myriadrf/LMS8001-Companion/docs/software/lms8suite.rst

LMS8 Suite
==========

LMS8 Suite is a cross-platform software tool for controlling the LMS8001 Companion board. It provides a graphical user interface (GUI) for configuring and managing the board's settings. The source code is provided and the GUI can be built under Windows and Linux. Additionally, a precompiled binary is available for Windows. 

* `LMS8 Suite GitHub repository`_
* `LMS8 Suite Windows download`_ 

.. note::
   Windows drivers and installation instructions are provided in the ``drivers\`` sub-directory.
