myriadrf/LMS8001-Companion/docs/reading/index.rst

Further Reading
===============

Please see also the following documentation:

* `LMS8001 Companion Board Quick Starter Manual`_
* `LMS8001 Companion Board Mixer Channel Programs Configuration`_
* `LMS8001 Companion Board Settling Times for Mixer Channel Programs Configuration`_
* `LMS8001 Documentation`_

.. _LMS8001 Companion Board Quick Starter Manual: https://downloads.myriadrf.org/project/lms8001-companion/LMS8001A_Companion_Quick_Starter_Manual_v2.pdf
.. _LMS8001 Companion Board Mixer Channel Programs Configuration: https://downloads.myriadrf.org/project/lms8001-companion/MixerChannelPrograms.pdf
.. _LMS8001 Companion Board Settling Times for Mixer Channel Programs Configuration: https://downloads.myriadrf.org/project/lms8001-companion/SettlingTimesForMixerChannelPrograms_v2.pdf
.. _LMS8001 Documentation: https://github.com/myriadrf/lms8001-docs
