myriadrf/LMS8001-Companion/hardware/3v1/KiCAD/12402143E512A_libs/12402143E512A.step

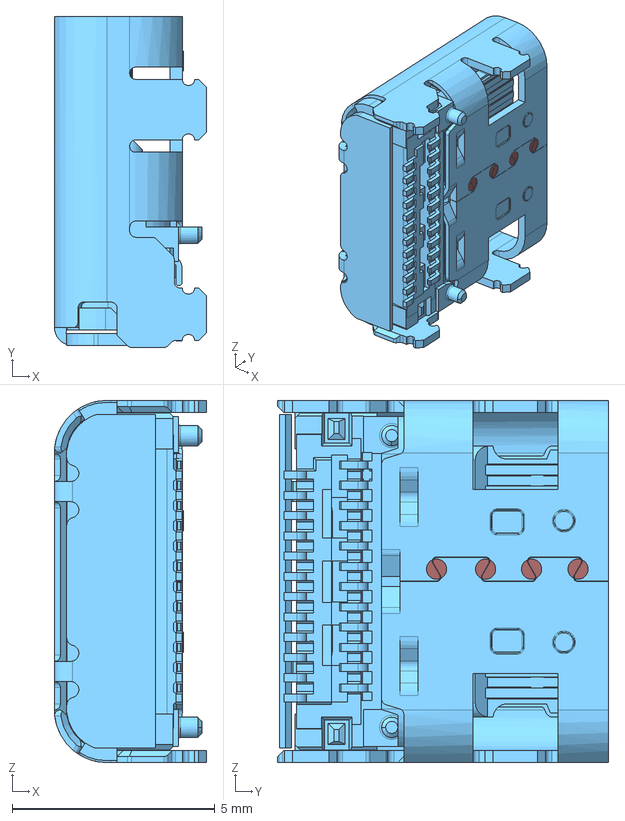
[picture p2: CAD file, 2025-08-01]
hardware/3v1/KiCAD/12402143E512A_libs/12402143E512A.step
3.76 x 8.17 x 8.94 mm
