myriadrf/LMS8001-Companion/drivers/Windows11_Driver_Installation.pdf

Windows 11 Driver Installation

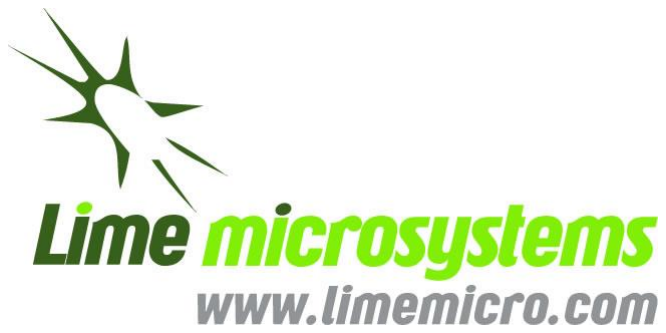
[picture p3: figure]

Lime Microsystems Limited

Surrey Technology Centre
Occam Road
The Surrey Research Park
Guildford, Surrey GU2 7YG
United Kingdom
Tel: | +44 (0) 1483 685 063
e-mail: | enquiries@limemicro.com

# LMS8001 Companion Board Windows 11 Driver Installation

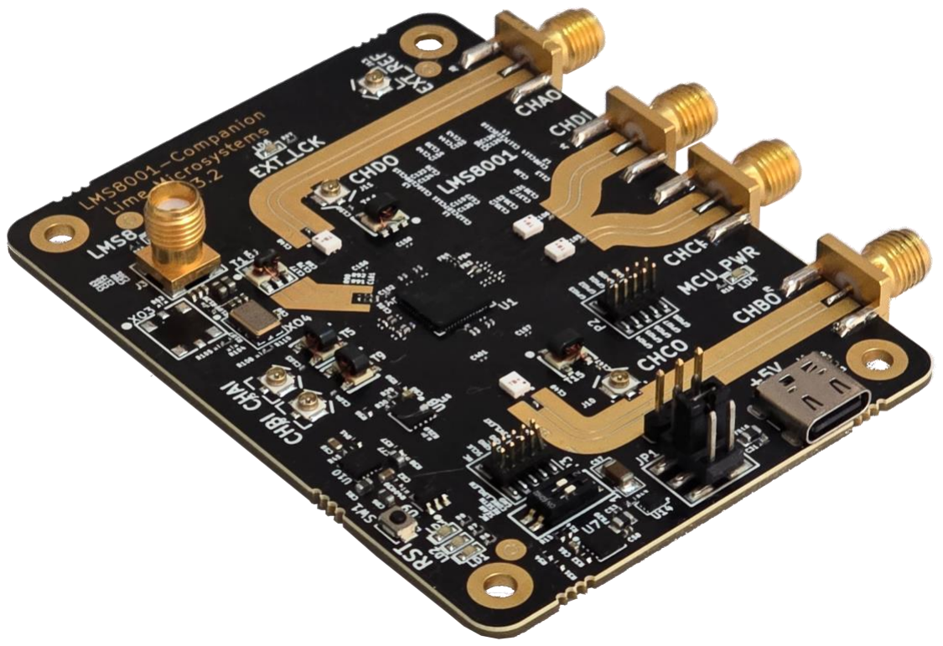
[picture p4: figure]

The information contained in this document is subject to change without prior notice. Lime Microsystems assumes no responsibility for its use, nor for infringement of patents or other rights of third parties. Lime Microsystems' standard terms and conditions apply at all times.

# DOCUMENT REVISION HISTORY

The following table shows the revision history of this document:

Date | Version | Description of Revisions
21/09/2026 | 1.0.0 | Initial version created.
05/10/2626 | 1.1.0 | Figures updated, text updated.

# Contents

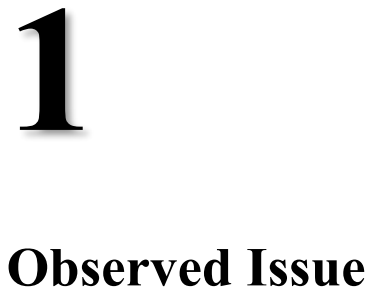
[picture p5: figure]
Observed Issue
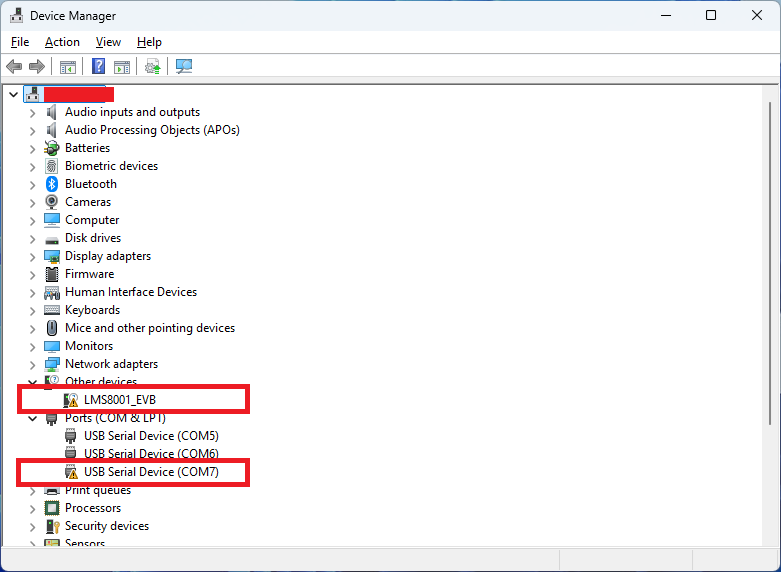
[picture p6: figure]

© Copyright Lime Microsystems

Version: 1.1.0 | Last modified: 05/10/2026 | 1

On Windows 11, when the evaluation board is connected to the computer, Device Manager shows the following:

Figure 1.1: Device Manager before driver installation

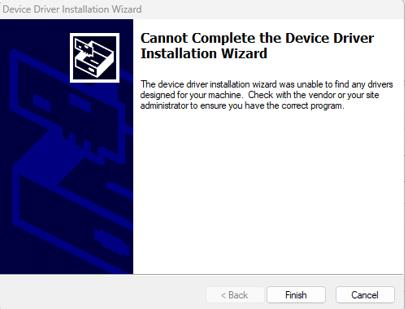
[picture p7: figure]

© Copyright Lime Microsystems Proprietary and Confidential

When the driver installation was tried using the dpinst_amd64.exe file, the installation failed.

Figure 1.2: Driver installation failed

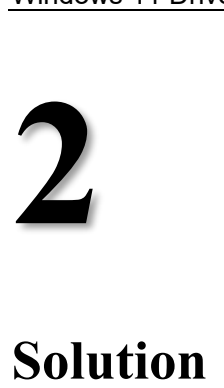
[picture p8: figure]
Solution
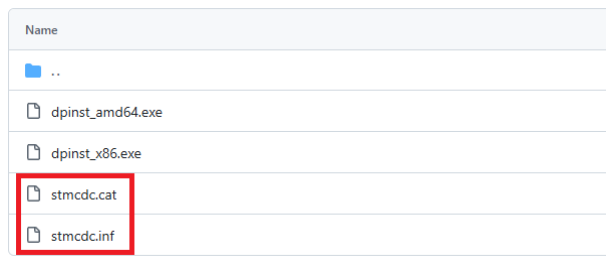
[picture p9: figure]

© Copyright Lime Microsystems

Install the driver manually. Download the .inf and .cat files from the link below: https://github.com/myriadrf/LMS8001-Companion/tree/master/drivers/STM32_VCP/Win8

Figure 2.1: Marked files for manual driver installation

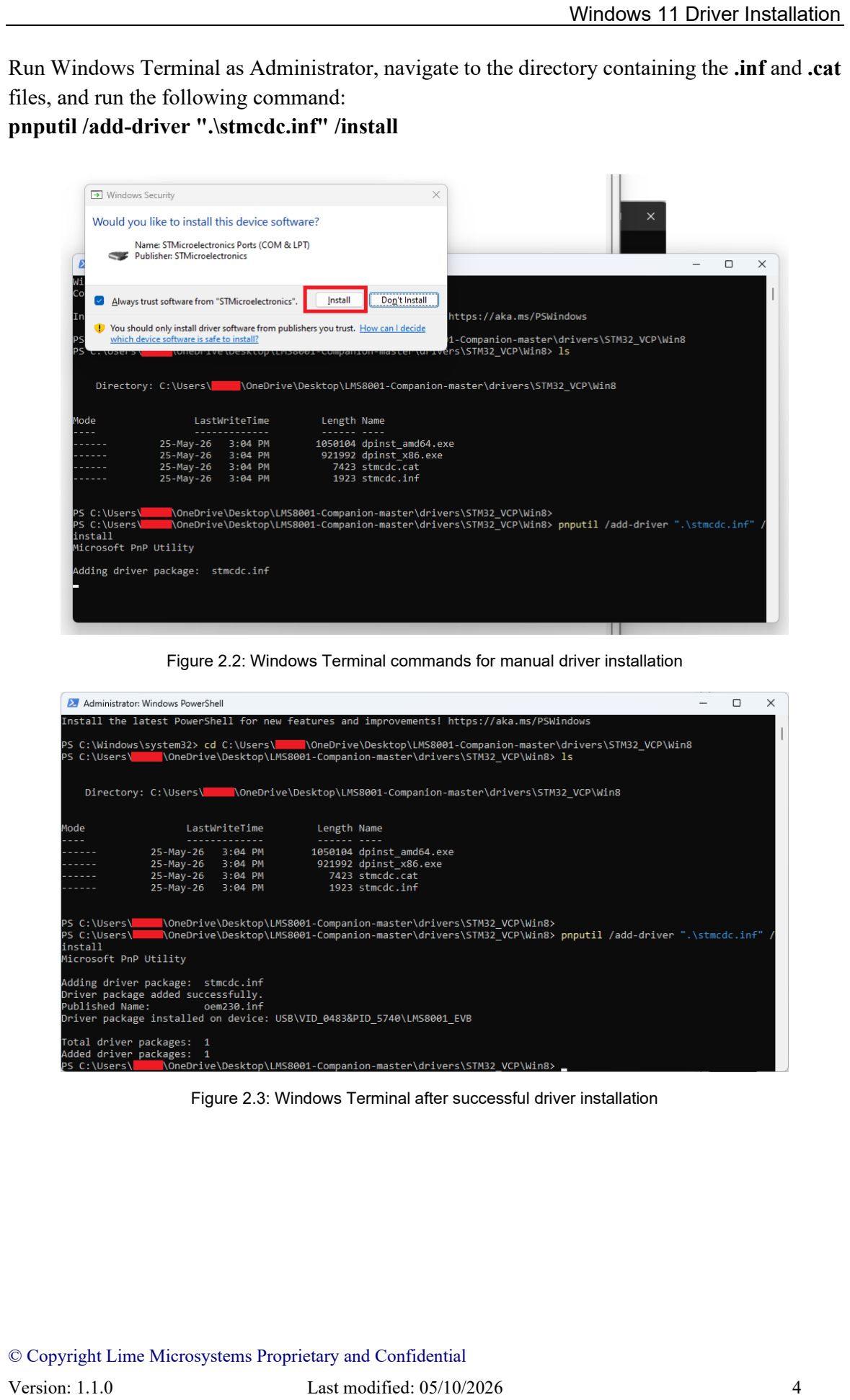
[picture p10: page 6]

© Copyright Lime Microsystems Proprietary and Confidential

Run Windows Terminal as Administrator, navigate to the directory containing the .inf and .cat files, and run the following command:
pnputil /add-driver ".\stmcdc.inf" /install

Figure 2.2: Windows Terminal commands for manual driver installation

Figure 2.3: Windows Terminal after successful driver installation

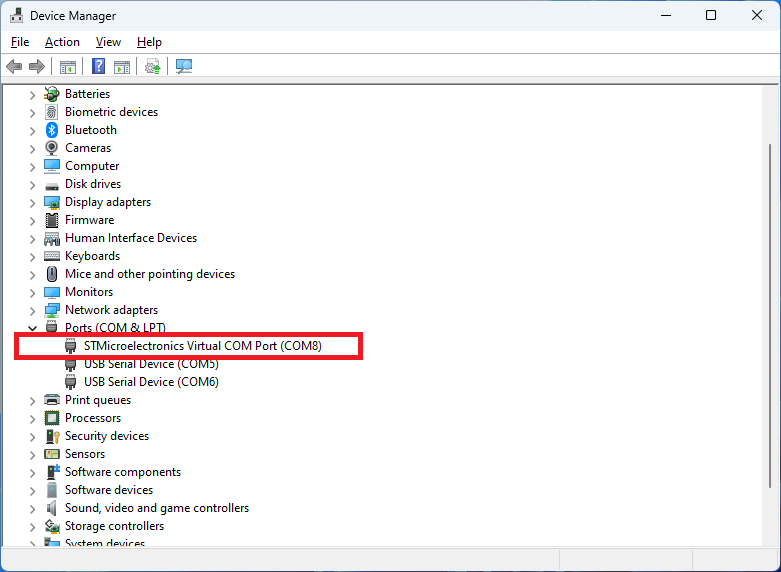
[picture p11: figure]

© Copyright Lime Microsystems

After this, Device Manager should show that the evaluation board is detected and that communication through the corresponding COM port has been established.

Figure 2.4: Device Manager after successful driver installation

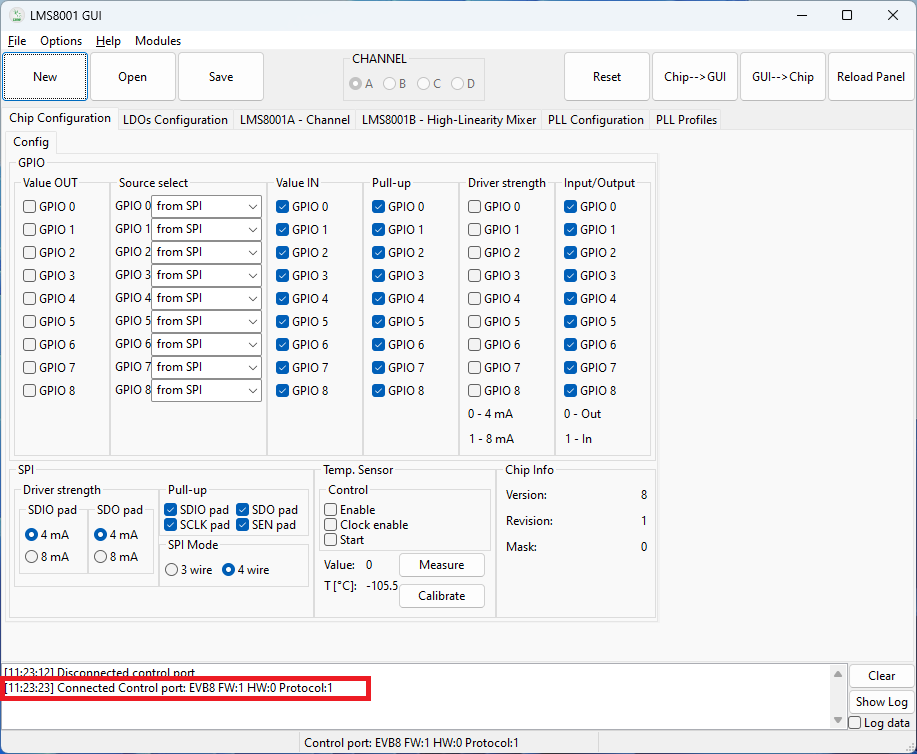
[picture p12: figure]

© Copyright Lime Microsystems Proprietary and Confidential

After successful driver installation, LimeSuite NG (or the lms8suite GUI) can be started, and the board can be connected to the GUI.

Figure 2.5: GUI after connecting to the board
