myriadrf/LMS8001-Companion/drivers/LMS8001-EVB_FW_Flashing_Driver_Installatin_v01r00.pdf

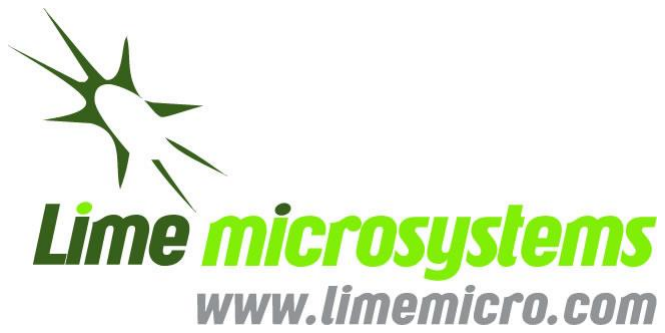
[picture p13: figure]

Lime Microsystems Limited

Surrey Tech Centre
Occam Road
The Surrey Research Park
Guildford GU2 7YG
Surrey
United Kingdom
Tel: | +44 (0) 1483 685 063
Fax: | +44 (0) 1428 656 662
e-mail: | enquiries@limemicro.com

## LMS8001-EVB Driver Installation and Firmware Flashing

## - Application Note -

Board version: | LMS8001-EVB
Board revision: | 01
Document version: | 01
Document revision: | 00
Last modified: | 11/02/16

# Contents

# Document Revision History

Version v01r0
Released: 11 Feb, 2016
Initial version.

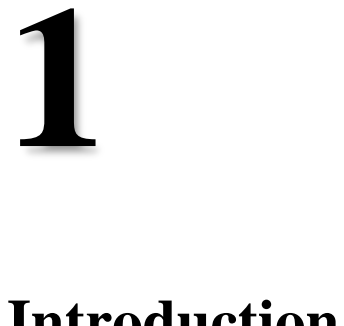
[picture p14: figure]

# Introduction

This document explains how to install drivers and perform device firmware update for LMS8001-EVB board.

## 1.1 General description

To communicate with LMS8001-EVB board, the specific Virtual COM port driver needs to be installed on the host PC.

LMS8001-EVB has a capability to perform a firmware update using USB connection. The firmware HEX file first needs to be converted to DFU (Device Firmware Update) format and then used to flash LMS8001-EVB using the tools provided. The tools required to perform LMS8001-EVB firmware update are located in /STM32_DFU/ directory of the LMS8001-EVB Tools package.

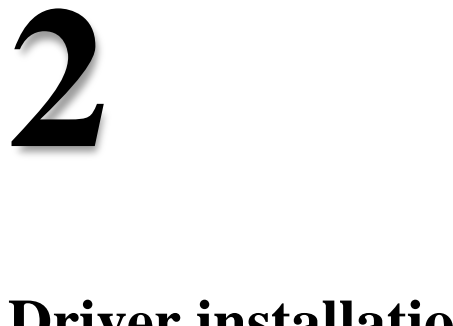
[picture p15: figure]

# Driver installation

## 2.1 Virtual COM port driver

LMS8001-EVB communicates with PC via USB Virtual COM port. To install the required virtual com port driver on your system the following steps need to be performed:
1. Go to /STM32_VCP/Driver/ directory of the LMS8001-EVB Tools package;
2. Depending on the version of windows that your system is running go to /Win7 or /Win8 directory;
3. If you are running 32-bit windows launch dpinst_x86.exe, or if you are running 64-bit windows launch dpinst_amd64.exe.
4. Click ‘Next’ when driver installation wizard appears (Figure 1) and wait.

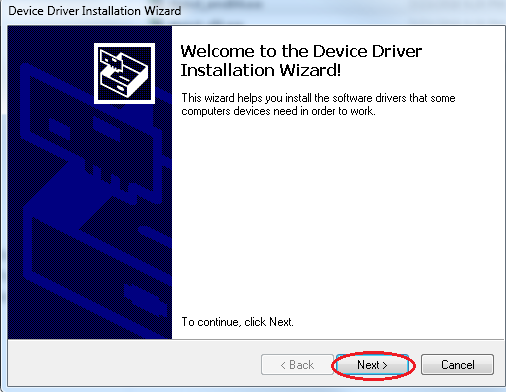
[picture p16: figure]

Figure 1 Driver installation
5. Click ‘Finish’ when the window shown in Figure 2 appears to complete installation.

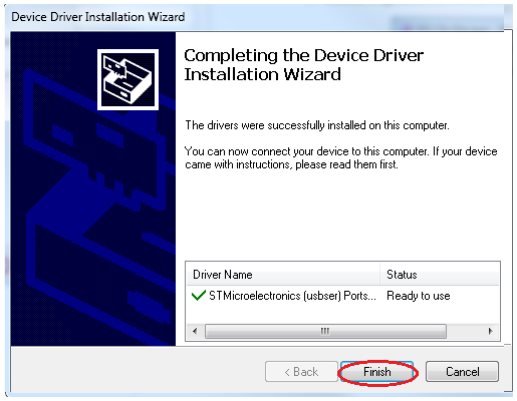
[picture p17: figure]

Figure 2 VCP Driver installation

## 2.2 DFU Driver

The DFU device driver is necessary to perform LMS8001-EVB firmware update. To install DFU device driver on your system the following steps need to be performed:
1. Go to /STM32_DFU/Driver/ directory of the LMS8001-EVB Tools package;
2. Depending on the version of windows that your system is running go to /Win7 or /Win8 directory;
3. If you are running 32-bit windows launch dpinst_x86.exe, or if you are running 64-bit windows launch dpinst_amd64.exe.
4. Click ‘Next’ when driver installation wizard appears (Figure 1) and wait.
5. Click ‘Finish’ when the window shown in Figure 3 appears to complete installation.

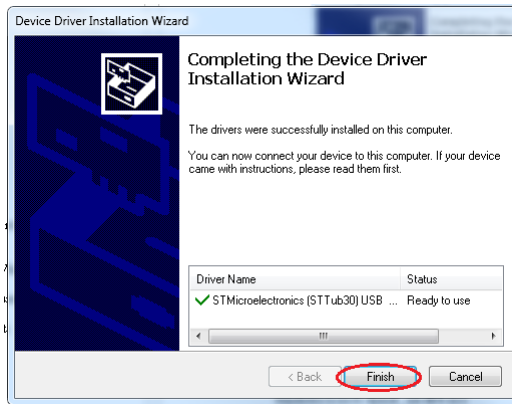
[picture p18: figure]

Figure 3 DFU Driver installation

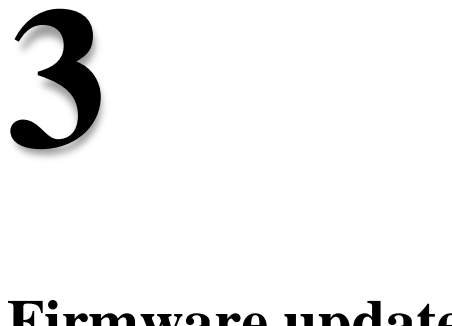
[picture p19: figure]

# Firmware update procedure

## 3.1 Creating DFU file from HEX

This procedure is only required if you need to use a firmware file that is in HEX format. If you have downloaded firmware that is already in DFU format skip this chapter.
A file in HEX format cannot be directly uploaded to LMS8001-EVB. It must be first converted to DFU file format using the following steps:
1. Start DFU File Manager application (DfuFileMgr.exe);
2. Choose to generate DFU from HEX (Figure 4);

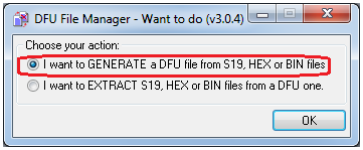
[picture p20: figure]

Figure 4 DFU File Manager start-up screen
3. In the main window of the DFU file manager click ‘S19 or Hex’ button (Figure 5). A file open dialog should appear. Use it to select the HEX file to convert to DFU format.

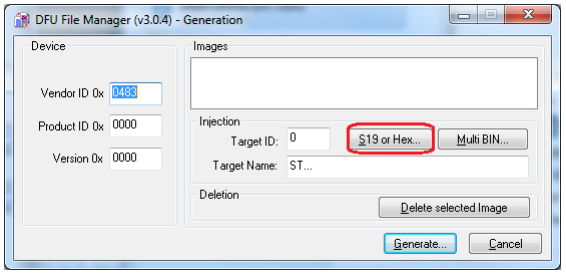
[picture p21: figure]

Figure 5 DFU File Manager main window
4. Click “Generate” button (Figure 6) and chose a filename for DFU file in the dialog that appears.

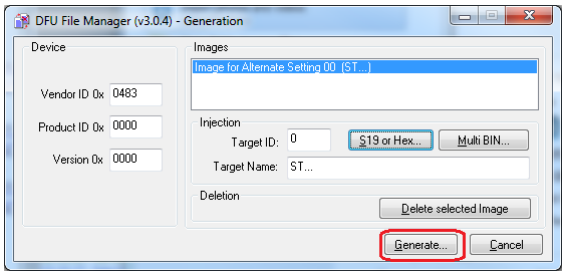
[picture p22: figure]

Figure 6 DFU File Manager main window
5. A message shown in Figure 7 should appear if DFU file has been generated successfully. Click OK and close DFU file manager.

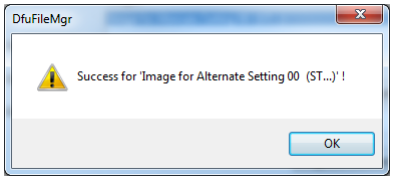
[picture p23: figure]

Figure 7 DFU File Manager message

## 3.2 Uploading firmware to LMS8001-EVB

To upload DFU firmware file to LMS8001-EVB the following steps need to be performed:

1. Set jumper PWR_IN to EXT and connect external 5V power supply (header J56).
2. Connect LMS8001-EVB to your PC via USB.
3. Set MCU BOOT switch on LMS8001-EVB board to the following positions:
- BOOT0 – High Level (MCU BOOT switch 1 – On)
- BOOT1 – Low Level (MCU BOOT switch 2 – Off)
4. Press Reset button on LMS8001-EVB board. The device should be detected by your PC. It should appear in the Windows Device Manager under the name of ‘STM Device in DFU Mode’ as shown in Figure 8.

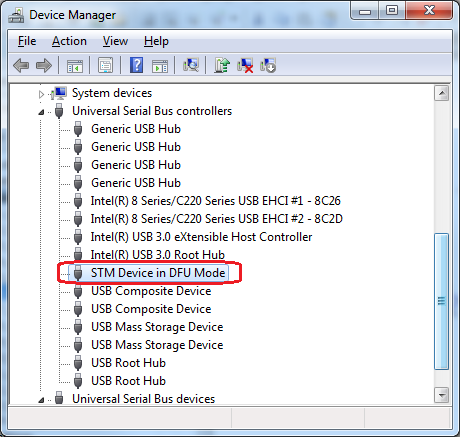
[picture p24: figure]

Figure 8 DFU Device in Windows Device Manager
5. Start ‘DfuSe Demo’ application (DfuSeDemo.exe).
6. Make sure that:
- The board is detected by application (Figure 9-A);
- The internal flash is selected for programming (Figure 9-B);
7. Click “Choose” to select the DFU file, which shall be used for firmware update (Figure 9-C). When the firmware file is successfully loaded the text “File correctly loaded.” is displayed at the bottom of the main application window.

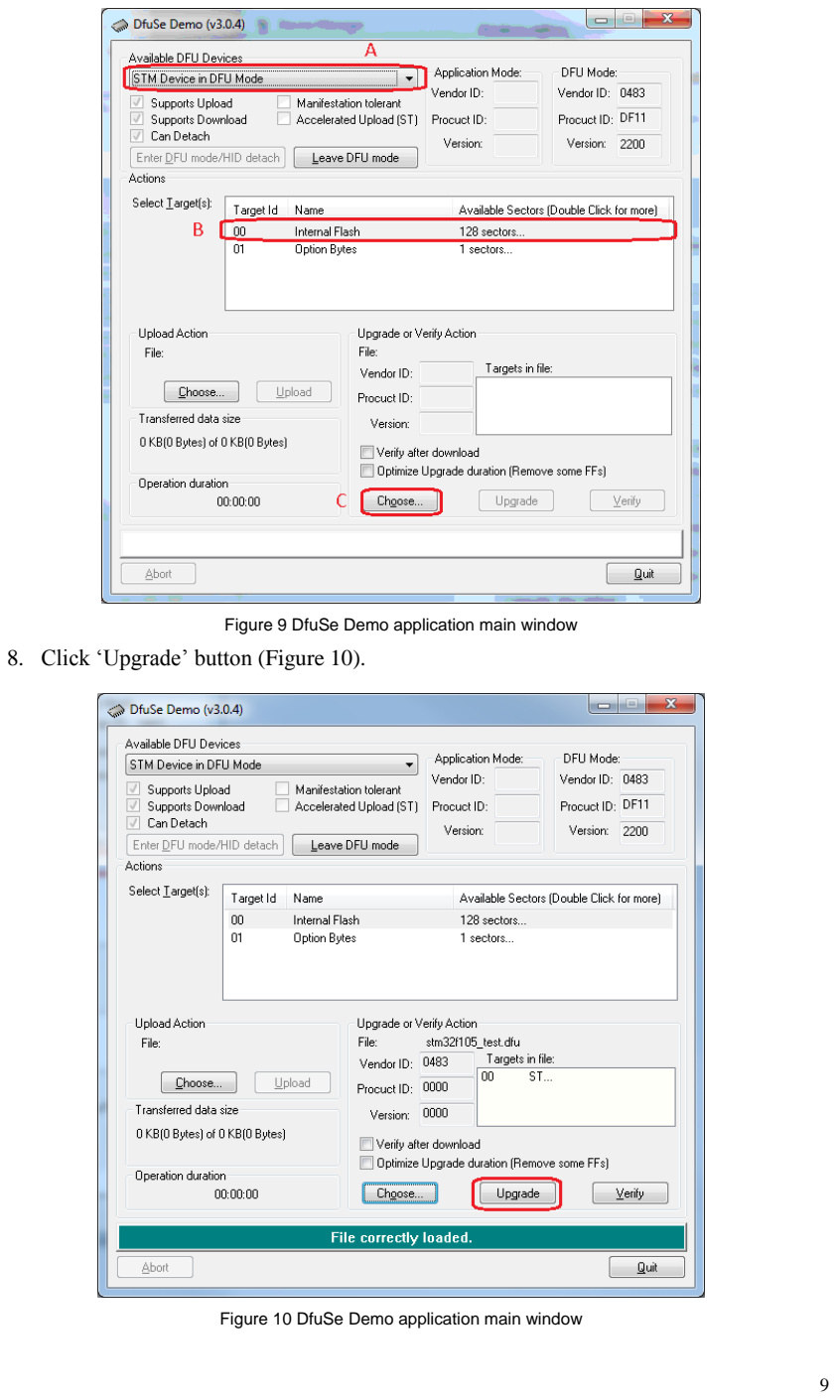
[picture p25: page 13]

Figure 9 DfuSe Demo application main window
8. Click ‘Upgrade’ button (Figure 10).

Figure 10 DfuSe Demo application main window

9. When the pop-up prompt (Figure 11) appears, click “Yes” to start flashing firmware.

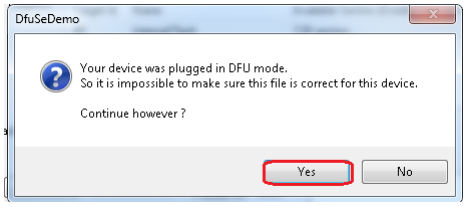
[picture p26: figure]

Figure 11 DfuSe Demo application pop-up prompt
10. The text “Target 00: Upgrade successful !” will be displayed at the bottom of the main application window when the firmware update completes successfully
11. Set MCU BOOT switch on LMS8001-EVB board to the following positions:
- BOOT0 – Low Level (MCU BOOT switch 1 – Off)
- BOOT0 – Low Level (MCU BOOT switch 2 – Off)
12. Press ‘Reset’ button on LMS8001-EVB board. The board should now start running with the updated firmware.
