myriadrf/LMS8001-Companion/hardware/3v2/Manufacturing/PCB_Stackup.pdf

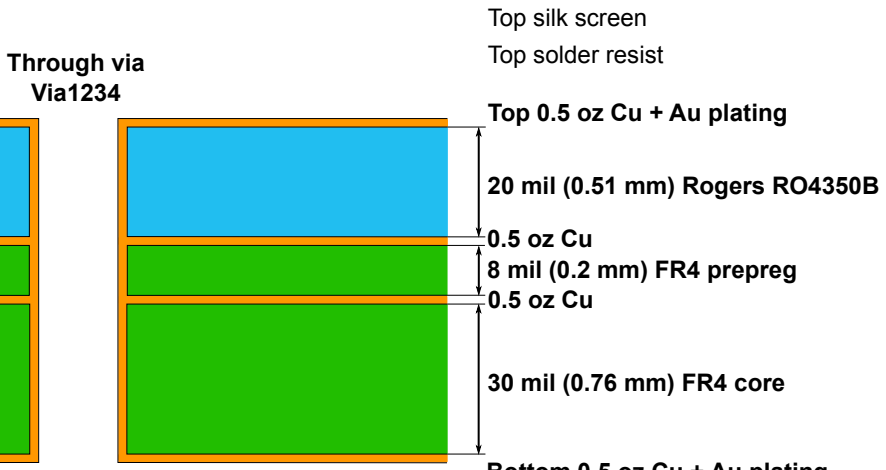
[picture p76: figure]
Through via Via1234; Top silk screen Top solder resist; Top 0.5 oz Cu + Au plating; 20 mil (0.51 mm) Rogers RO4350B; 8 mil (0.2 mm) FR4 prepreg; 30 mil (0.76 mm) FR4 core
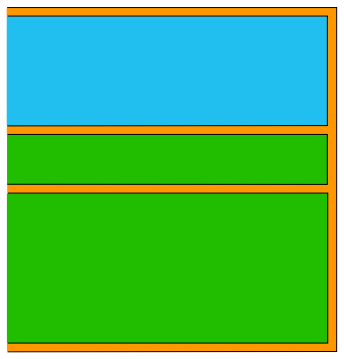
[picture p77: figure]

Bottom 0.5 oz Cu + Au plating

Bottom solder resist
Bottom slik screen

# PCB Layer Stack-up
