myriadrf/LMS8001-Companion/hardware/2v1/PDF/LMS8001_Companion_2v1_Drill.pdf

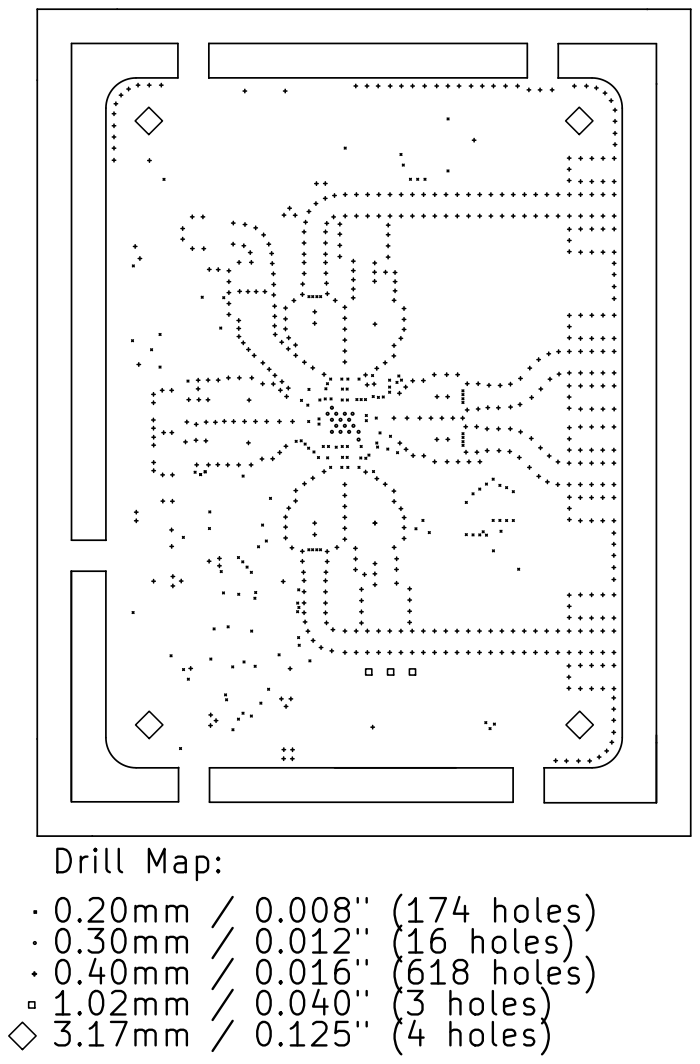
[picture p78: page 1]
Drill Map: 0.20mm / 0.008" (174 holes) 0.30mm / 0.012" (16 holes) 0.40mm / 0.016" (618 holes) 1.02mm / 0.040" (3 holes) 3.17mm / 0.125" (4 holes)

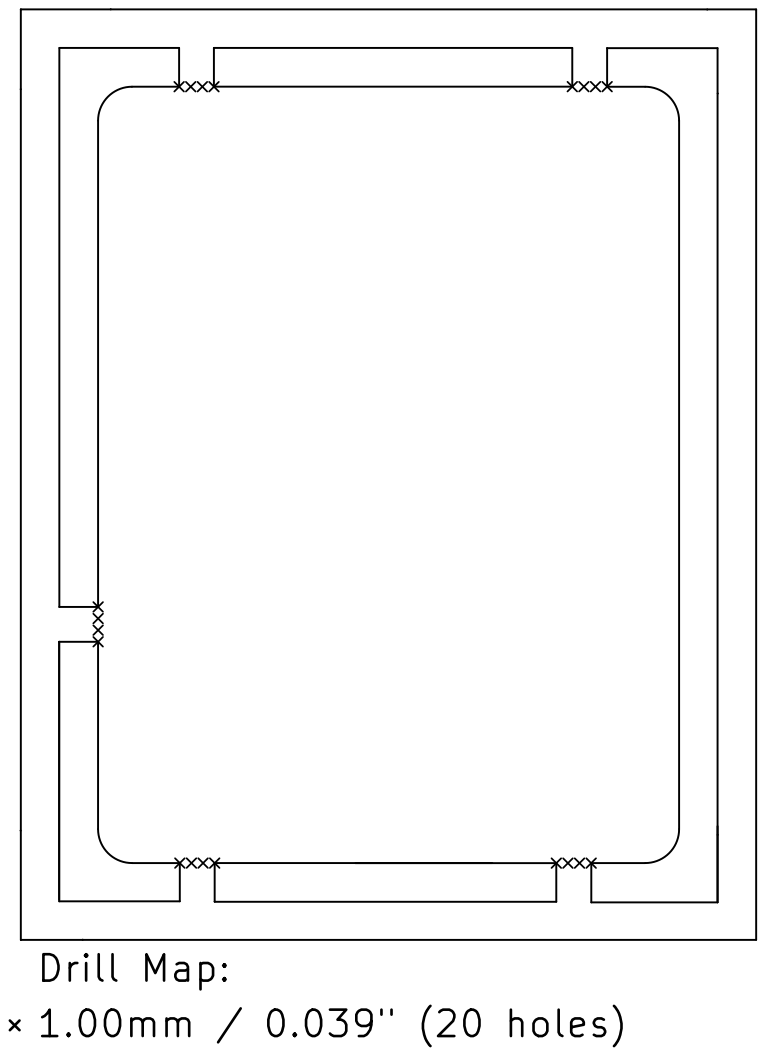
[picture p79: page 2]
Drill Map: 1.00mm / 0.039" (20 holes)
