myriadrf/LMS8001-Companion/hardware/3v2/PDF/LMS8001_Companion_Layout.pdf

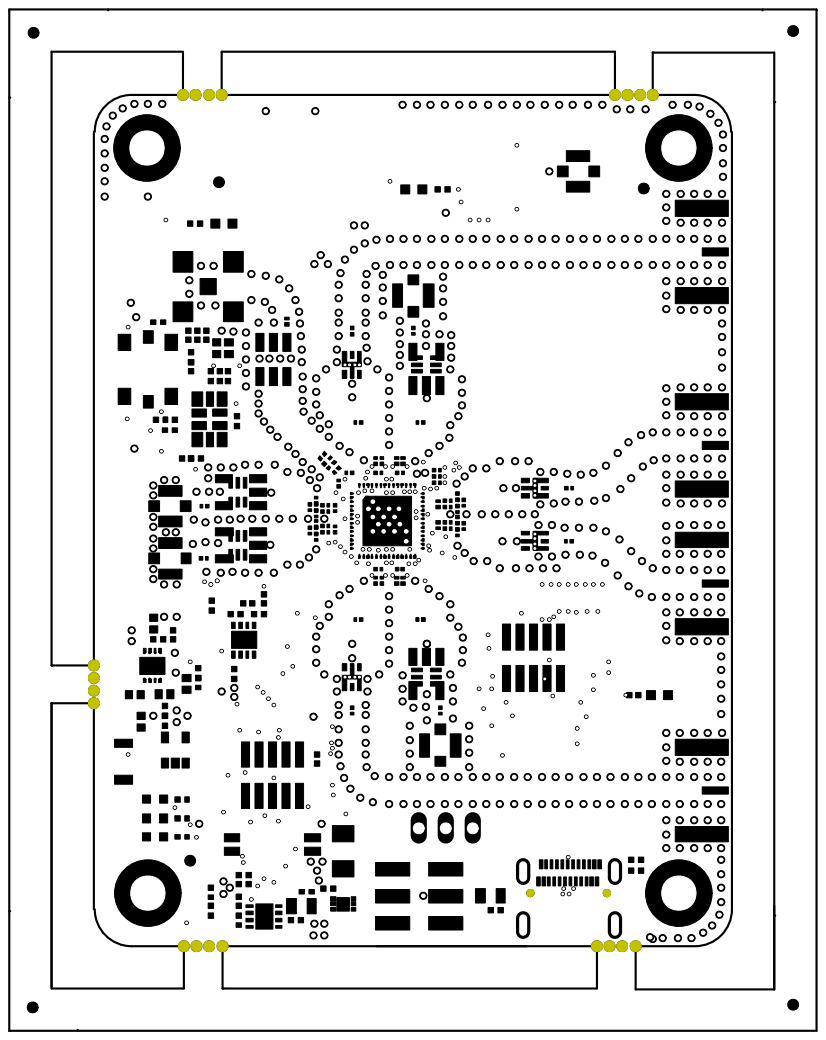
[picture p80: page 1]

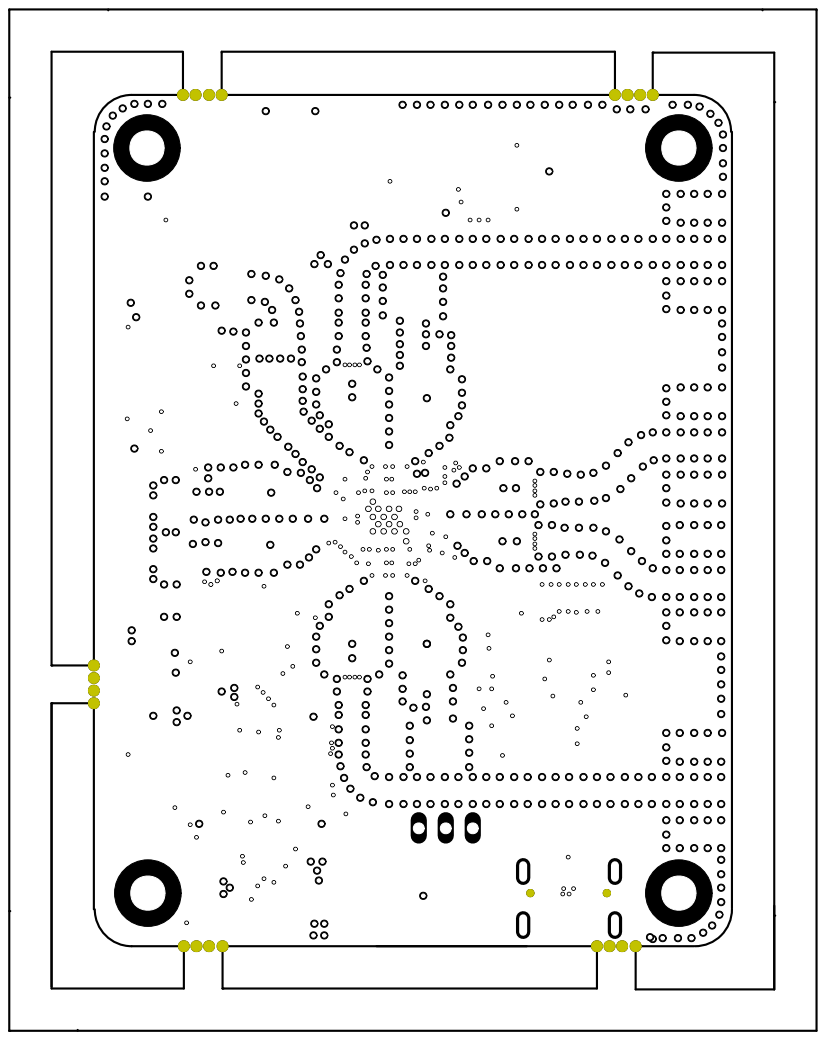
[picture p81: page 2]

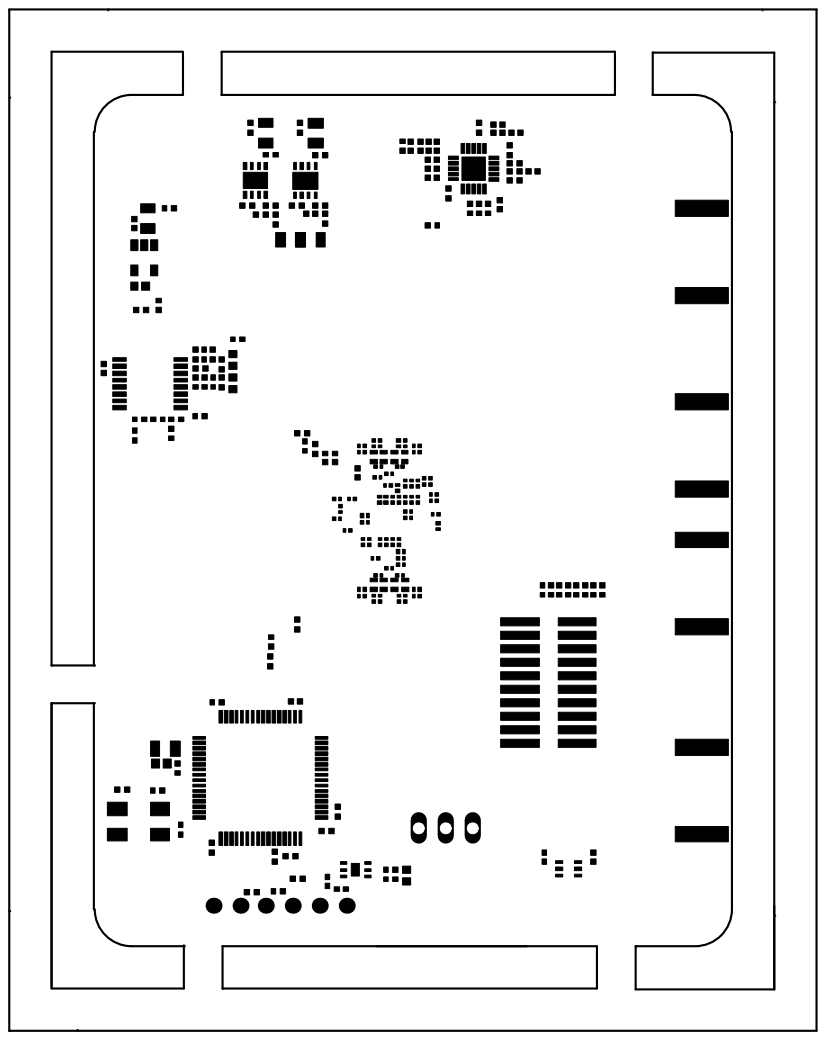
[picture p82: page 3]

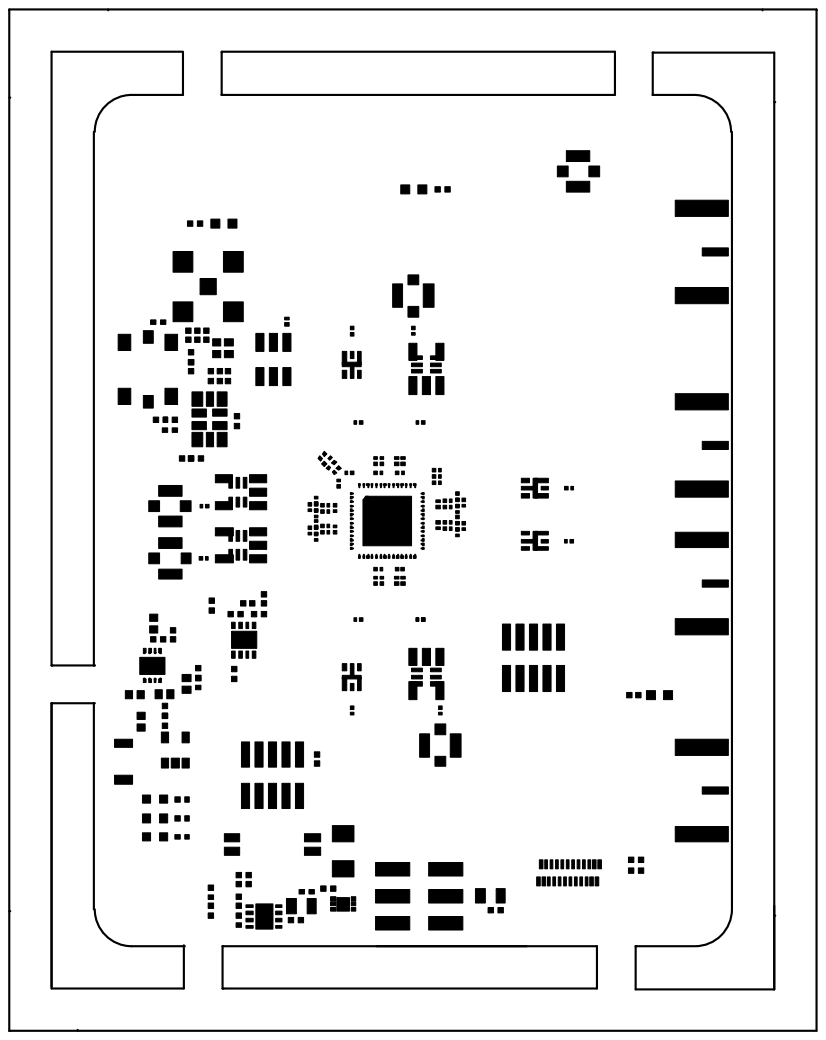
[picture p83: page 4]

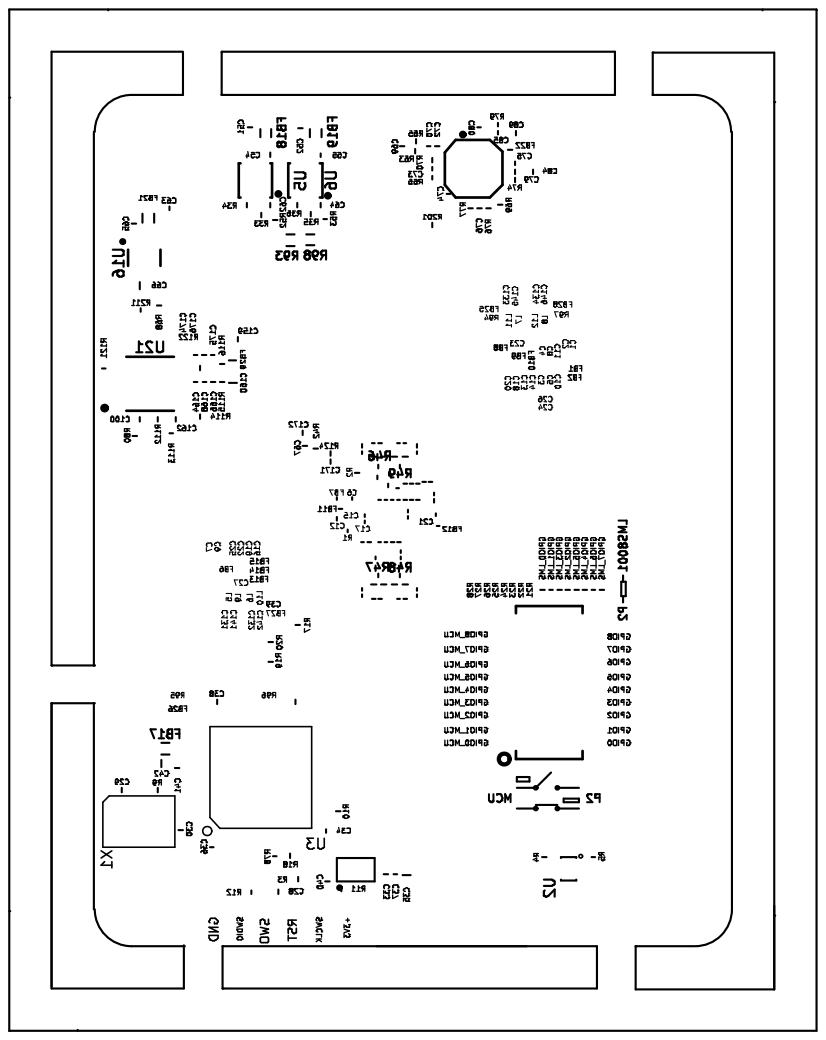
[picture p84: page 5]

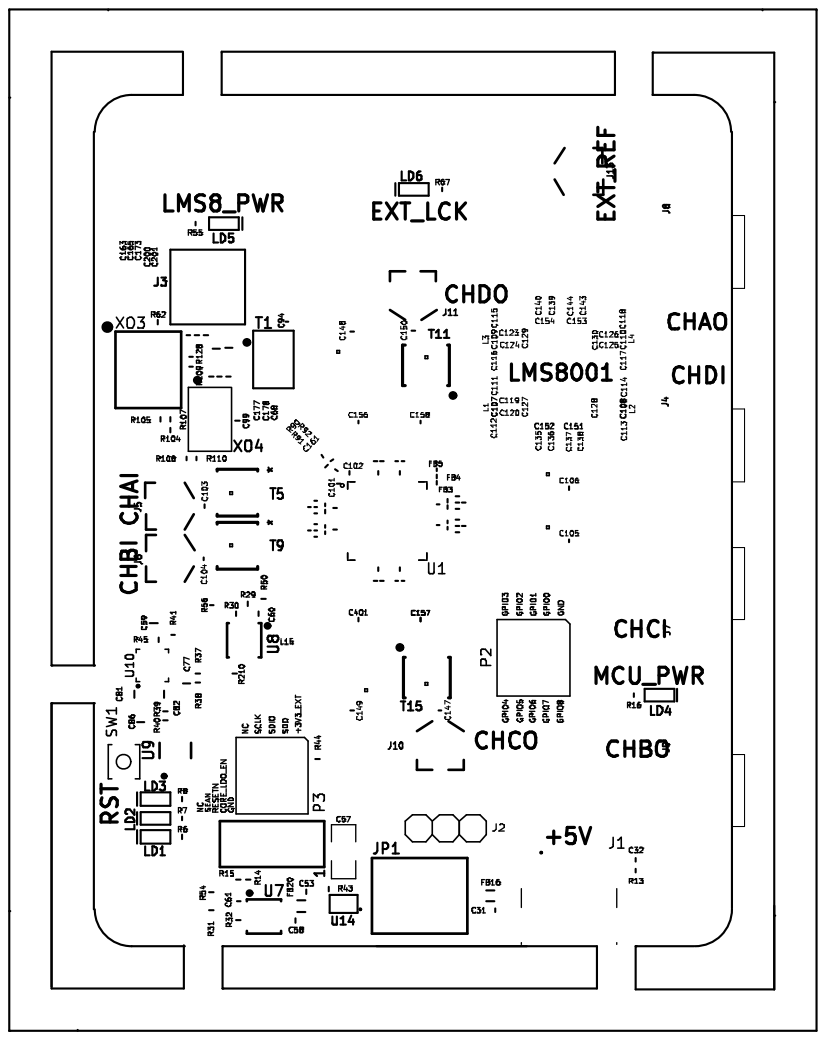
[picture p85: page 6]

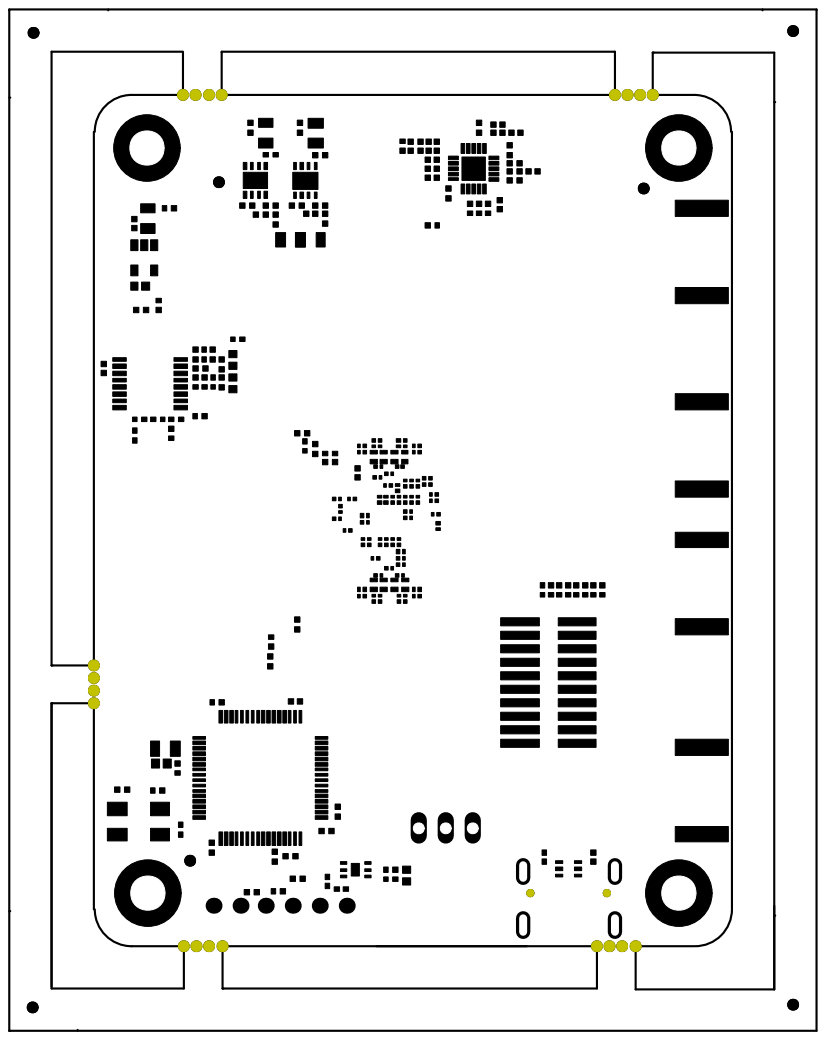
[picture p86: page 7]

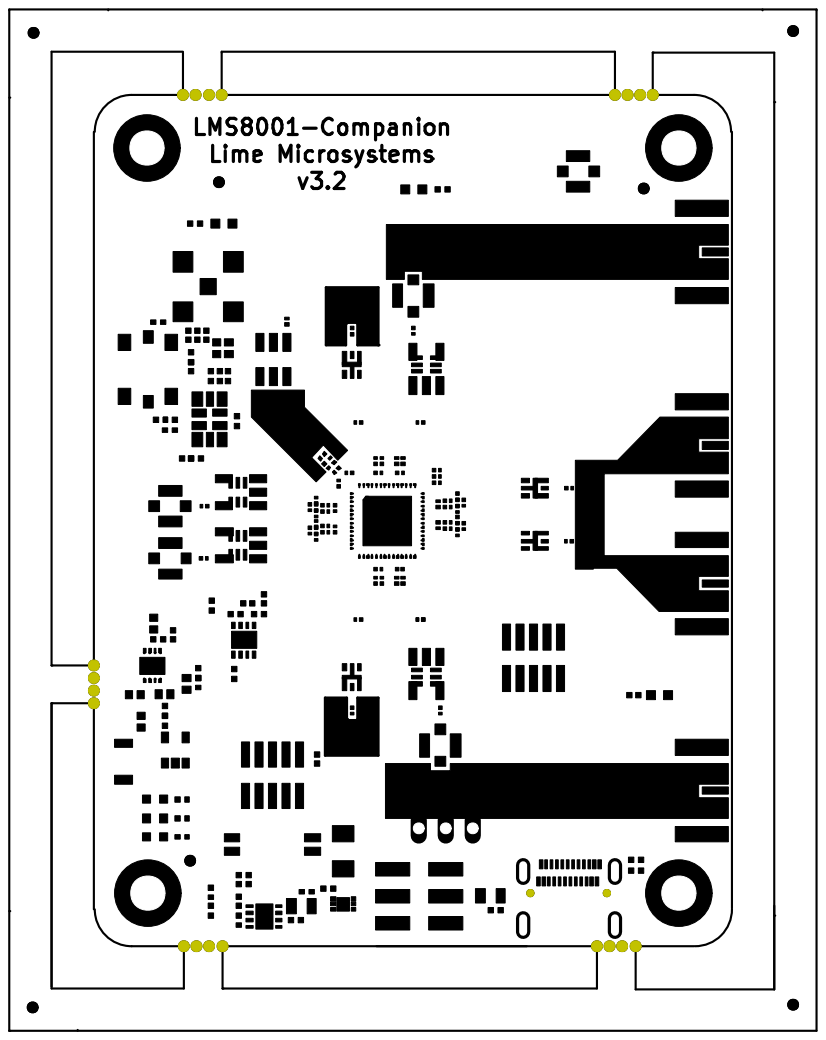
[picture p87: page 8]

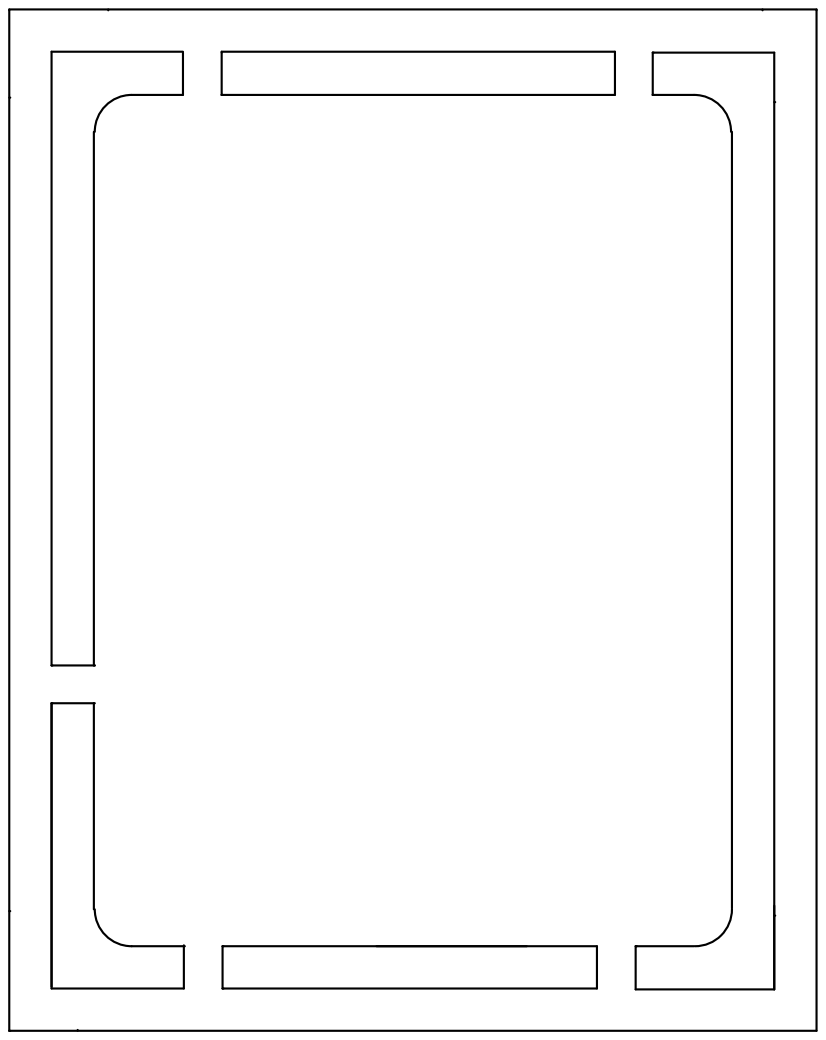
[picture p88: page 9]
