myriadrf/LMS8001-Companion/hardware/3v1/PDF/LMS8001_Companion_3v1_Layout.pdf

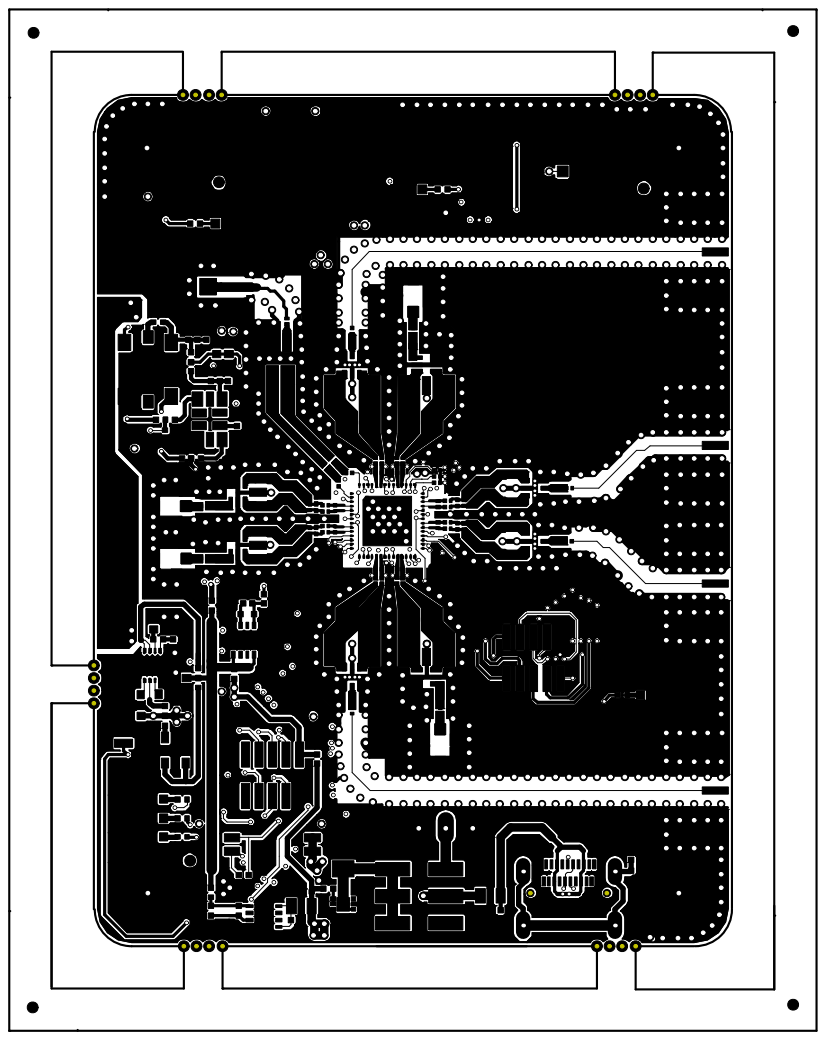
[picture p95: page 1]

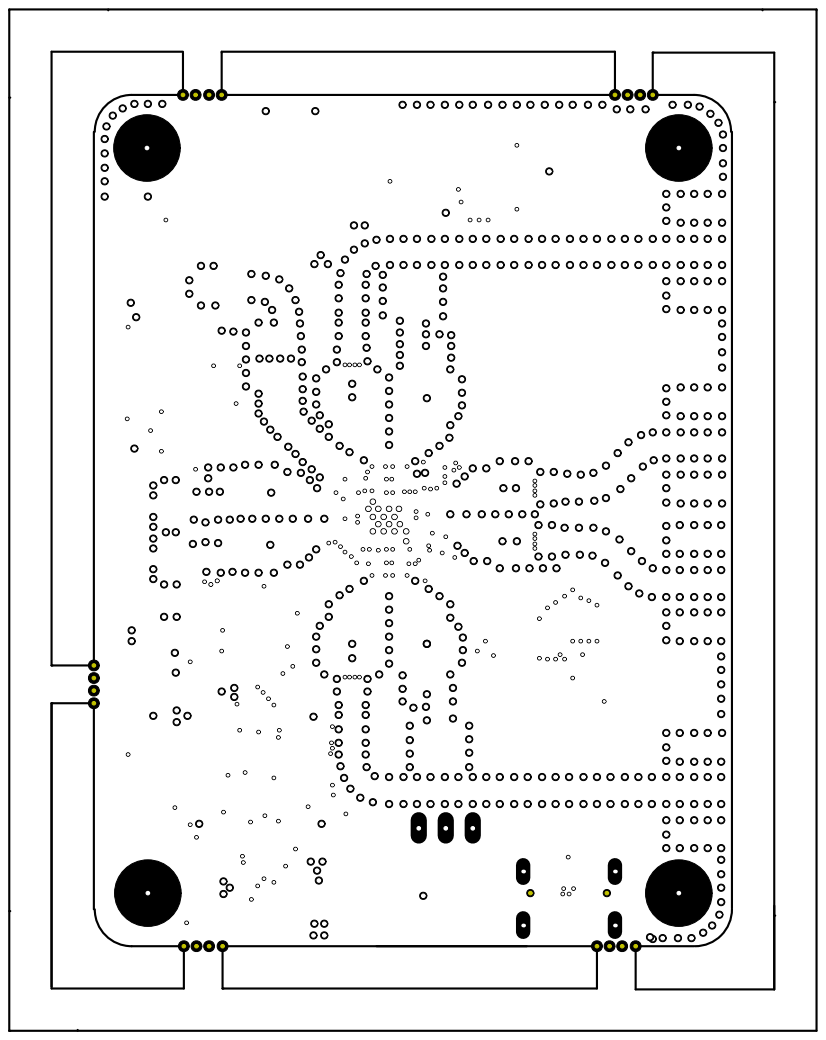
[picture p96: page 2]

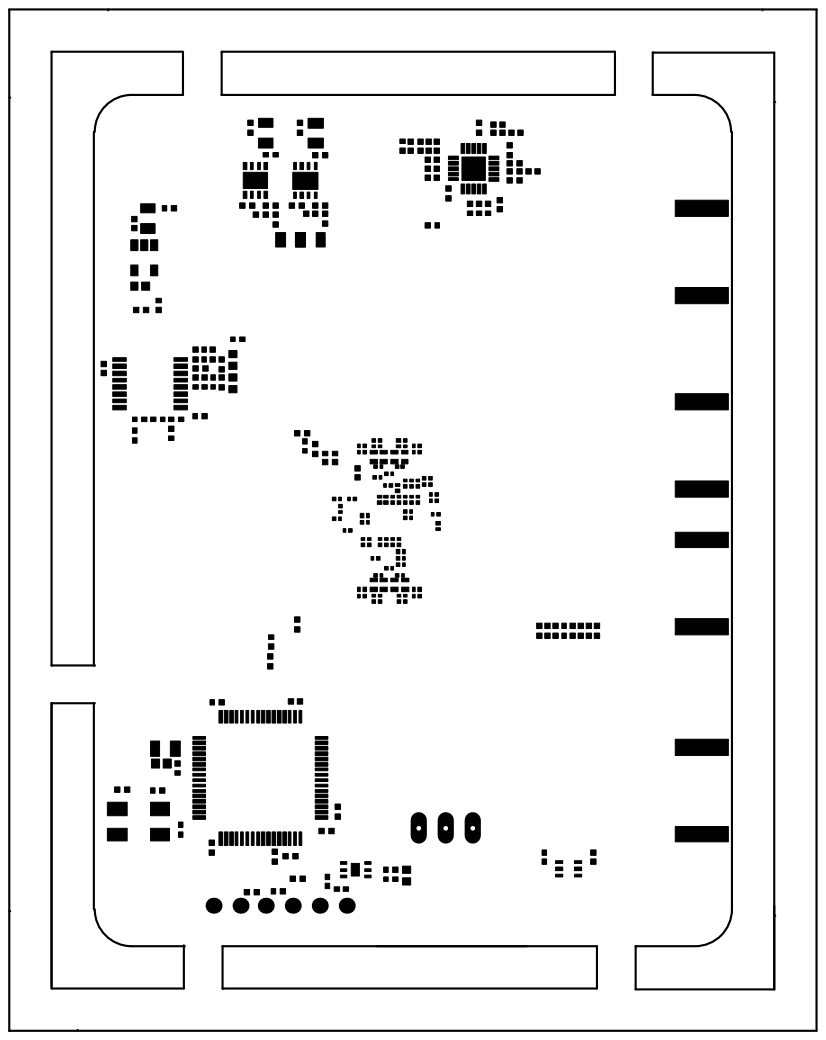
[picture p97: page 3]

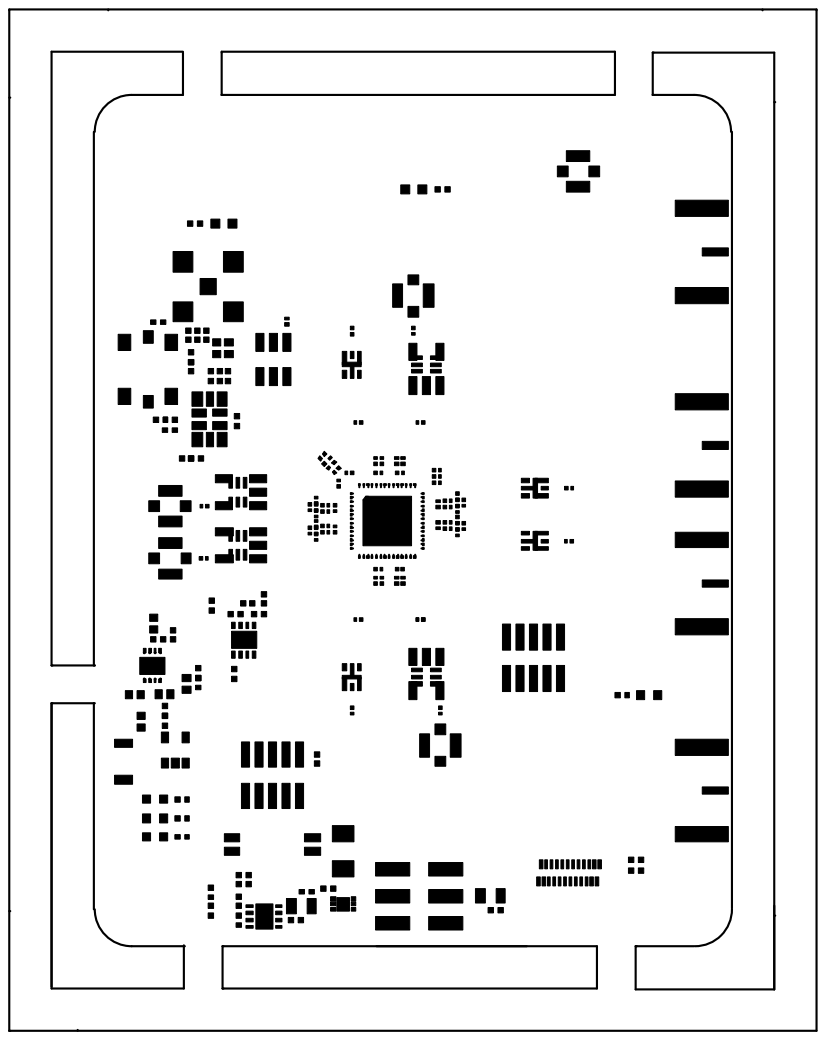
[picture p98: page 4]

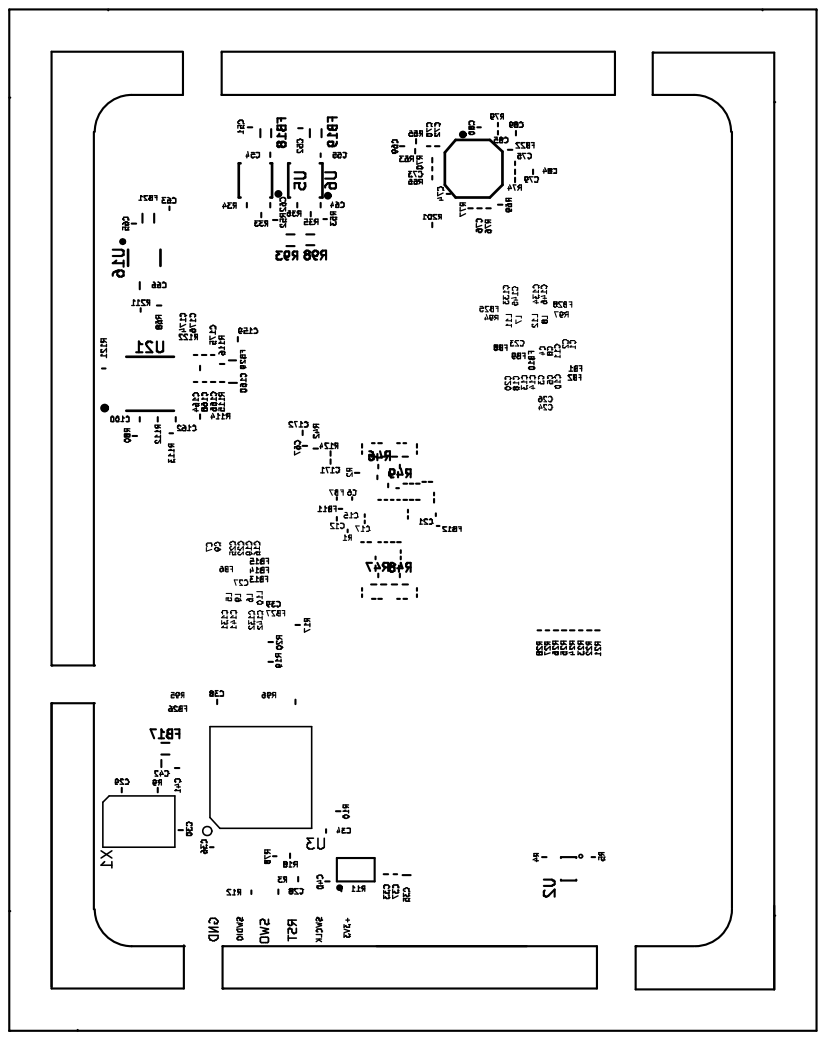
[picture p99: page 5]

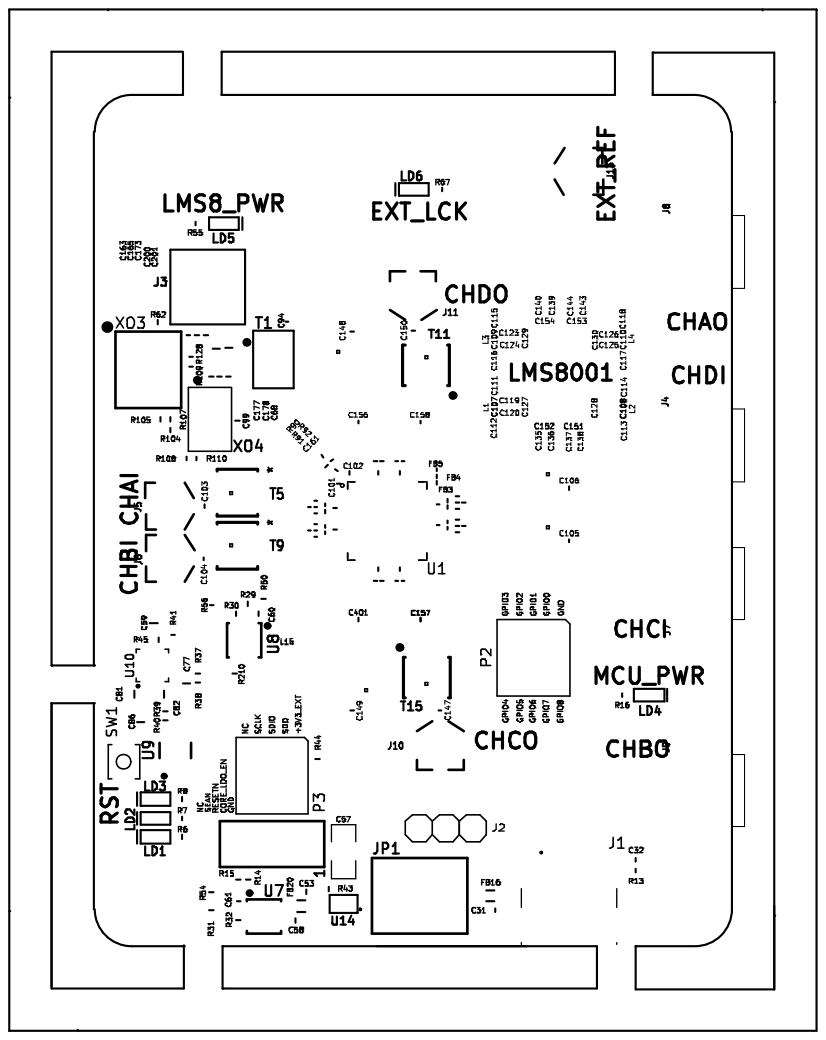
[picture p100: page 6]

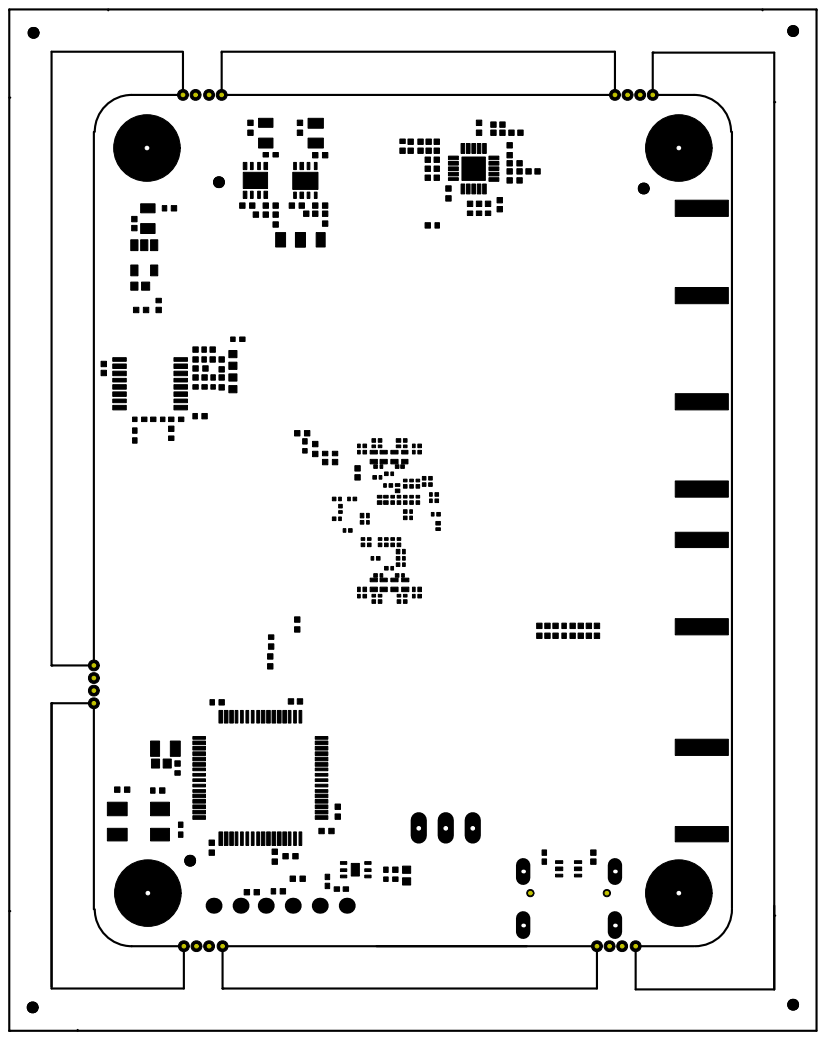
[picture p101: page 7]

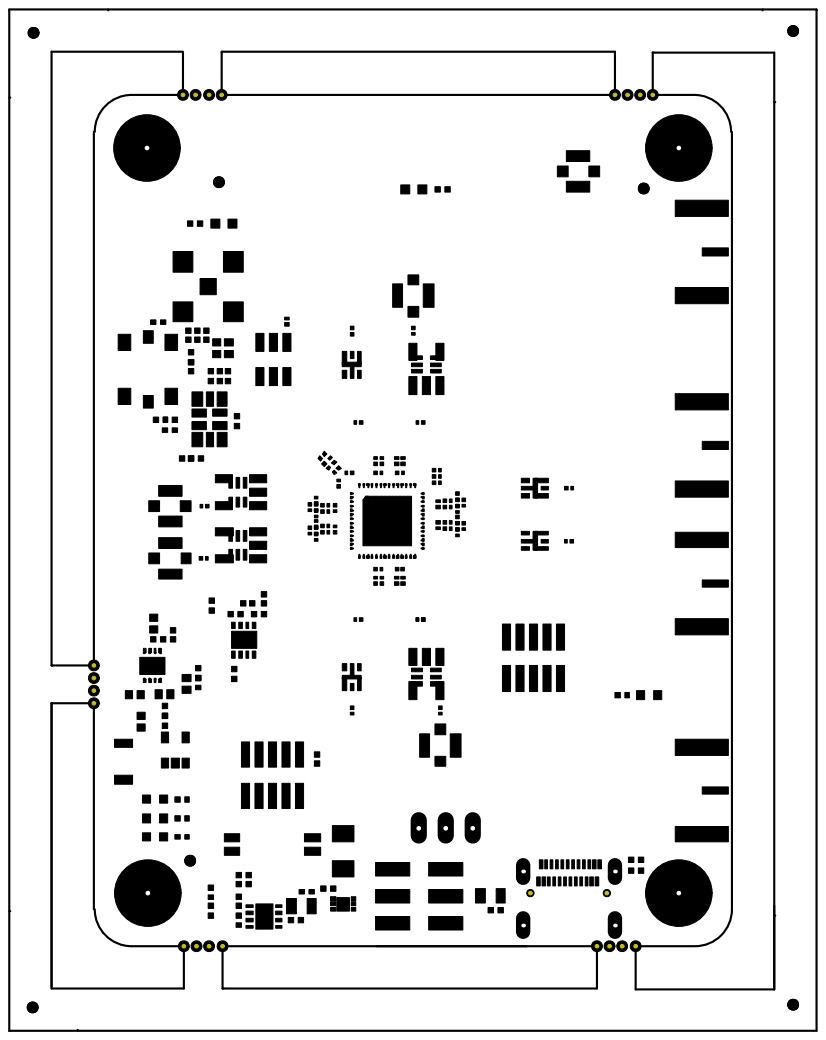
[picture p102: page 8]
