myriadrf/LMS8001-Companion/hardware/3v1/PDF/LMS8001_Companion_3v1_Schematic.pdf

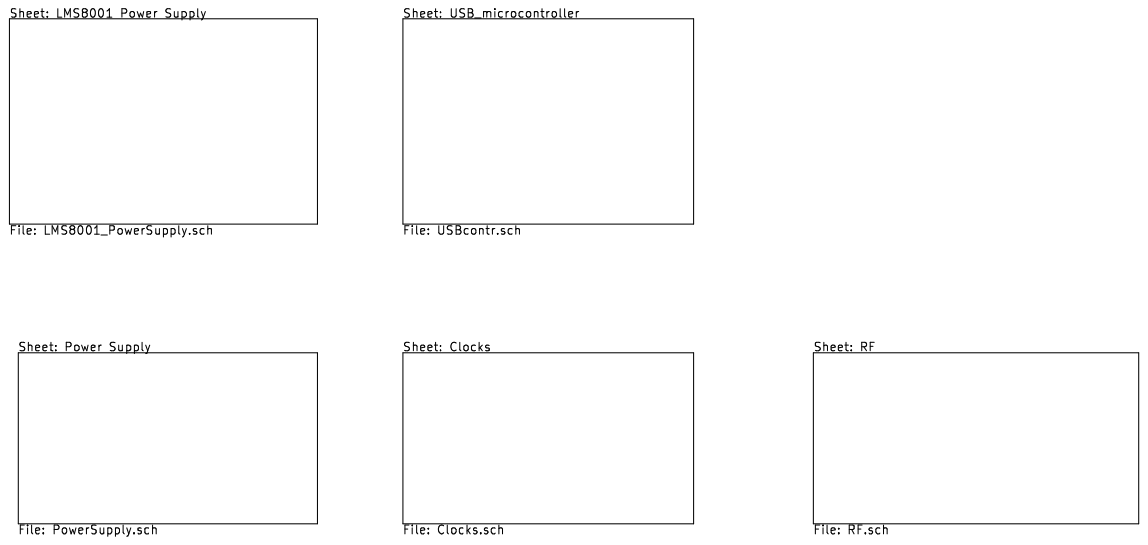
[picture p103: page 1]

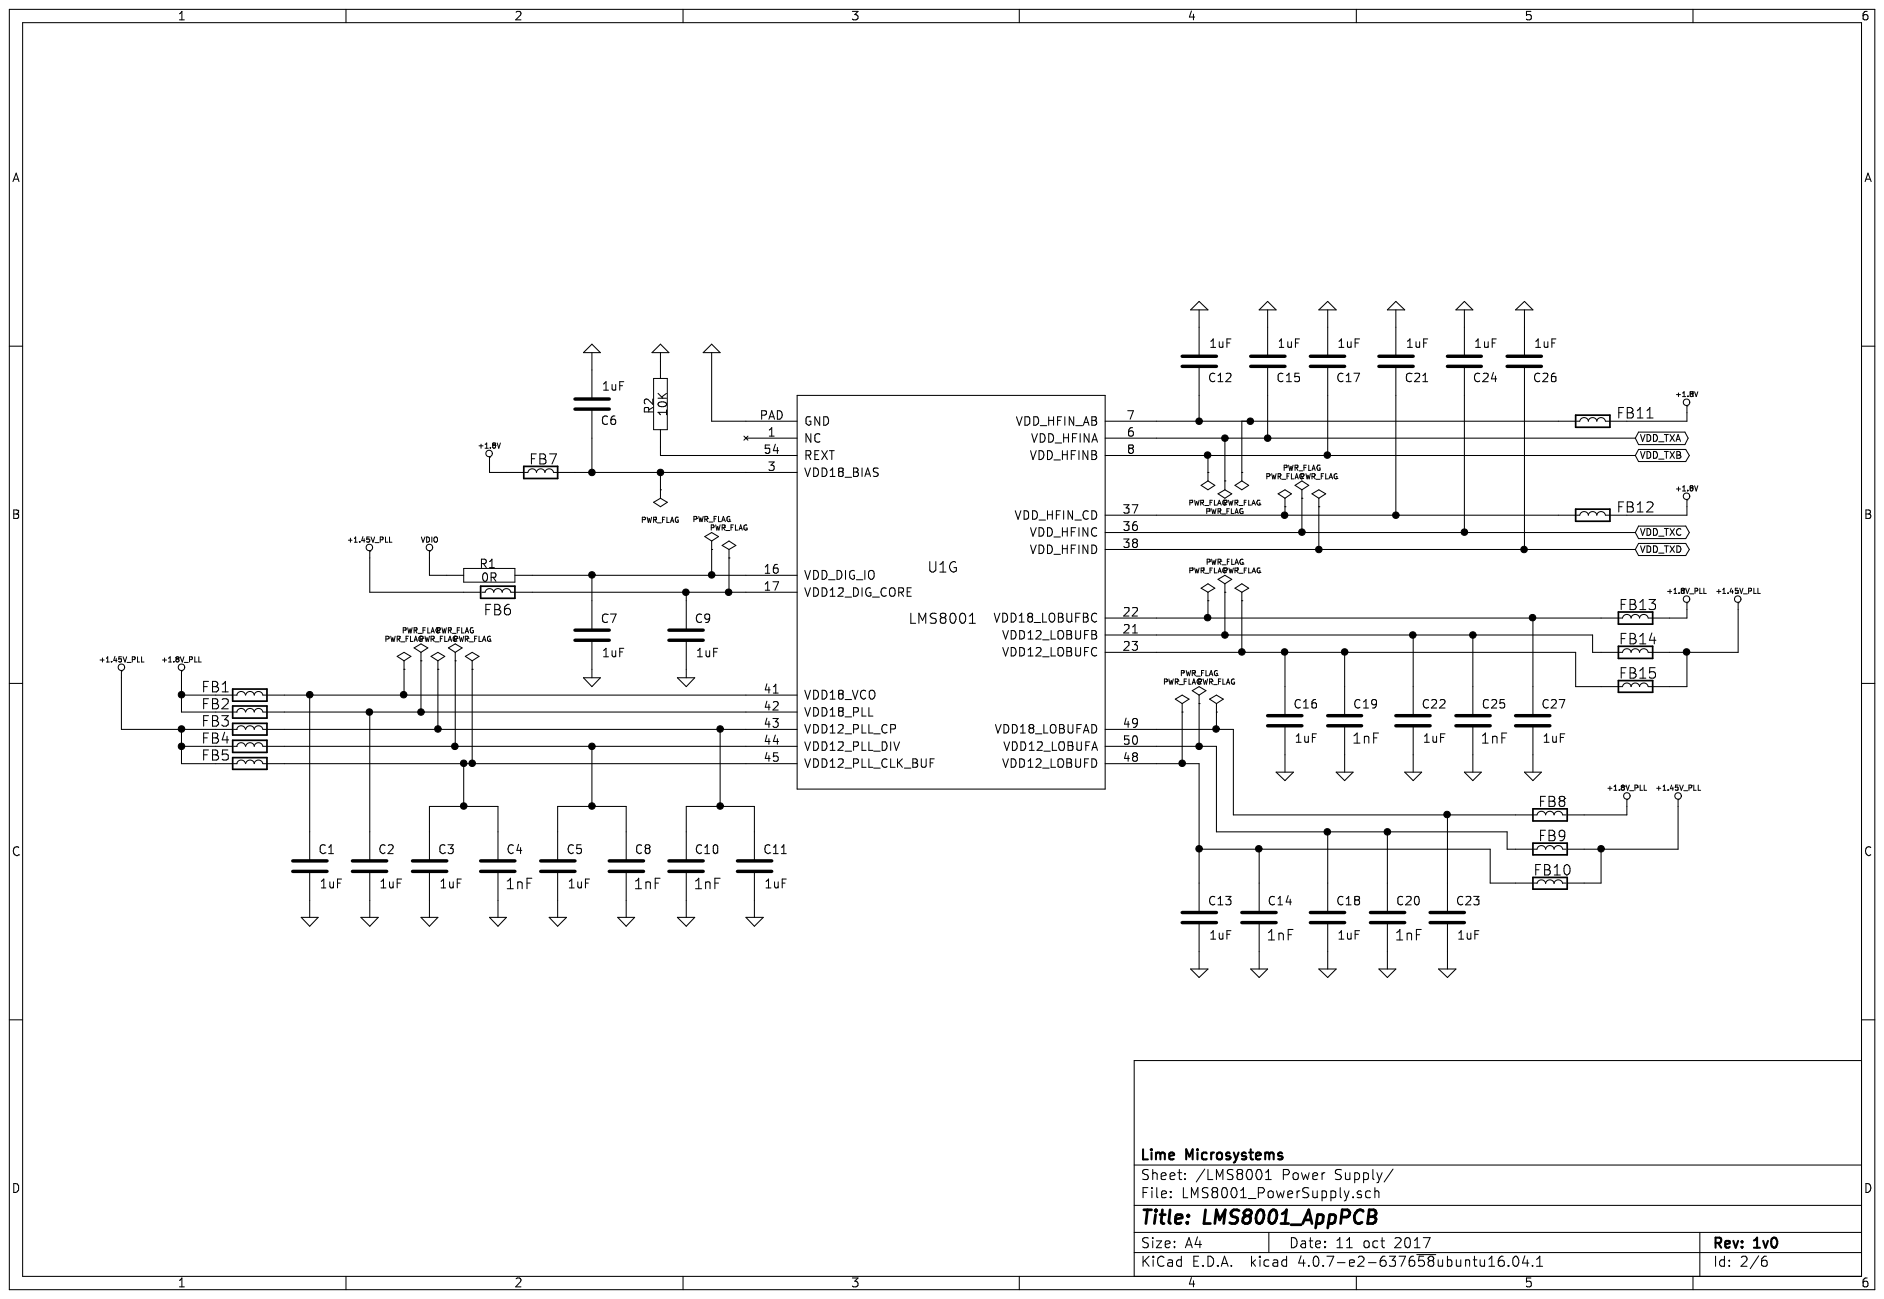
[picture p104: page 2]

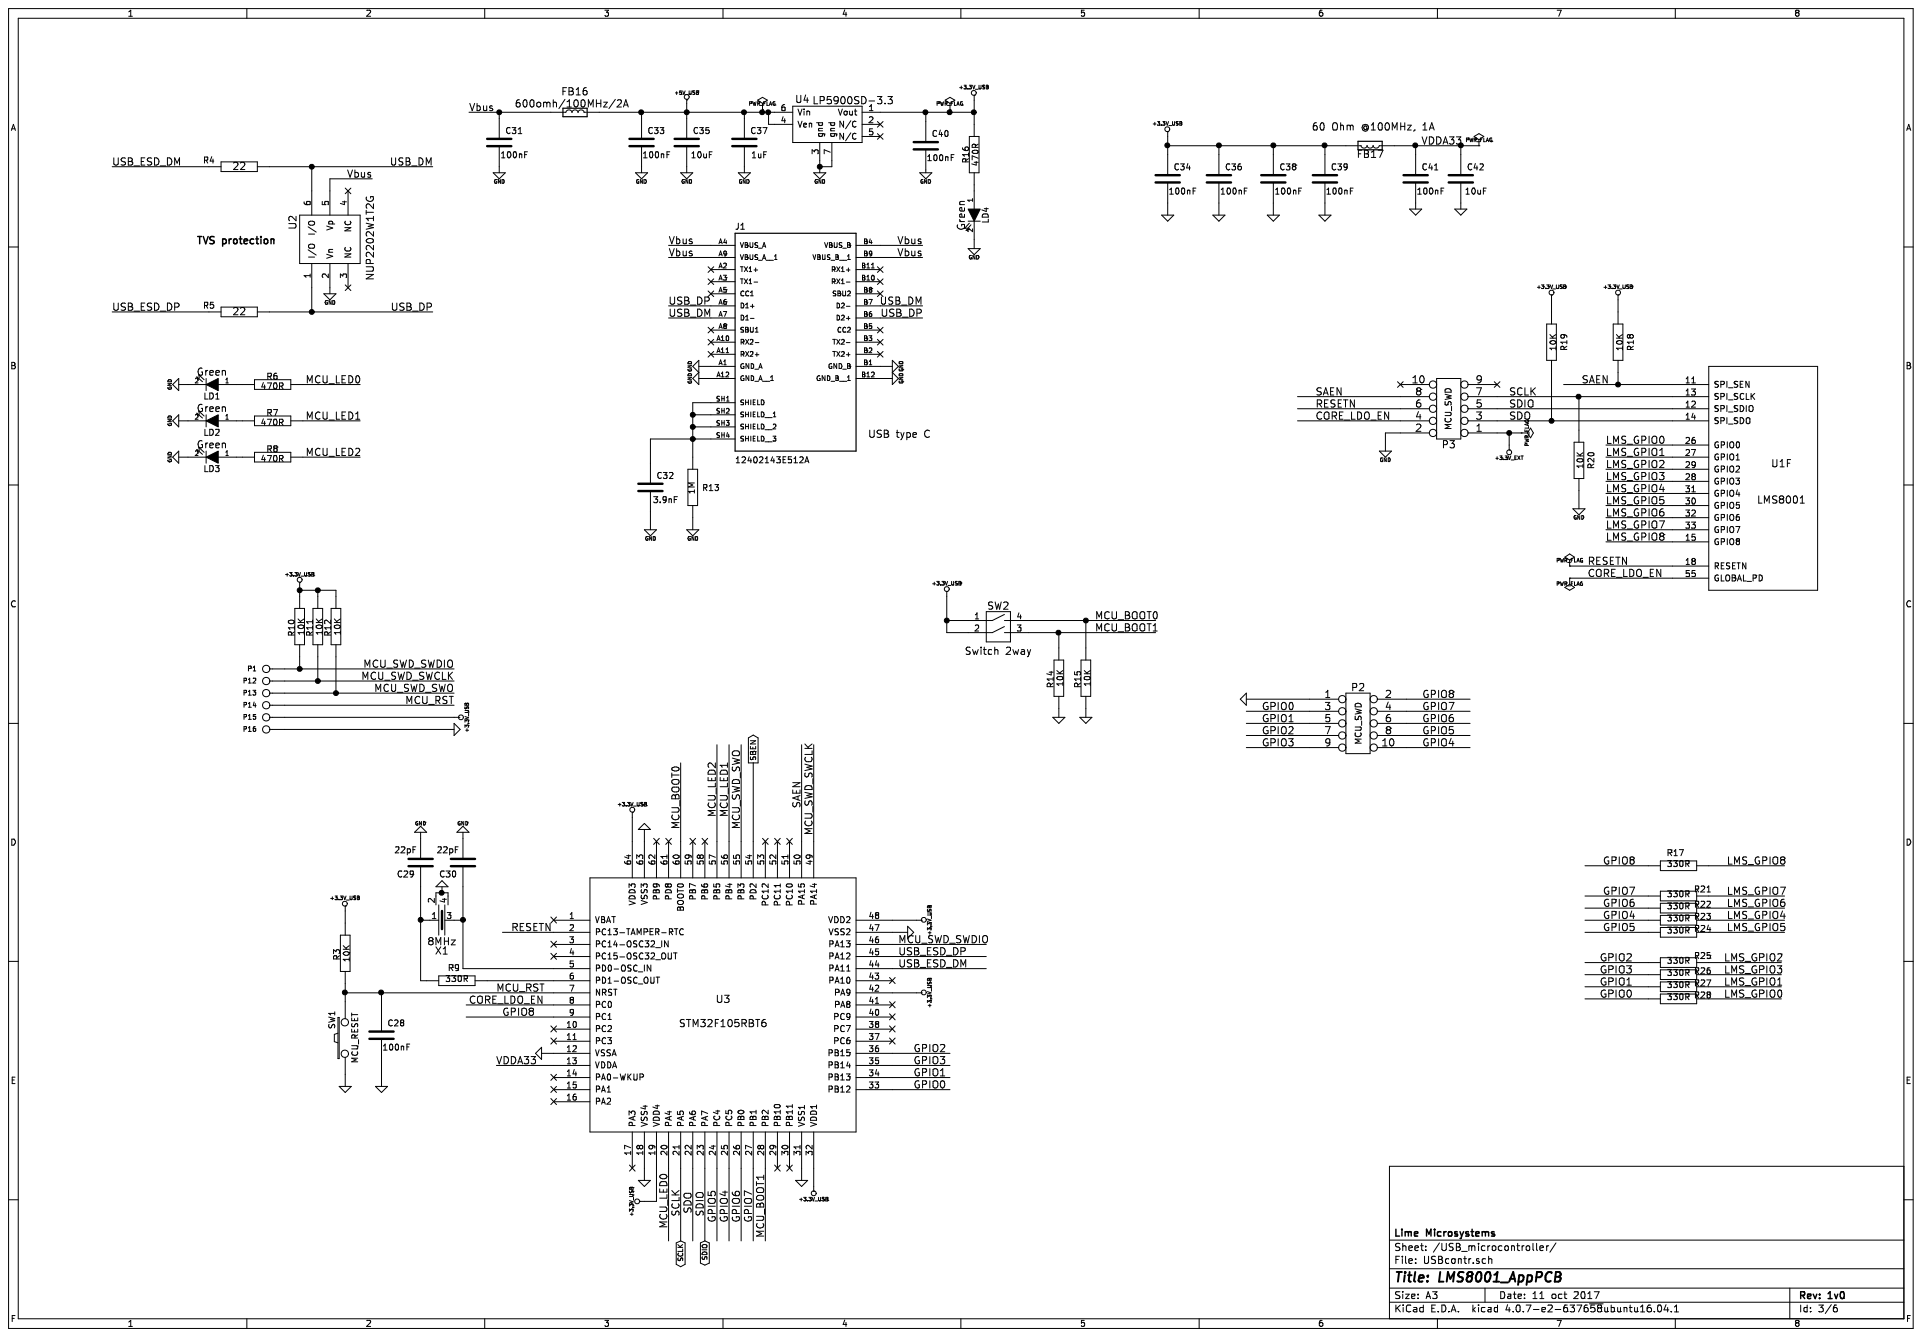
[picture p105: page 3]

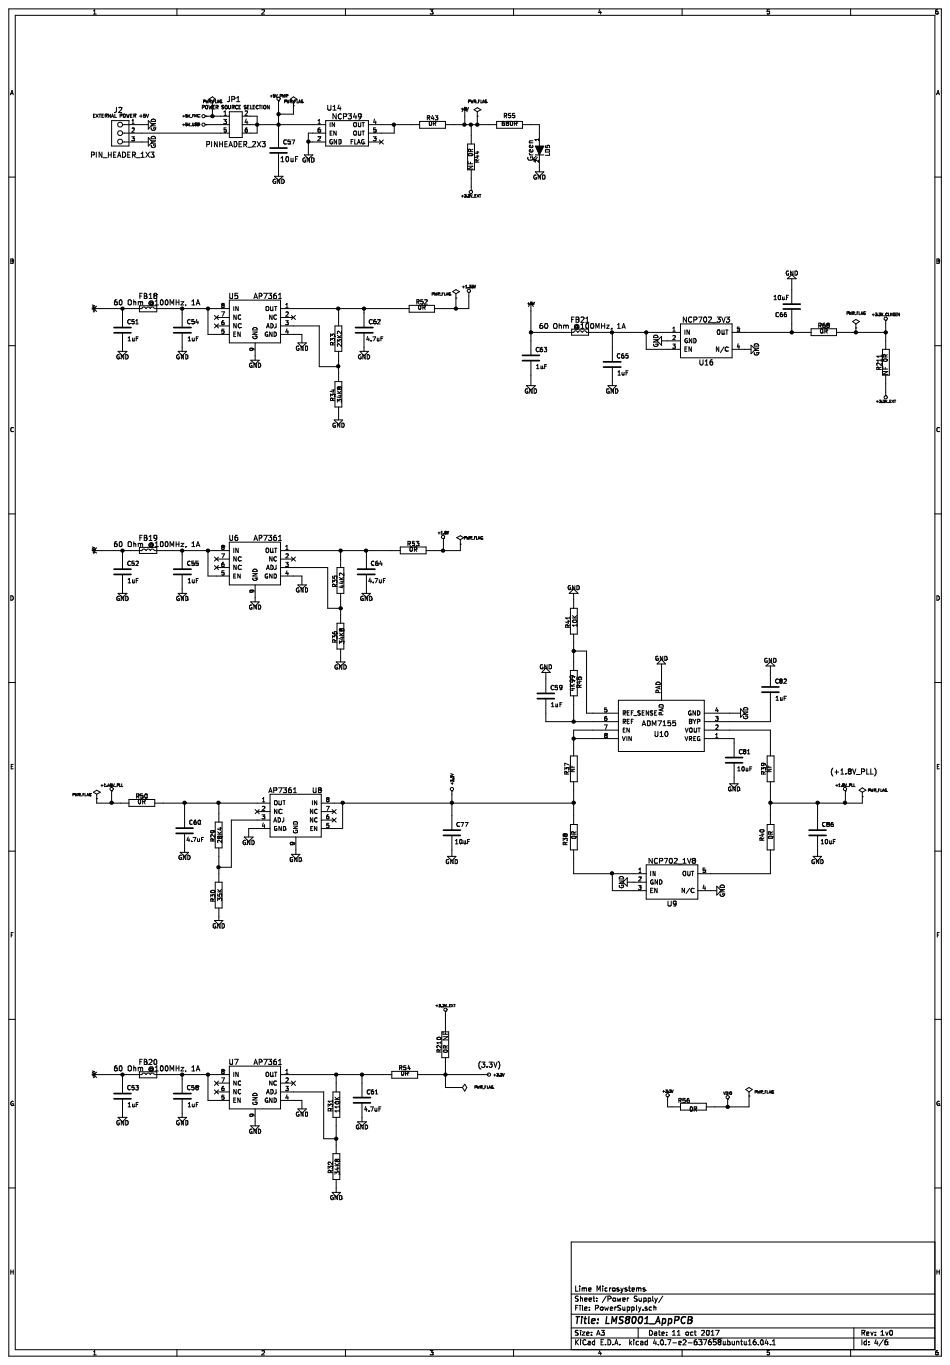
[picture p106: page 4]

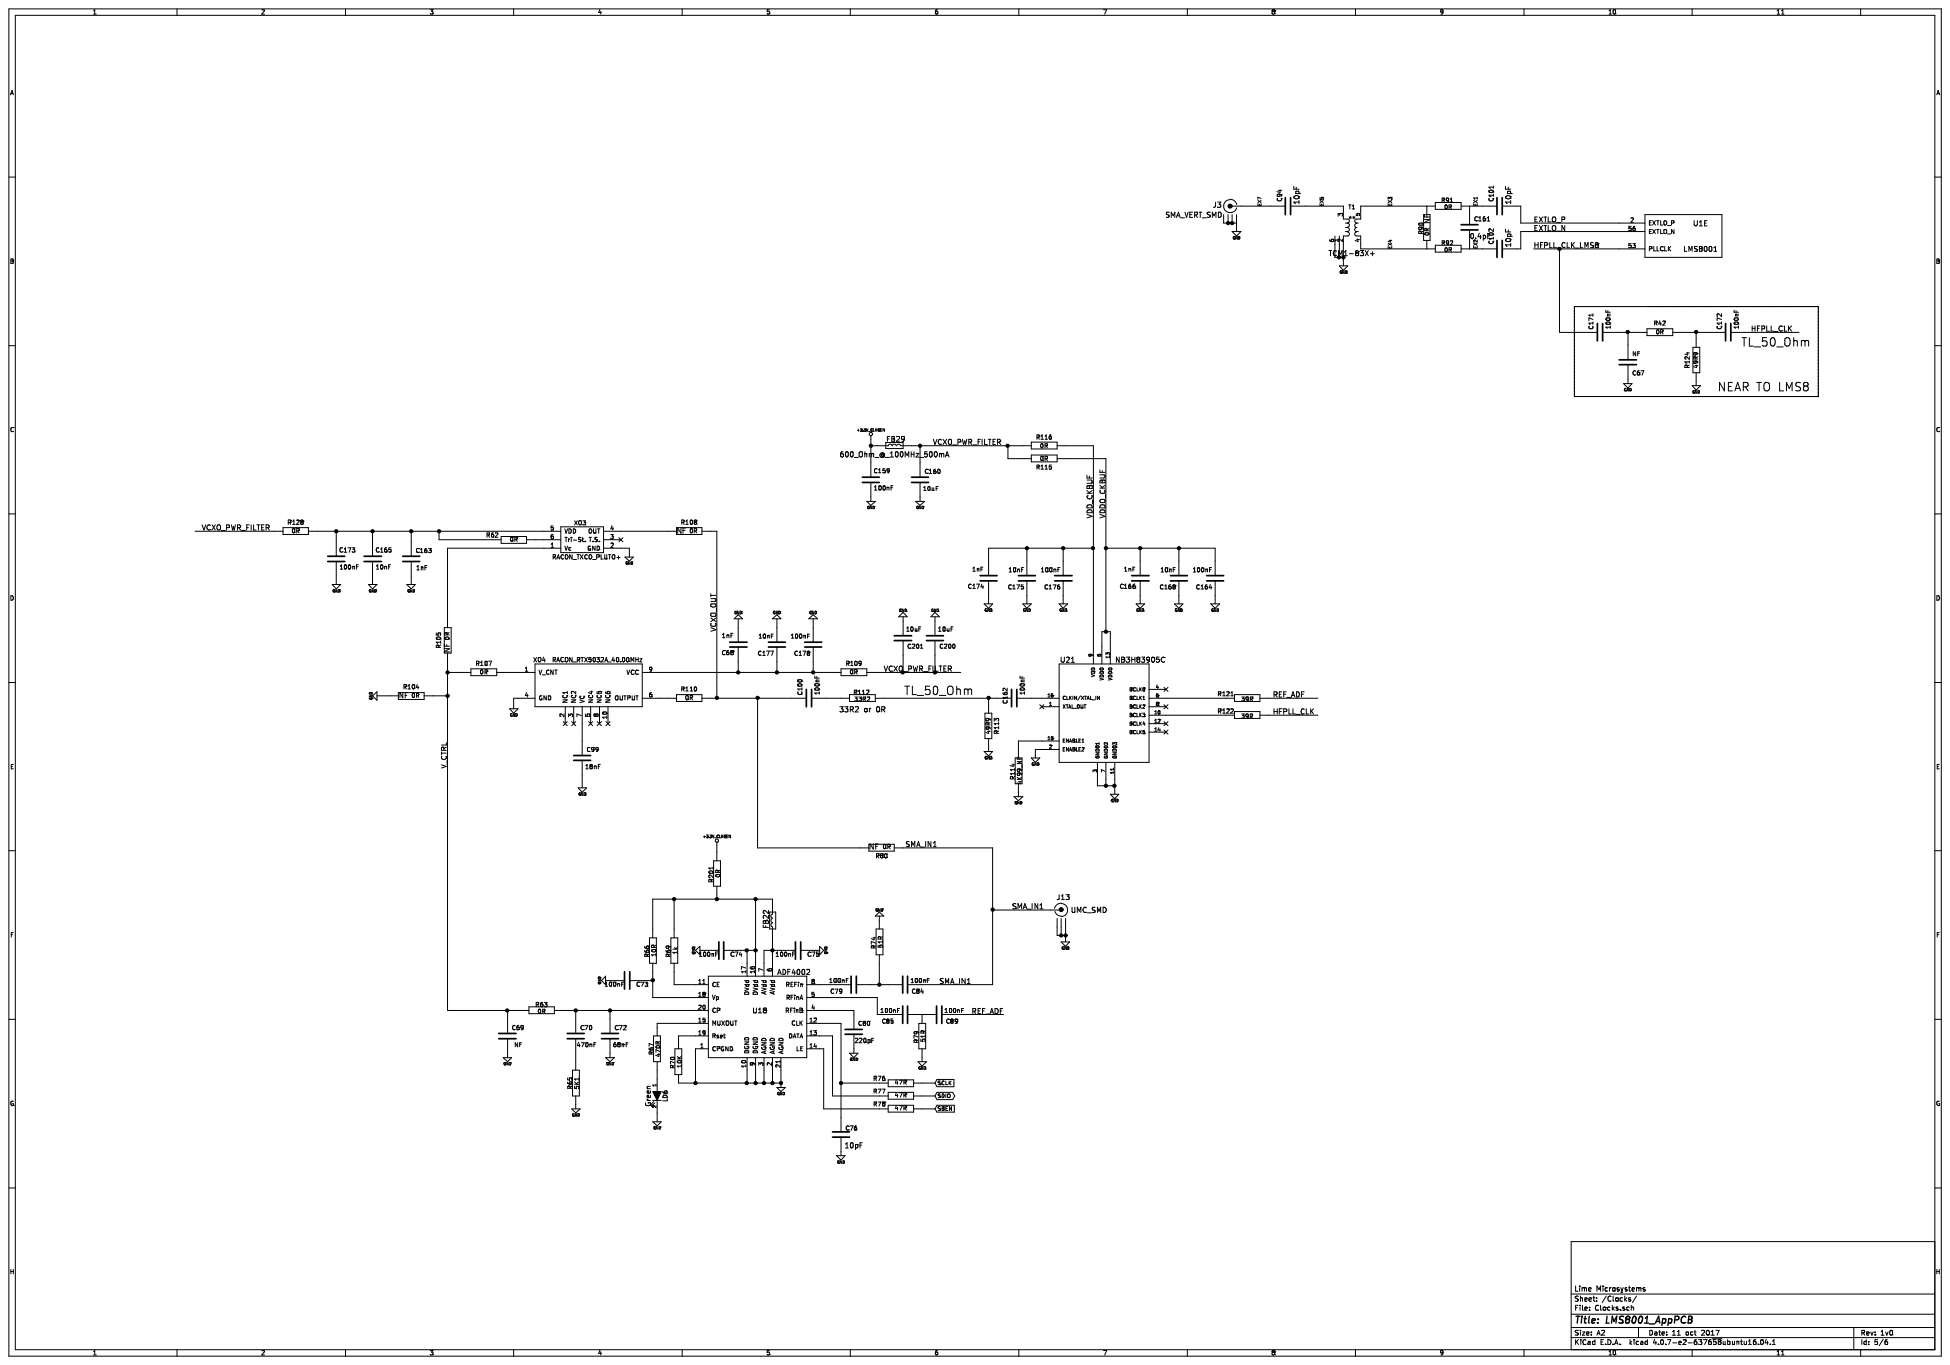
[picture p107: page 5]

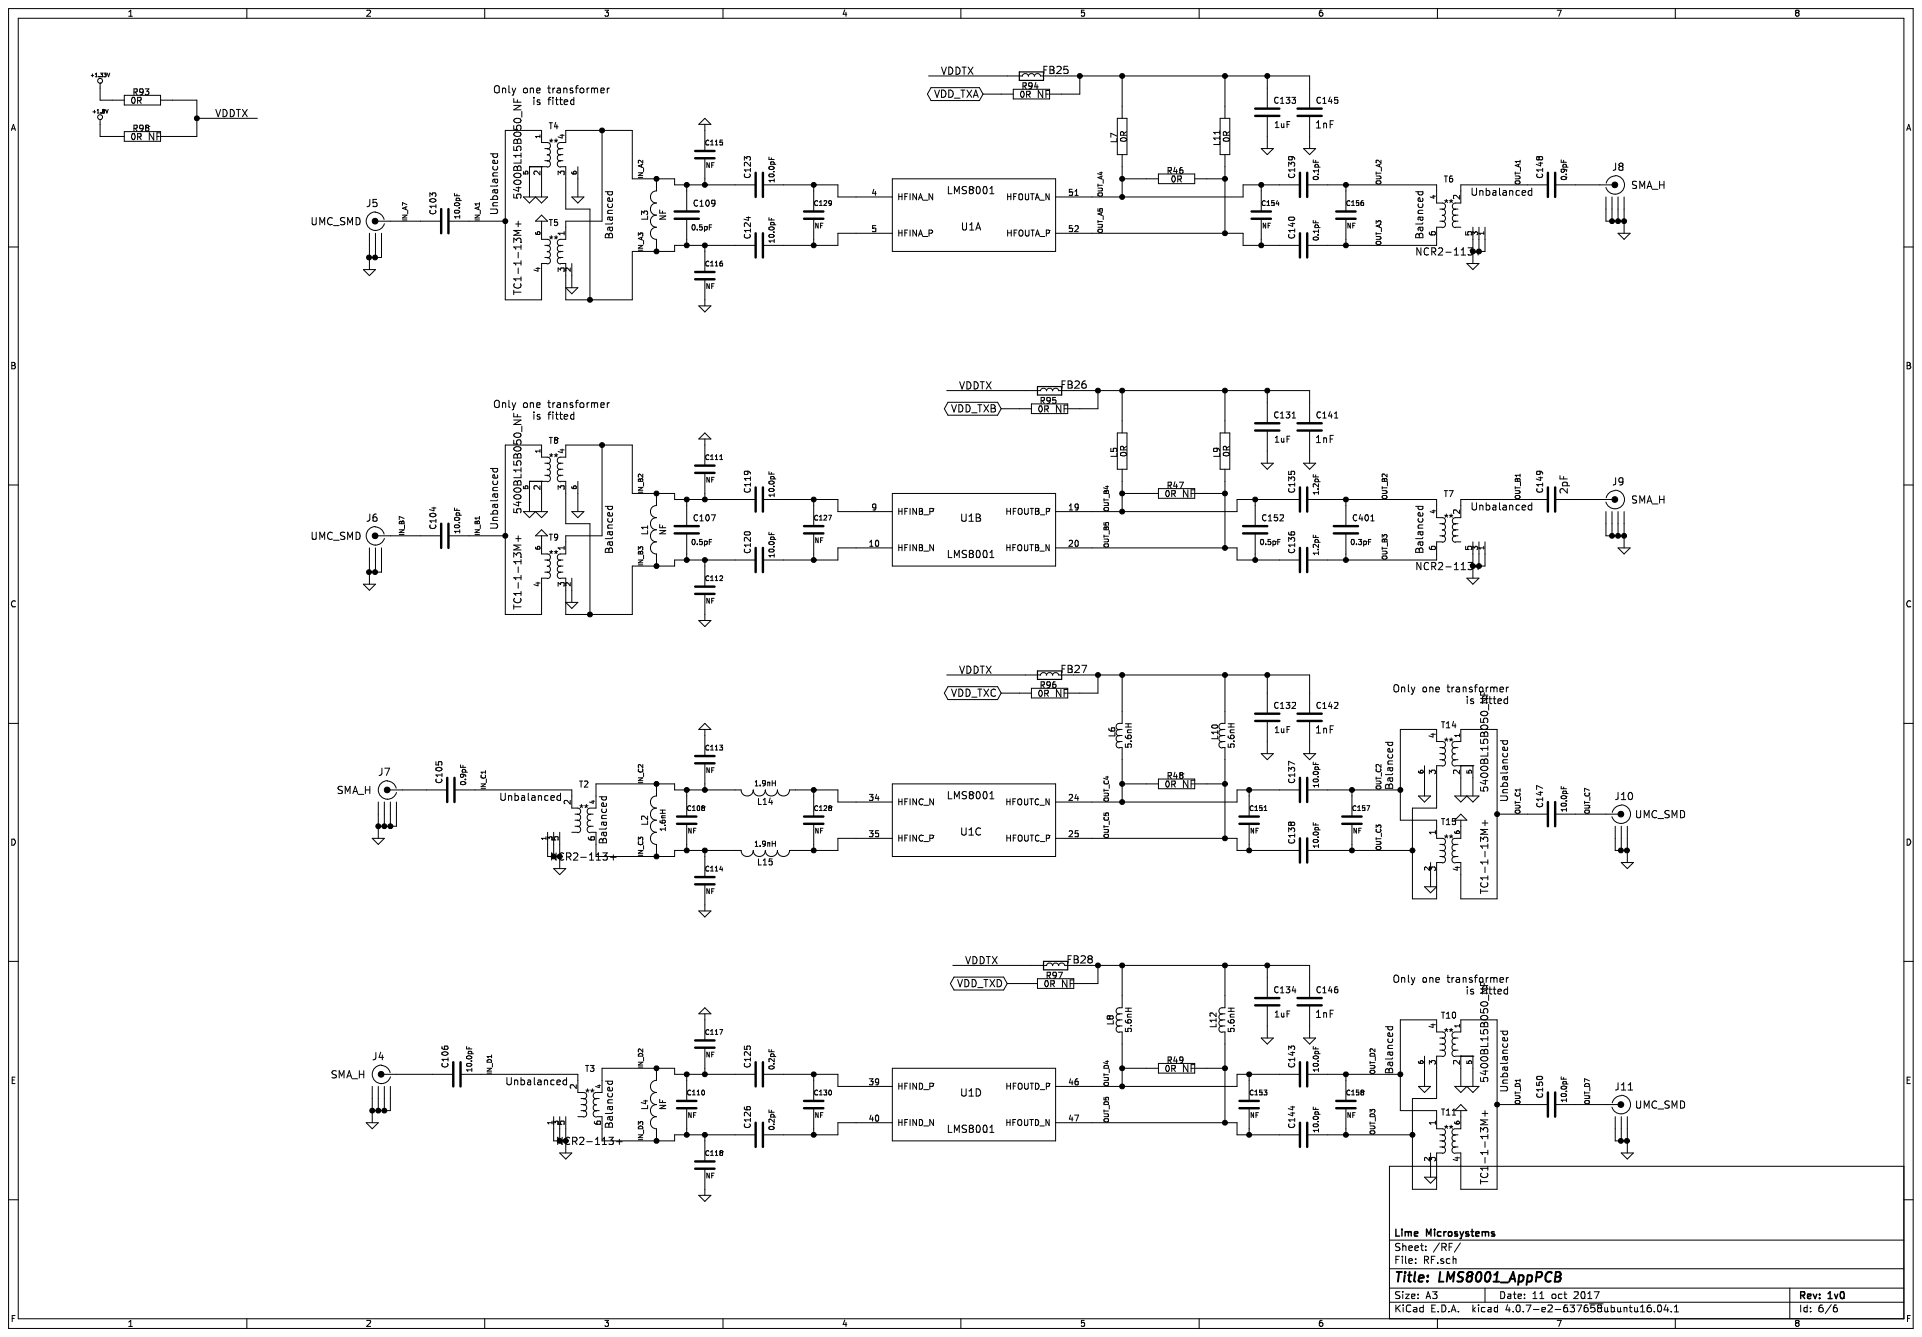
[picture p108: page 6]
