myriadrf/LMS8001-Companion/hardware/2v1/PDF/LMS8001_Companion_2v1_Layout.pdf

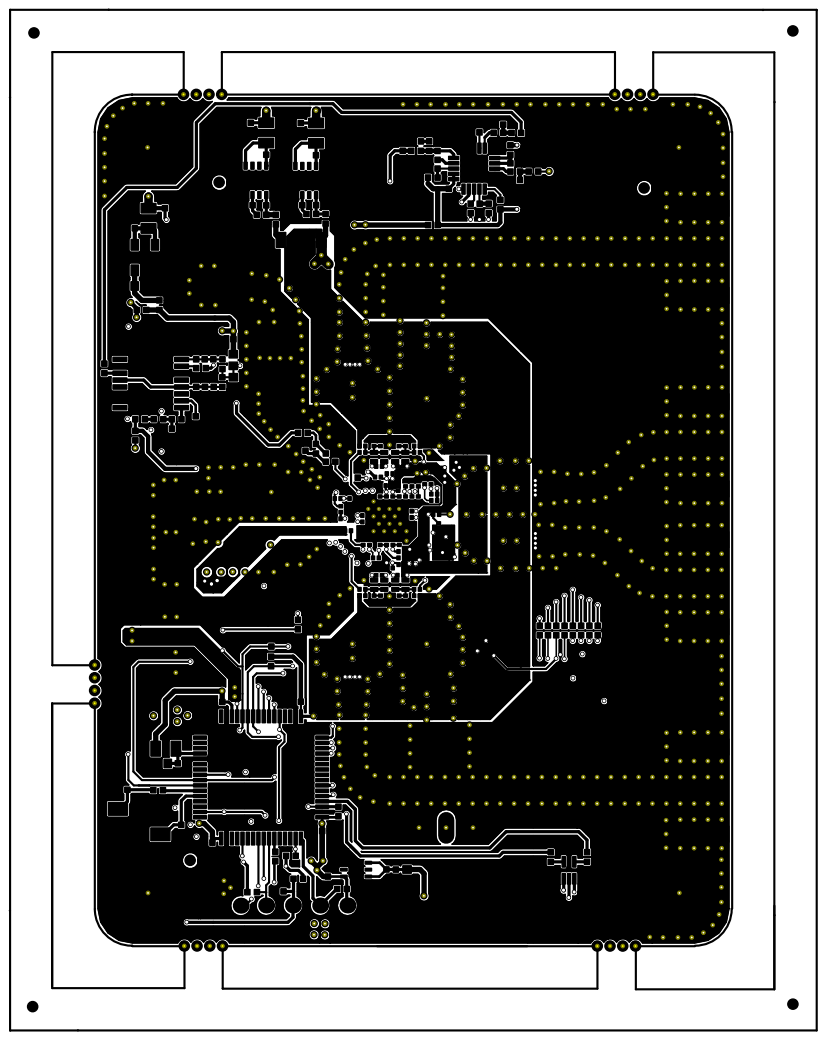
[picture p109: page 1]

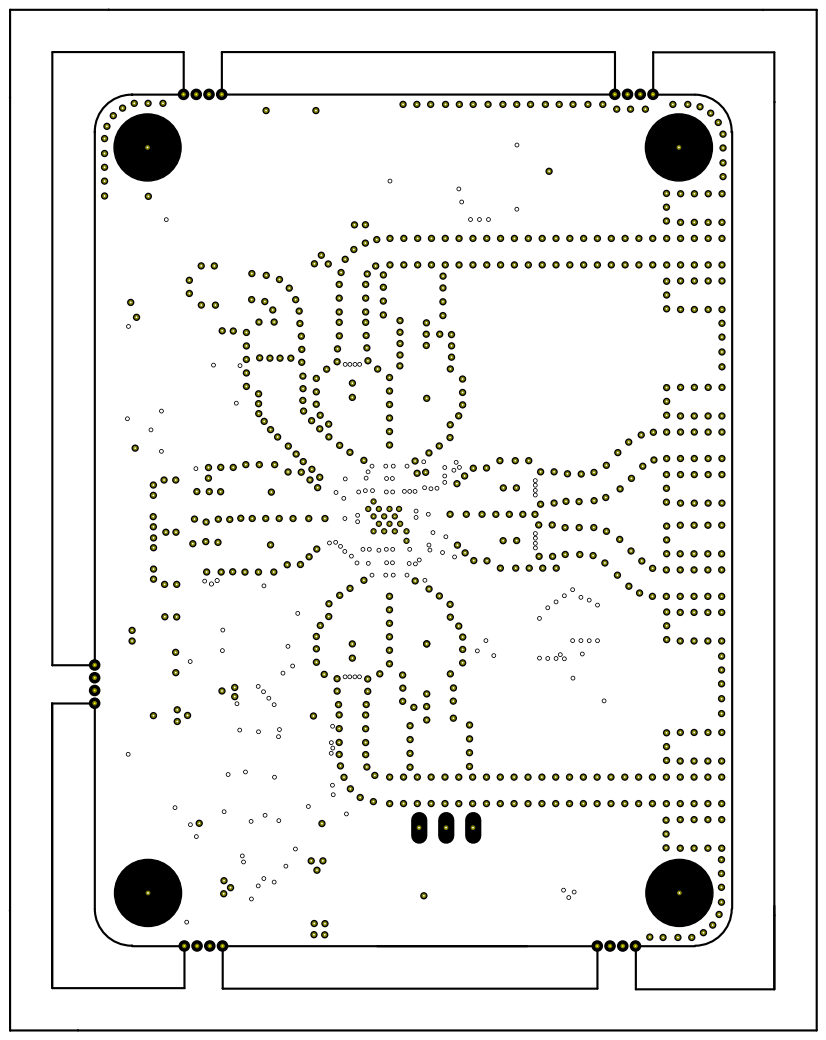
[picture p110: page 2]

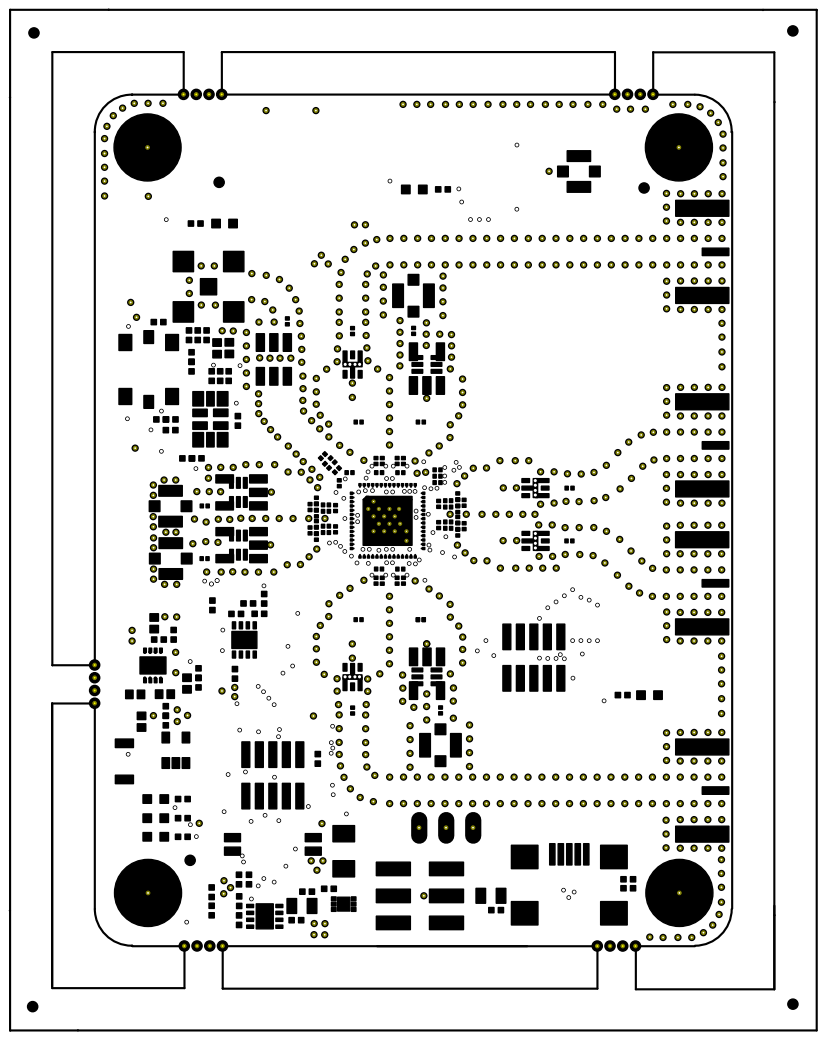
[picture p111: page 4]

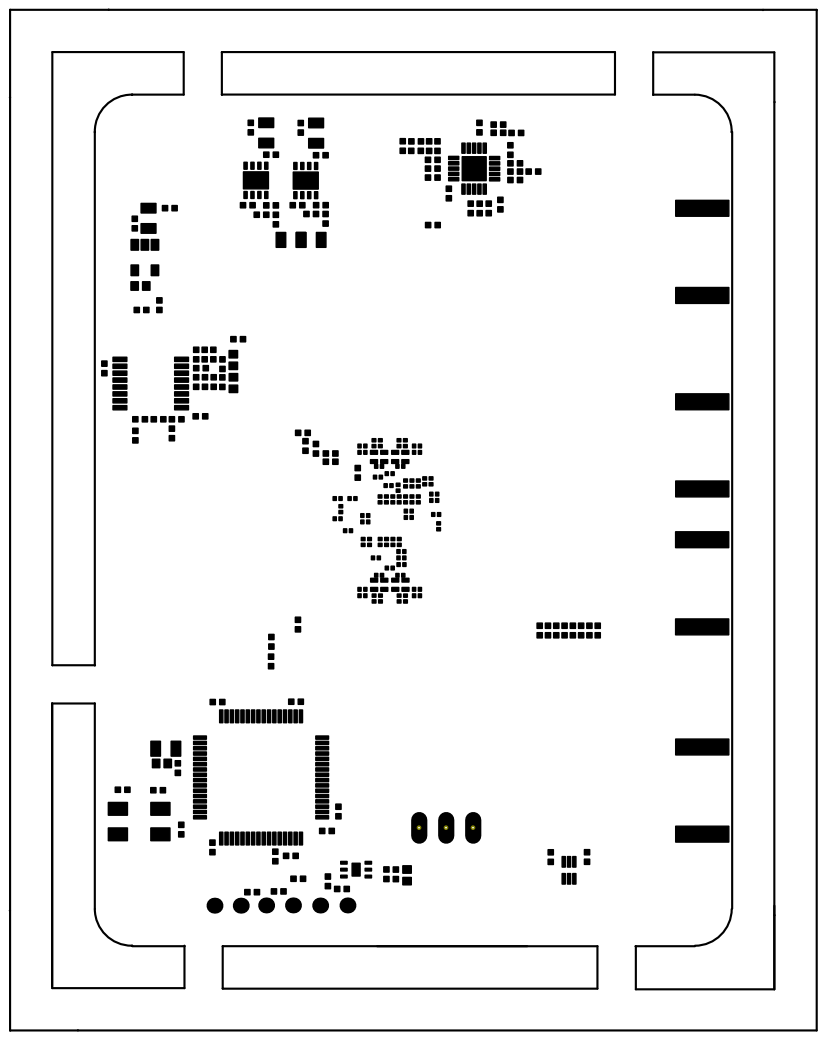
[picture p112: page 5]

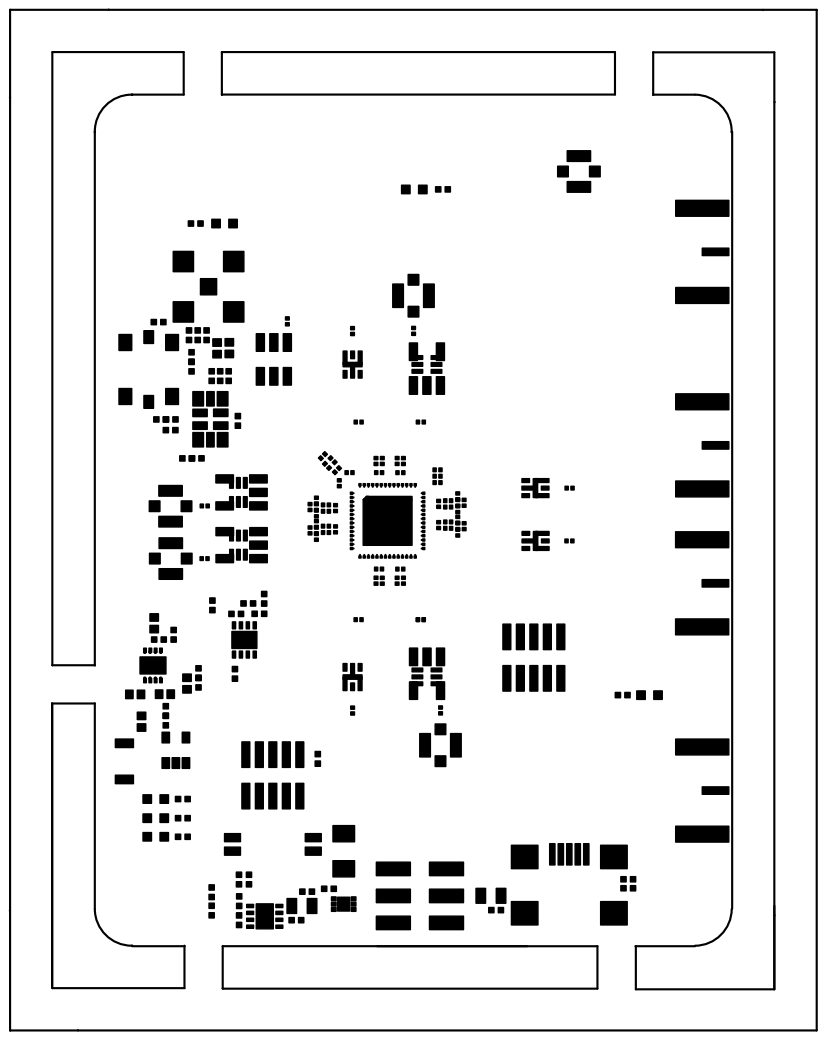
[picture p113: page 6]

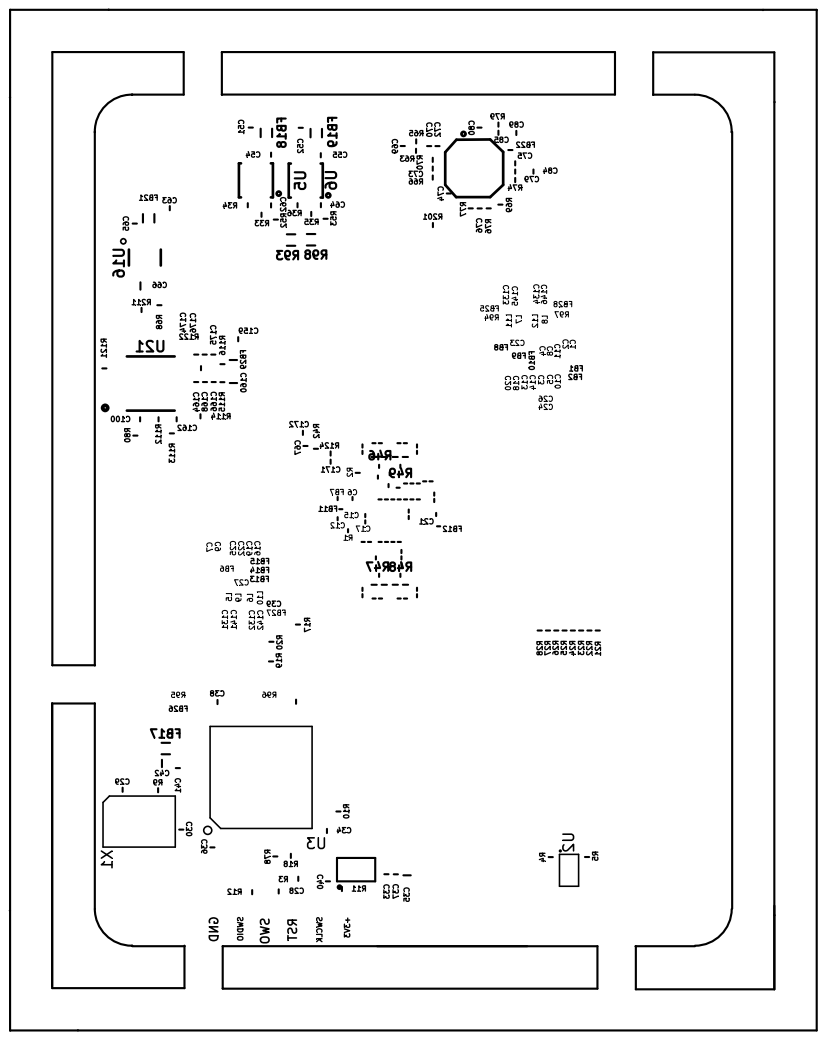
[picture p114: page 7]

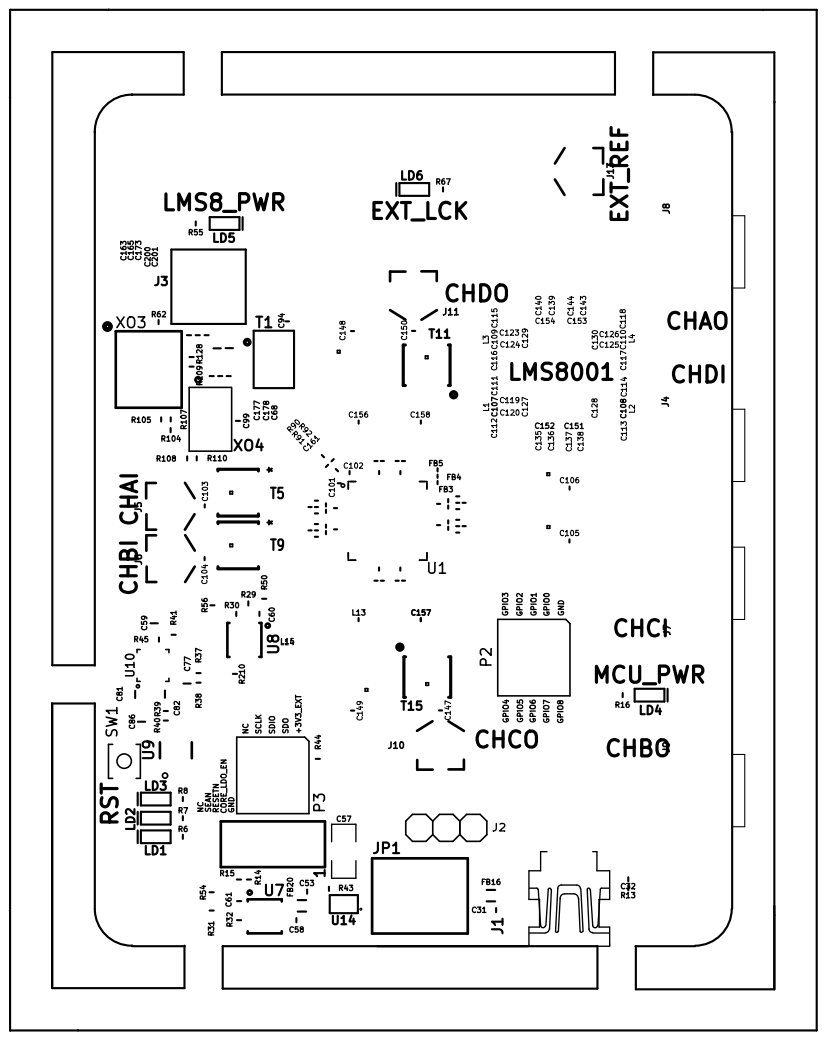
[picture p115: page 8]

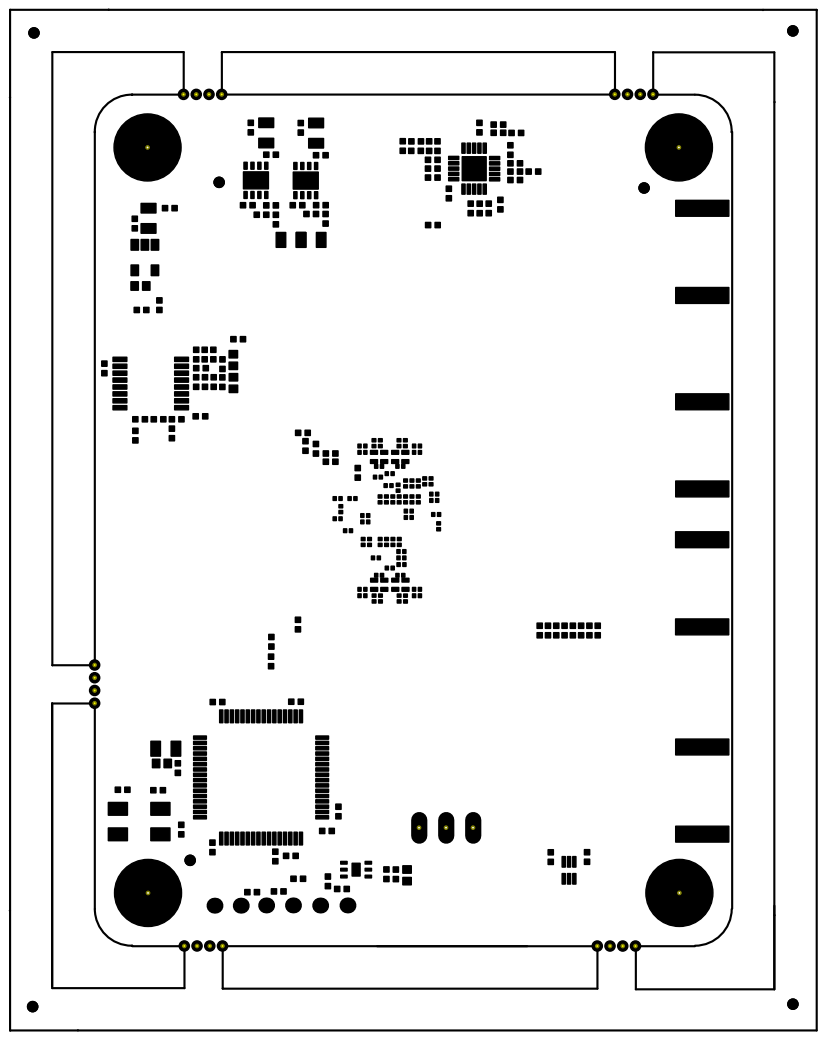
[picture p116: page 9]

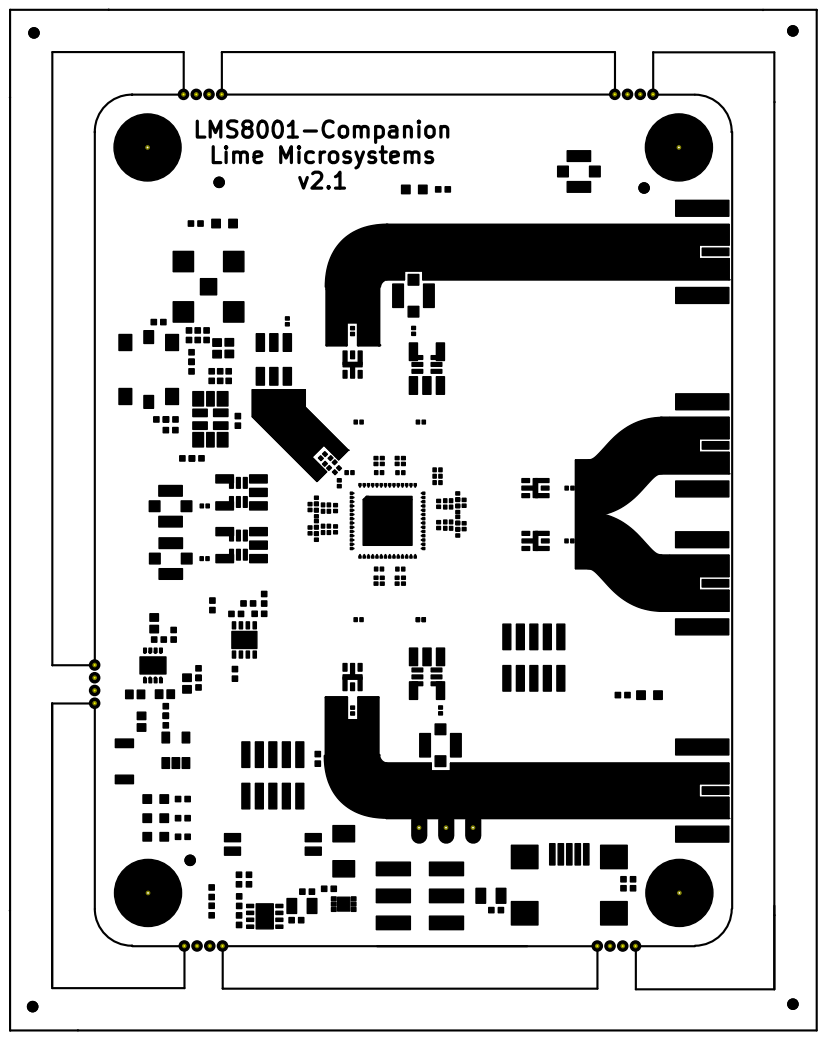
[picture p117: page 10]

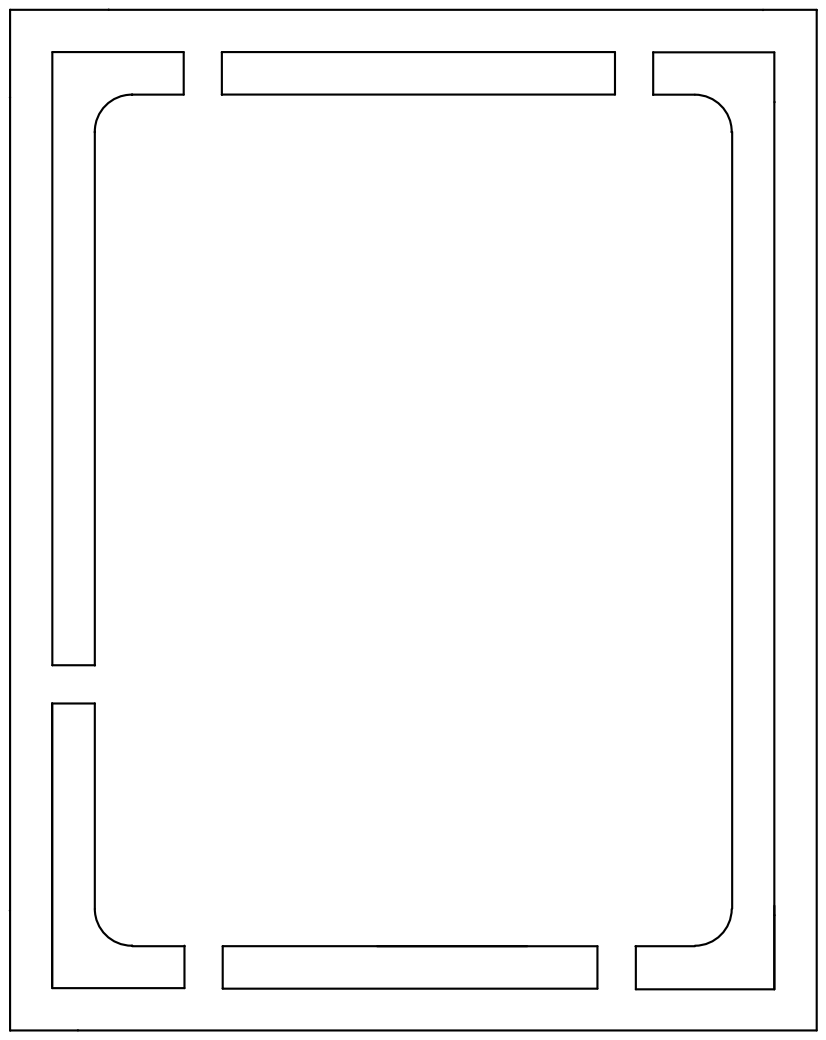
[picture p118: page 11]
