myriadrf/LMS8001-Companion/hardware/2v1/PDF/LMS8001_Companion_2v1_Schematic.pdf

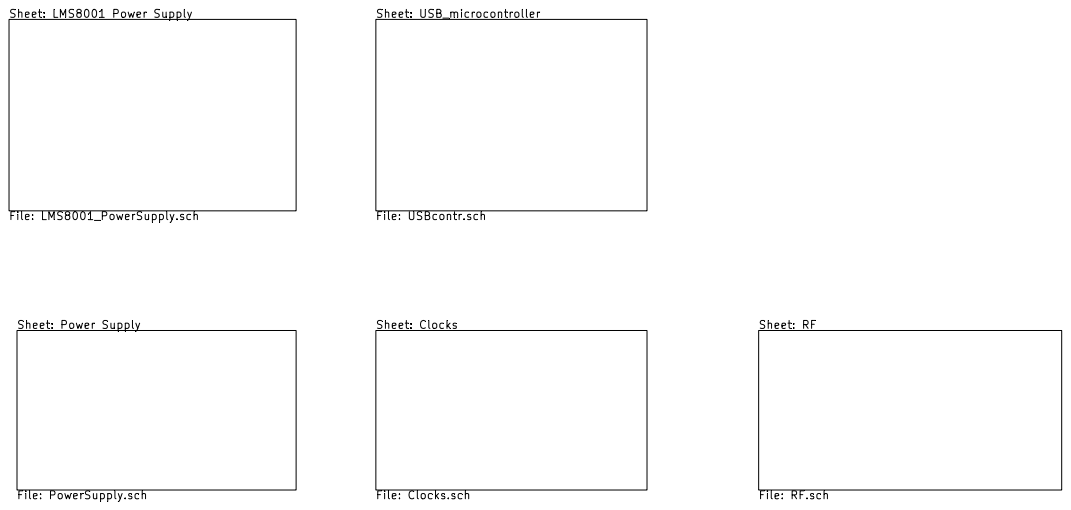
[picture p119: page 1]

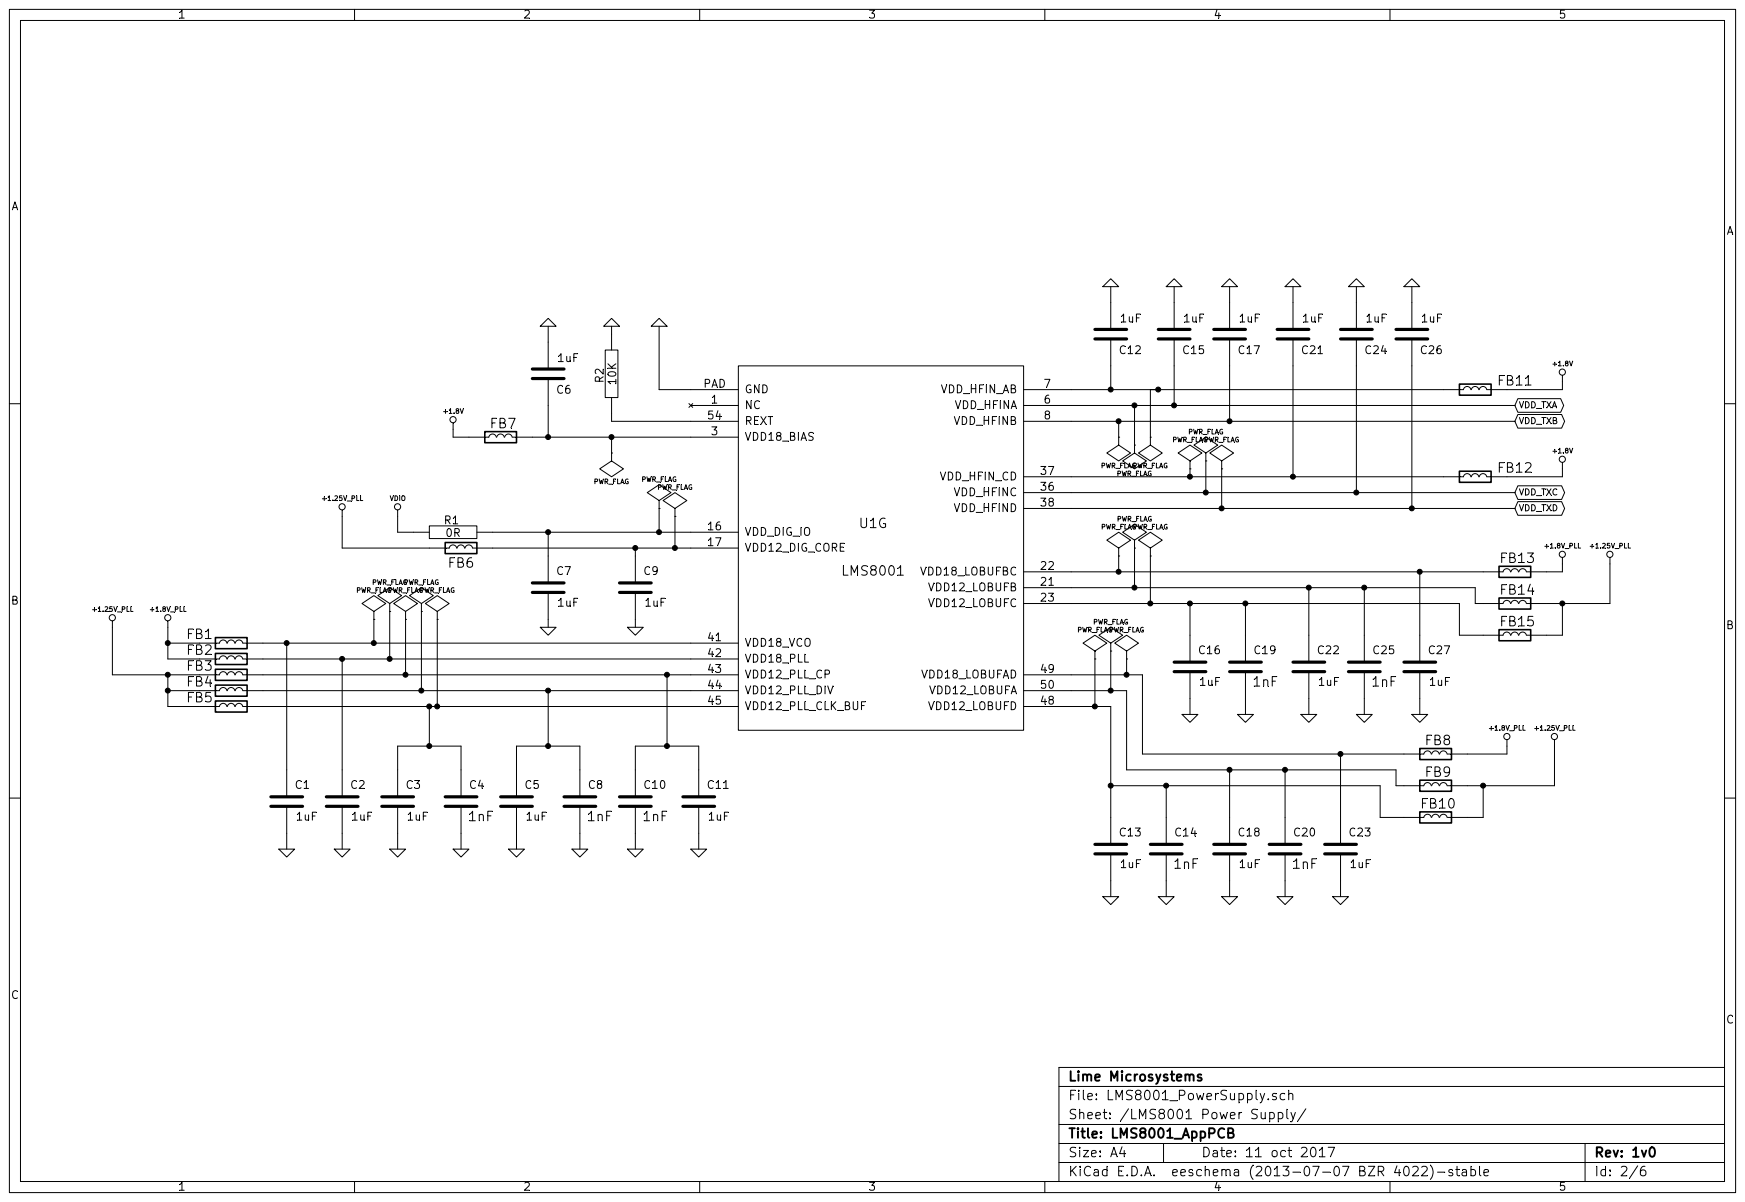
[picture p120: page 2]

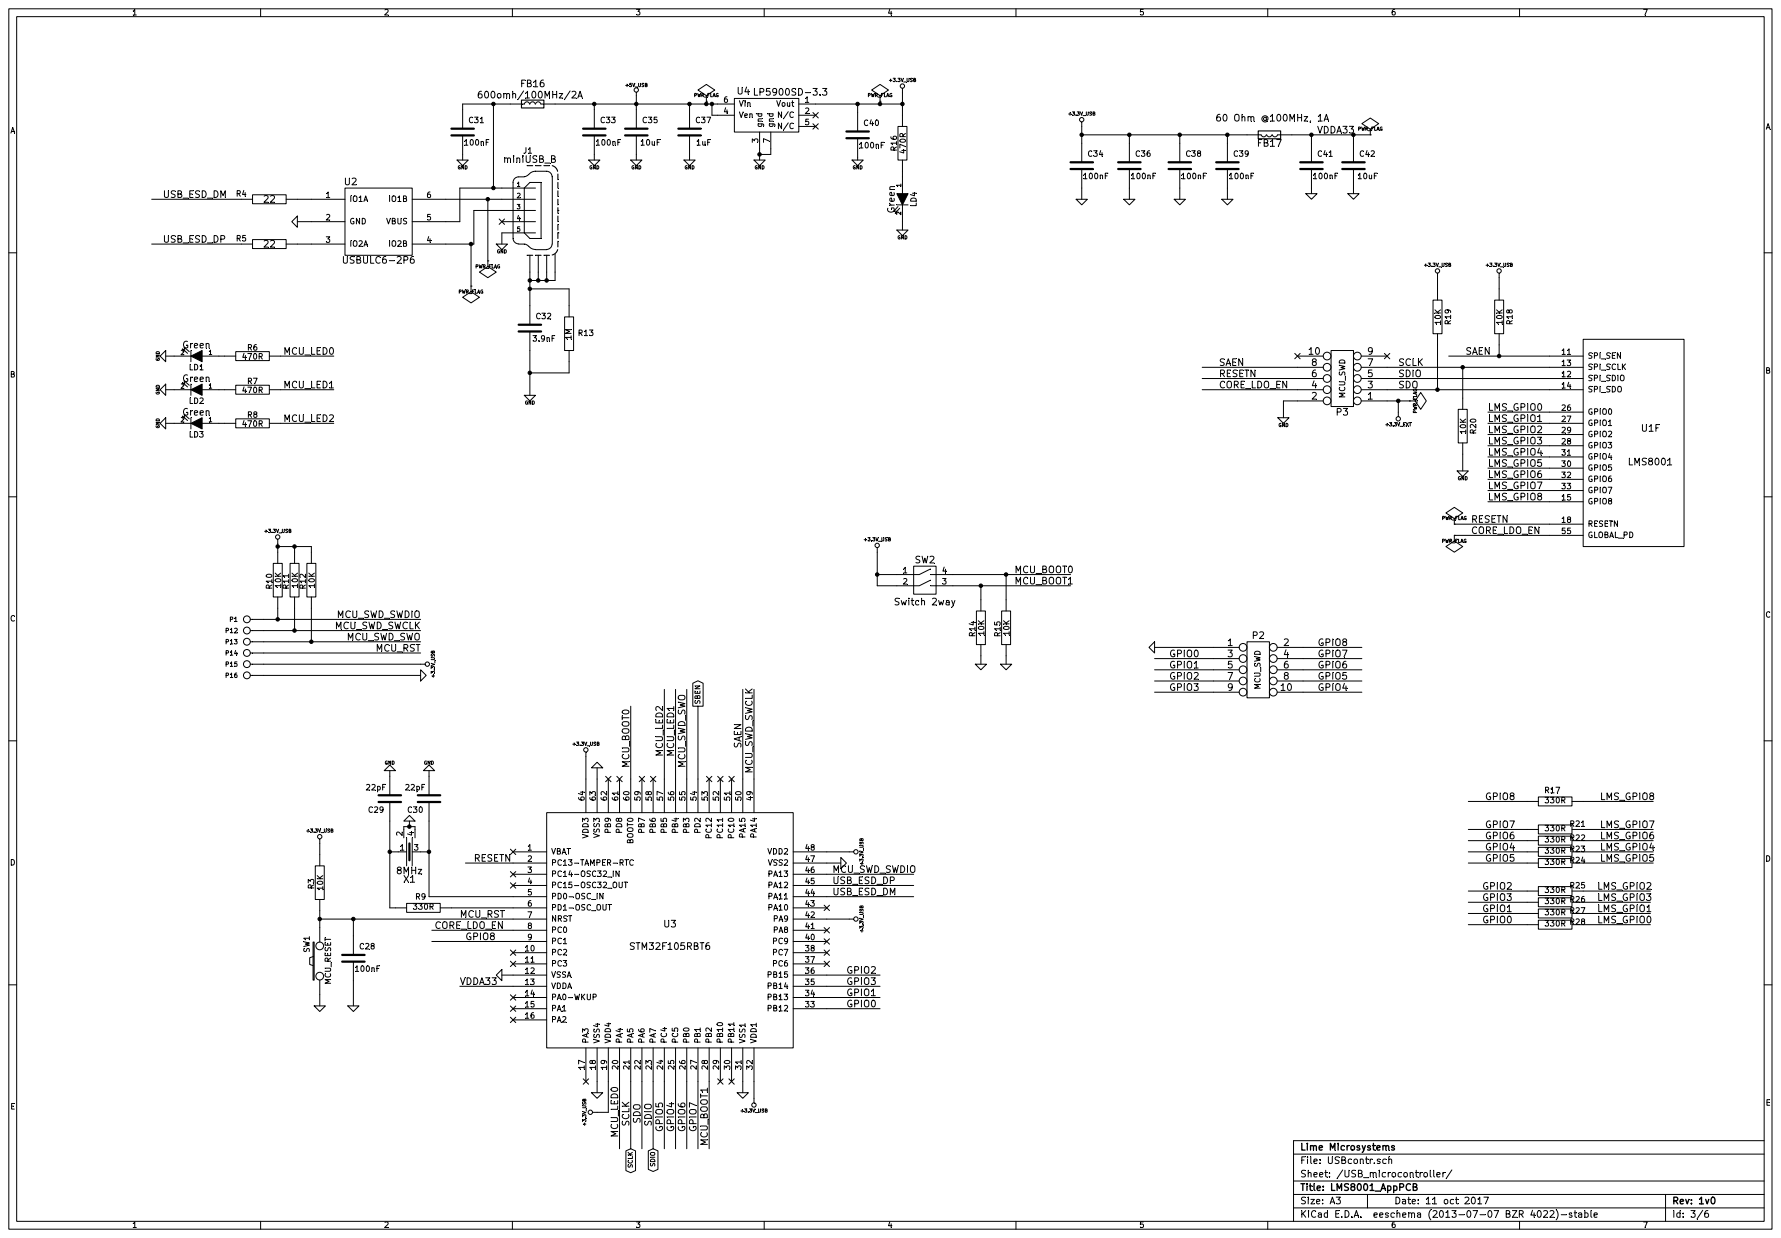
[picture p121: page 3]

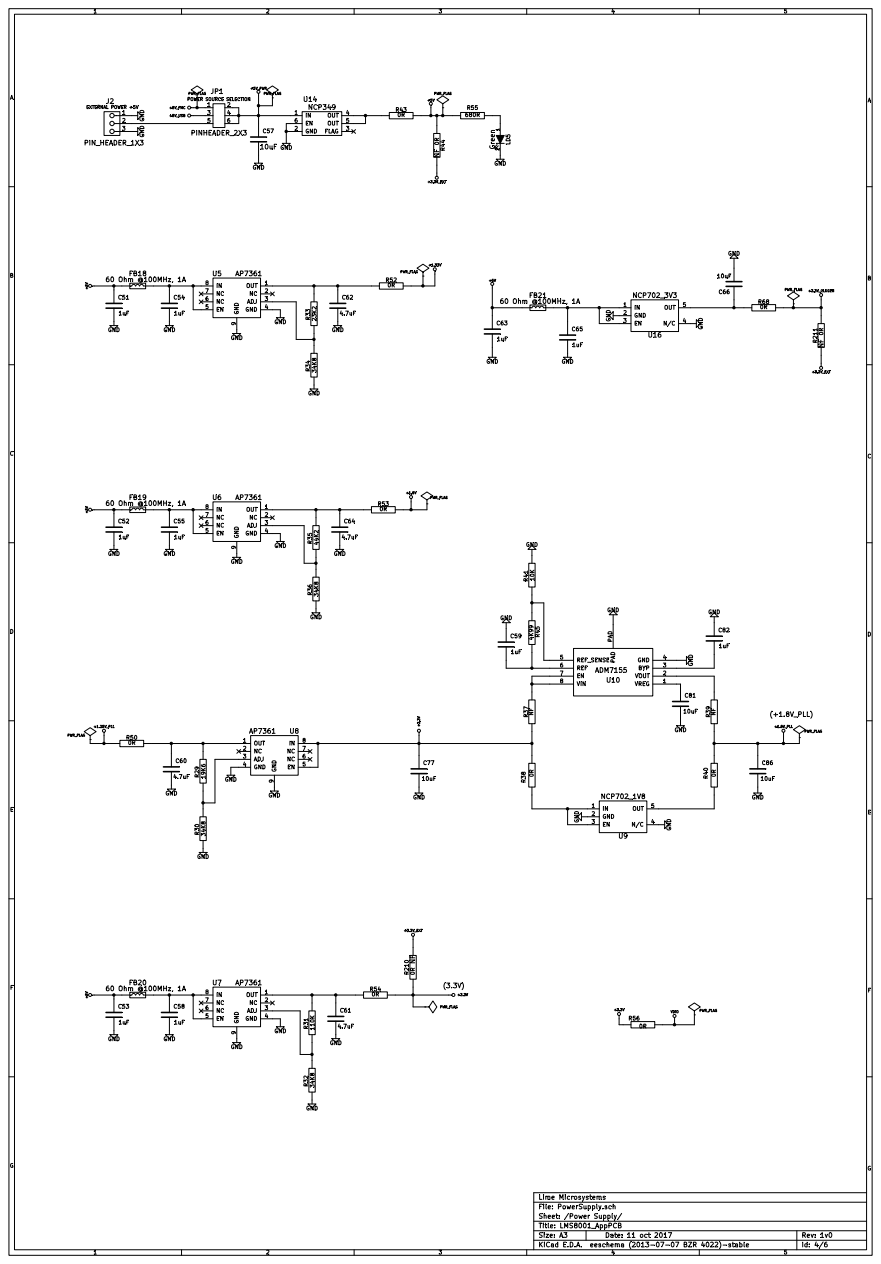
[picture p122: page 4]

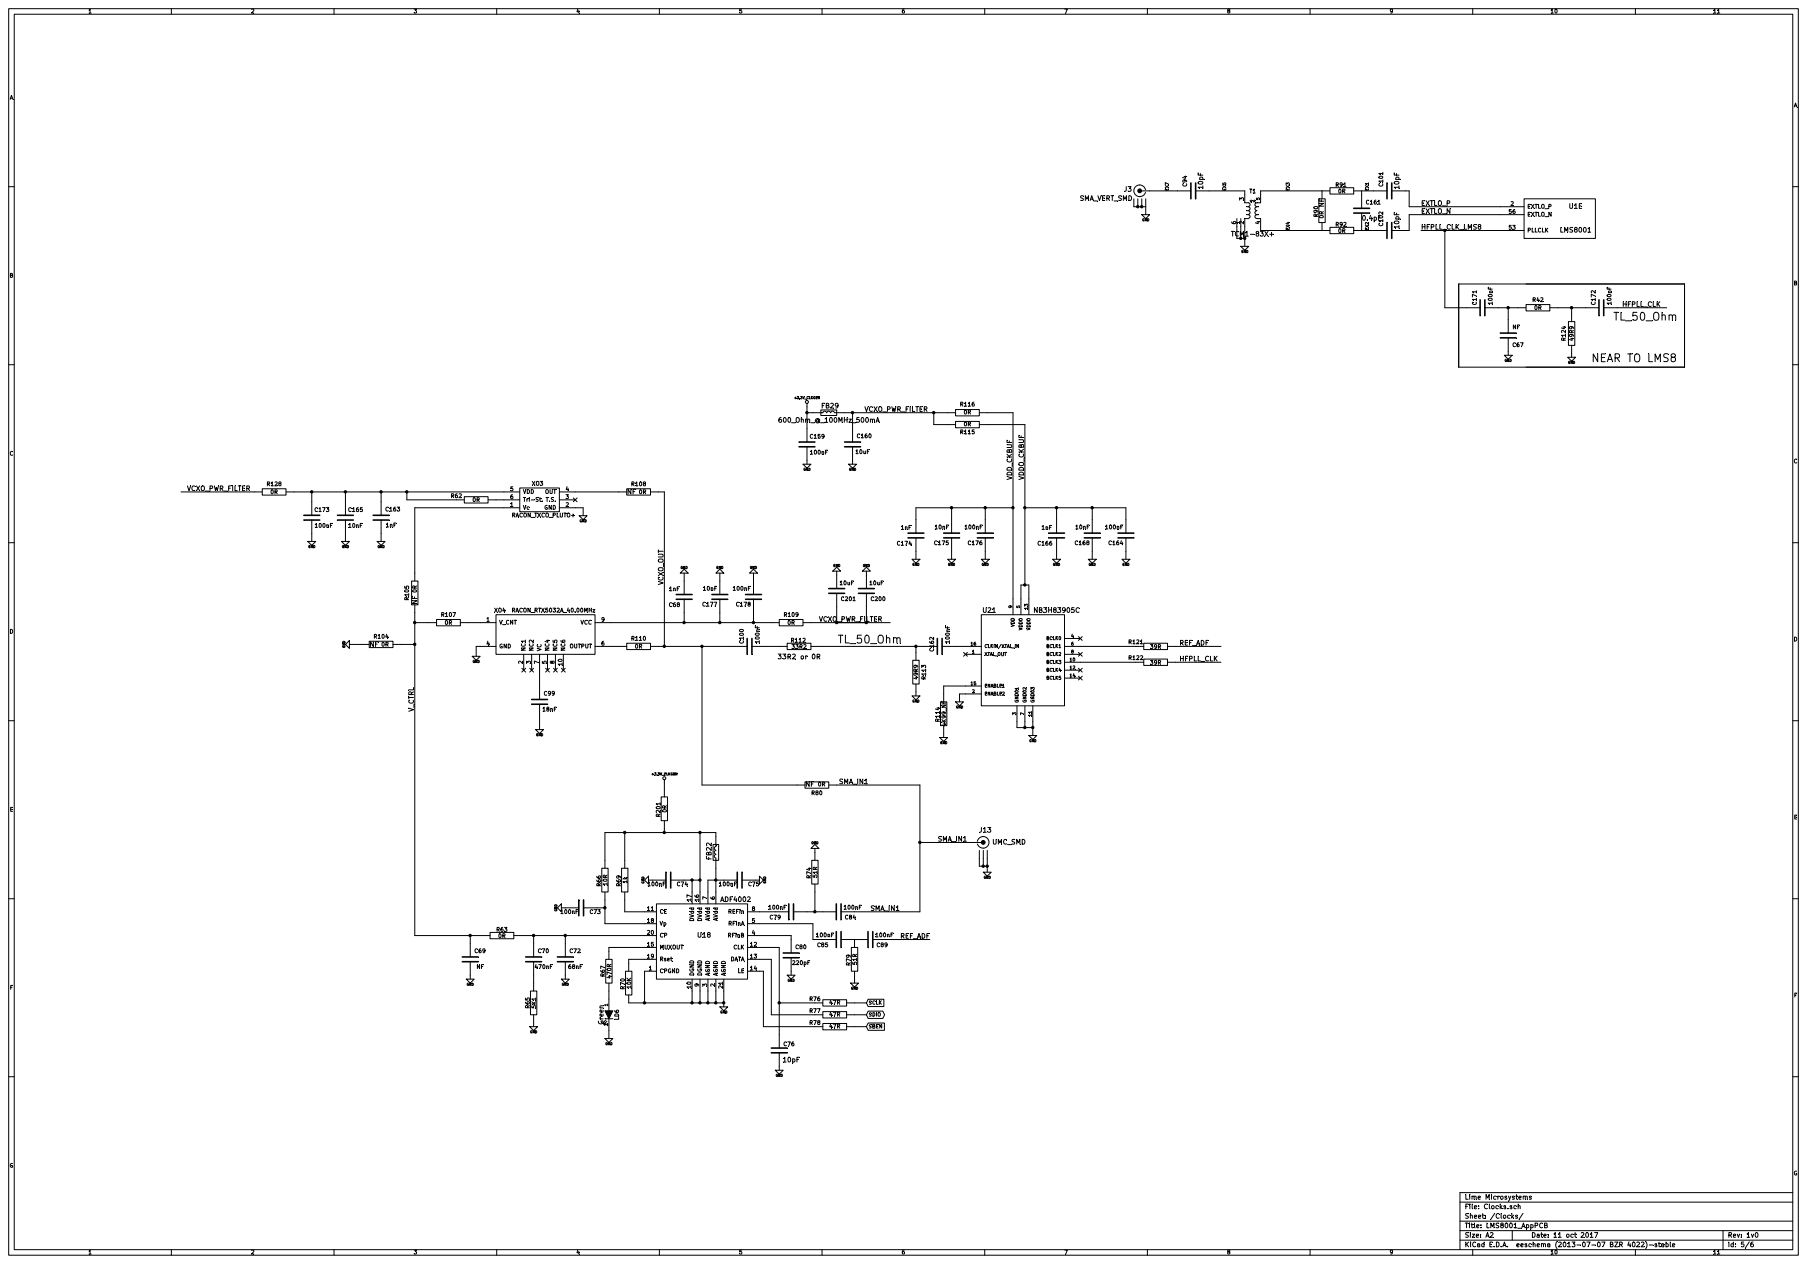
[picture p123: page 5]

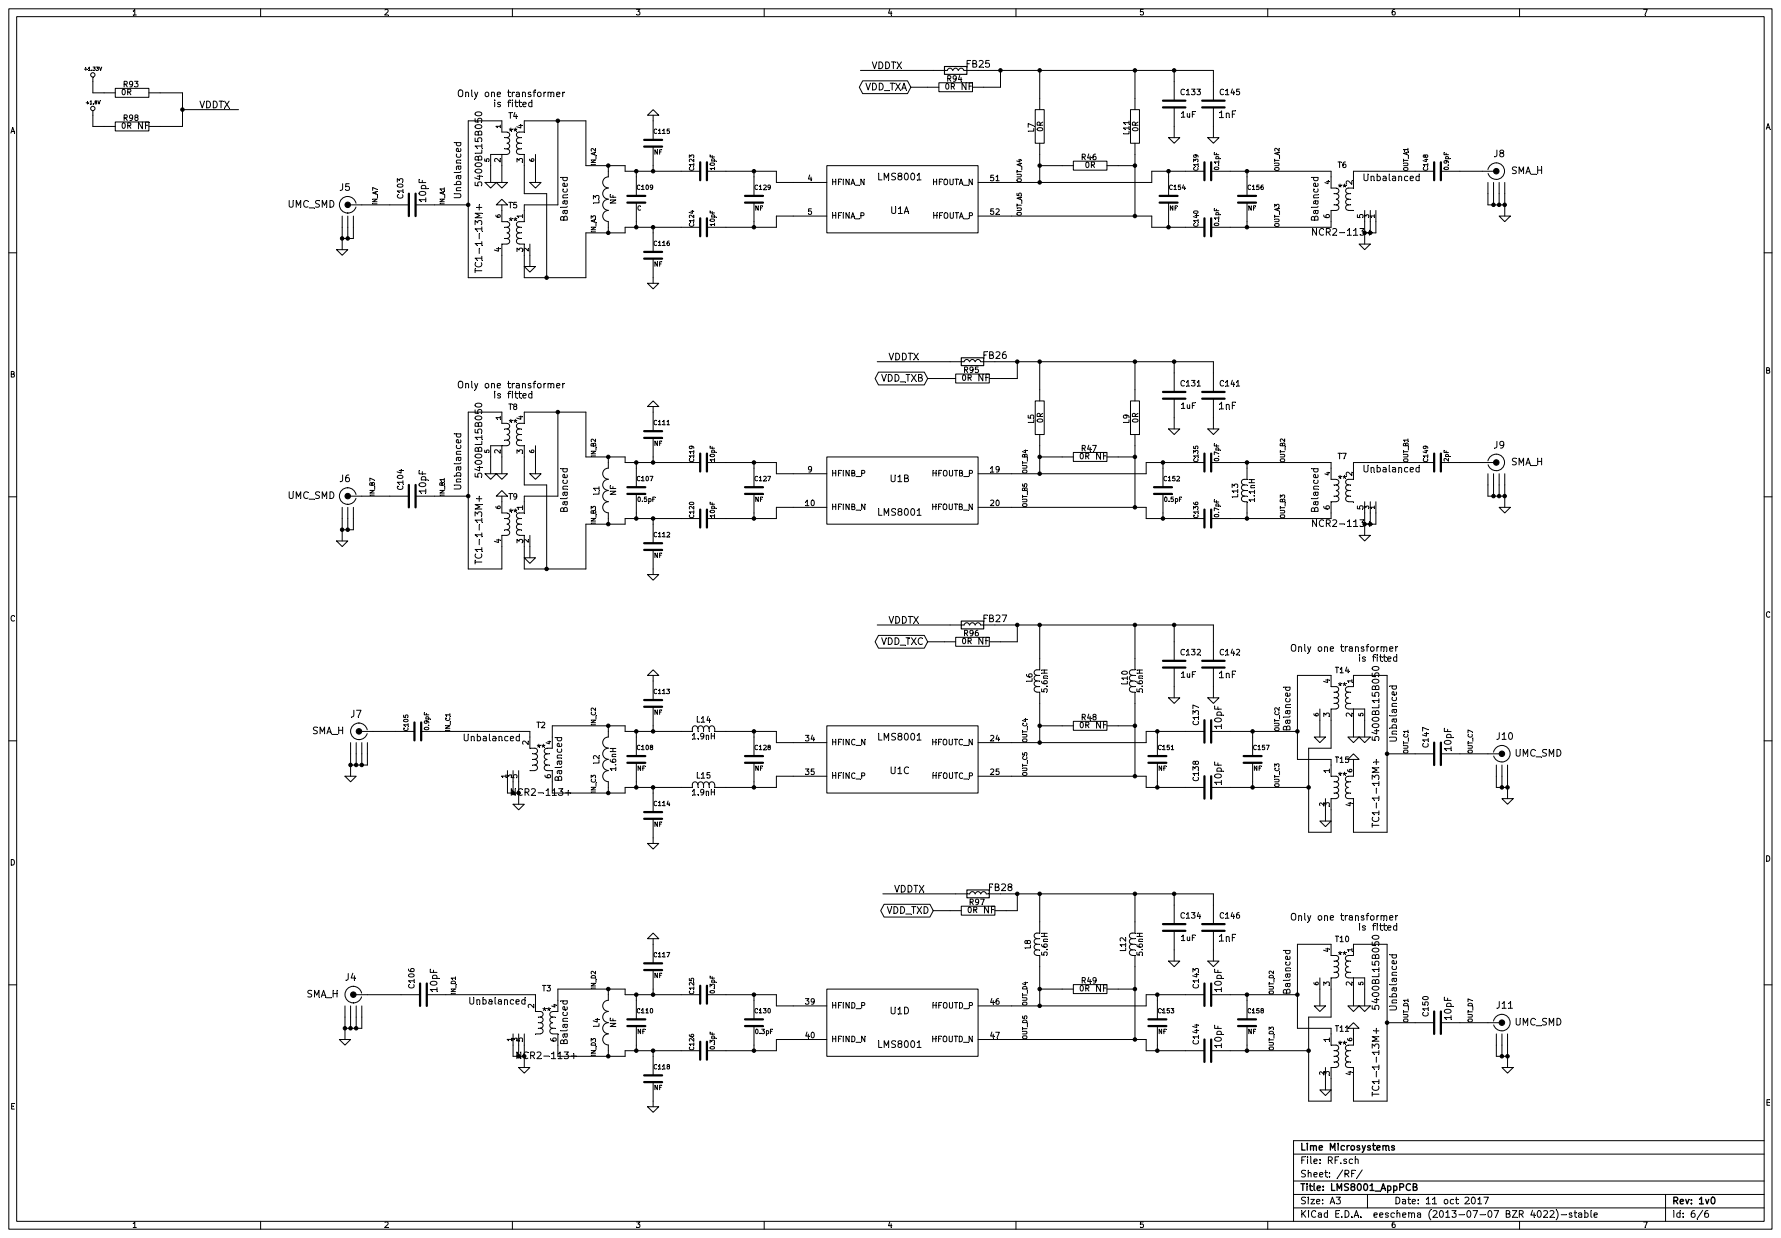
[picture p124: page 6]
