myriadrf/LMS8001-Companion/hardware/2v1/KiCAD/Clocks.sch

## KiCad design hardware/2v1/KiCAD/Clocks.sch (2017-10-17, an earlier design)

Schematic: Clocks.sch

Parts:
C67, C73, C74, C75, C79, C84, C85, C89, C100, C159, C162, C164, C171, C172, C173, C176, C178: 100NF_0402; SMD0402; Manufacturer Part Number GRM155R71C104KA88D
C68, C163, C166, C174: 1NF_0402; SMD0402; Manufacturer Part Number GCM155R71H102KA37D
C69: 1.2NF_0402; SMD0402; Manufacturer Part Number GRM155R71H122KA01D
C70: 470NF_0402; SMD0402; Manufacturer Part Number GRM155R61A474KE15D
C72: 68NF_0402; SMD0402; Manufacturer Part Number GRM155R71H683ME14D
C76: 10PF_0402; SMD0402; Manufacturer Part Number 04023A100JAT2A
C80: 220PF_0402; SMD0402; Manufacturer Part Number CC0402KRX7R9BB221
C94, C101, C102: 10PF_0201; SMD0201; Manufacturer Part Number C0603C0G1H100D030BA
C99: 18NF_0402; SMD0402; Manufacturer Part Number CC0402KRX7R7BB183
C160, C200, C201: 10UF_0603; SMD0603; Manufacturer Part Number GRM188R61C106MA73D
C161: 0.4PF_0201; SMD0201; Manufacturer Part Number GJM0335C1ER40WB01D
C165, C168, C175, C177: 10NF_0402; SMD0402; Manufacturer Part Number GCM155R71E103KA37D
FB22: FB_600R_0402; SMD0402; Manufacturer Part Number MMZ1005S601C
FB29: BLM18EG601SN1D; SMD0603; Manufacturer Part Number BLM18EG601SN1D
J3: SMA_VERT_SMD; SMA_vert_SMD; Manufacturer Part Number 0732511352
J13: UMC_SMD; Manufacturer Part Number 0734120110
LD6: LED; LED_0603; Manufacturer Part Number HSMG-C190
R42, R62, R107, R109, R110, R115, R116, R128, R201: 0R_0402; SMD0402; Manufacturer Part Number RC0402JR-070RL
R63: 69K8_0402; SMD0402; Manufacturer Part Number RC0402FR-0769K8L
R65: 5K1_0402; SMD0402; Manufacturer Part Number RC0402FR-075K1L
R66: 10R_0402; SMD0402; Manufacturer Part Number RC0402JR-0710RL
R67: 470R_0402; SMD0402; Manufacturer Part Number ERA-2AED471X
R69: 1K_0402; SMD0402; Manufacturer Part Number RMCF0402FT1K00
R70: 10K_0402; SMD0402; Manufacturer Part Number RC0402JR-0710KL
R74, R79: 51R_0402; SMD0402; Manufacturer Part Number CRCW040251R0FKED; Mouser Digi-Key
R76, R77, R78: 47R_0402; SMD0402; Manufacturer Part Number RC0402FR-0747RL
R80, R104, R105, R108: 0R_0402_NF; SMD0402; Manufacturer Part Number RC0402JR-070RL
R90: 0R_0201_NF; SMD0201; Manufacturer Part Number MCR006YRTJ000
R91, R92: 0R_0201; SMD0201; Manufacturer Part Number MCR006YRTJ000
R112: 33R2_0402; SMD0402; Manufacturer Part Number RC0402FR-0733R2L
R113, R124: 49R9_0402; SMD0402; Manufacturer Part Number RC0402FR-0749R9L
R114: 4K99_0402_NF; SMD0402; Manufacturer Part Number RC0402FR-074K99L
R121, R122: 39R_0402; SMD0402; Manufacturer Part Number RC0402FR-0739RL
T1: TR_TCM1-83X+; TCM1-63AX+; Manufacturer Part Number TCM1-83X+
U1: LMS8001
U18: ADF4002; LFCSP 20; Manufacturer Part Number ADF4002BCPZ-RL7
U21: NB3H83905C; TSSOP16_NB3H83905C; Manufacturer Part Number NB3H83905CDTG
XO3: RACON_TXCO_PLUTO+; SMD_TXCO_Pluto+; Manufacturer Part Number E6245LF
XO4: RTX5032A_40.000_MHZ; SMD_RTX5032A; Manufacturer Part Number RTX5032A

Notes on the sheet:
NEAR TO LMS8
TL_50_Ohm
33R2 or 0R
