myriadrf/LMS8001-Companion/hardware/2v1/KiCAD/LMS8001_PowerSupply.sch

## KiCad design hardware/2v1/KiCAD/LMS8001_PowerSupply.sch (2017-10-17, an earlier design)

Schematic: LMS8001_PowerSupply.sch

Parts:
C1, C2, C3, C5, C6, C7, C9, C11, C12, C13, C15, C16, C17, C18, C21, C22, C23, C24, C26, C27: 1UF_0201_TDK_X5R; SMD0201; Manufacturer Part Number C0603X5R0J105M030BC
C4, C8, C10, C14, C19, C20, C25: 1NF_0201; SMD0201; Manufacturer Part Number C0603X7R1E102K030BA
FB1, FB2, FB3, FB4, FB5, FB6, FB7, FB8, FB9, FB10, FB11, FB12, FB13, FB14, FB15: FB_0201; SMD0201; Manufacturer Part Number BK0603TS601-T
R1: 0R_0201; SMD0201; Manufacturer Part Number MCR006YRTJ000
R2: 10K_0402; SMD0402; Manufacturer Part Number RMCF0402FT10K0
U1: LMS8001
