myriadrf/LMS8001-Companion/hardware/2v1/KiCAD/PowerSupply.sch

## KiCad design hardware/2v1/KiCAD/PowerSupply.sch (2017-10-17, an earlier design)

Schematic: PowerSupply.sch

Parts:
C51, C52, C53, C54, C55, C58, C63, C65: 1UF_0402; SMD0402; Manufacturer Part Number CC0402ZRY5V5BB105
C57: 10UF_1206; SMD1206; Manufacturer Part Number CC1206ZKY5V7BB106
C59, C82: 1UF_0603; SMD0603; Manufacturer Part Number GRM188R61E105KA12D
C60, C61, C62, C64: 4.7UF_0402; SMD0402; Manufacturer Part Number GRM155R60J475ME87D
C66, C77, C81, C86: 10UF_0603; SMD0603; Manufacturer Part Number CC0603MRX5R5BB106
FB18, FB19, FB20, FB21: FB_60R_0805; SMD0805; Manufacturer Part Number MMZ2012Y600B
J2: PIN_HEADER_1X3; pin_header_1x3; Manufacturer Part Number 68000-103HLF
JP1: PINHEADER_2X3; Manufacturer Part Number 0015912060
LD5: LED; LED_0603; Manufacturer Part Number LG Q971-KN-1
R29: 19K6_0402; SMD0402; Manufacturer Part Number RC0402FR-0719K6L
R30, R32, R34, R36: 34K8_0402; SMD0402; Manufacturer Part Number RC0402FR-0734K8L
R31: 110K_0402; SMD0402; Manufacturer Part Number RC0402JR-07110KL
R33: 23K2_0402; SMD0402; Manufacturer Part Number RC0402FR-0723K2L
R35: 44K2_0402; SMD0402; Manufacturer Part Number RC0402FR-0744K2L
R37, R39, R43, R50, R52, R53, R54, R56, R68: 0R_0402; SMD0402; Manufacturer Part Number RC0402JR-070RL
R38, R40, R44, R210, R211: 0R_0402_NF; SMD0402; Manufacturer Part Number RC0402JR-070RL
R41: 10K_0402; SMD0402; Manufacturer Part Number RMCF0402FT10K0
R45: 4K99_0402; SMD0402; Manufacturer Part Number RC0402FR-074K99L
R55: 680R_0402; SMD0402; Manufacturer Part Number RC0402FR-07680RL
U5, U6, U7, U8: AP7361; U-DFN3030-8; Manufacturer Part Number AP7361-FGE-7
U9: NCP702_1V8; NCP702_TSOP5; Manufacturer Part Number NCP702SN33T1G
U10: ADM7155; LFCSP-8; Manufacturer Part Number ADM7155ACPZ-02-R7
U14: NCP349; 6-DFN; Manufacturer Part Number NCP349MNAETBG
U16: NCP702_3V3; NCP702_TSOP5; Manufacturer Part Number NCP702SN33T1G

Notes on the sheet:
EXTERNAL POWER +5V
POWER SOURCE SELECTION
(+1.8V_PLL)
(3.3V)
