myriadrf/LMS8001-Companion/hardware/2v1/KiCAD/RF.sch

## KiCad design hardware/2v1/KiCAD/RF.sch (2017-10-17, an earlier design)

Schematic: RF.sch

Parts:
C103, C104, C106, C137, C138, C143, C144, C147, C150: 10PF_0201; SMD0201; Manufacturer Part Number C0603C0G1H100D030BA
C105, C148: 0.9pF; SMD0201
C107, C152: 0.5pF; SMD0201
C108, C110, C111, C112, C113, C114, C115, C116, C117, C118, C127, C128, C129, C151, C153, C154, C156, C157, C158: NF; SMD0201
C109: C; SMD0201
C119, C120, C123, C124: 10pF; SMD0201
C125, C126, C130: 0.3pF; SMD0201
C131, C132, C133, C134: 1UF_0201_TDK_X5R; SMD0201; Manufacturer Part Number C0603X5R0J105M030BC
C135, C136: 0.7pF; SMD0201
C139, C140: 0.1pF; SMD0201
C141, C142, C145, C146: 1NF_0201; SMD0201; Manufacturer Part Number C0603X7R1E102K030BA
C149: 2pF; SMD0201
FB25, FB26, FB27, FB28: FB_0201; SMD0201; Manufacturer Part Number BK0603TS601-T
J4, J7, J8, J9: SMA_H; Manufacturer Part Number 142-0701-851
J5, J6, J10, J11: UMC_SMD; Manufacturer Part Number 0734120110
L1, L3, L4: NF; SMD0201
L2: 1.6nH; SMD0201
L5, L7, L9, L11: 0R_0402; IND_0402; Manufacturer Part Number RC0402JR-070RL
L6, L8, L10, L12: 5.6nH; IND_0402
L13: 1.1nH; SMD0201
L14, L15: 1.9nH; SMD0201
R46: 0R; SMD0201; Manufacturer Part Number MCR006YRTJ000
R47, R48, R49, R94, R95, R96, R97: 0R_0201_NF; SMD0201; Manufacturer Part Number MCR006YRTJ000
R93, R98: 0R_0805; SMD0805; Manufacturer Part Number RC0805JR-070RL
T2, T3, T6, T7: NCR2-113+; Manufacturer Part Number NCR2-113+
T4, T8, T10, T14: TR_5400BL15B050; 5400BL15B050_nosilk; Manufacturer Part Number 5400BL15B050
T5, T9, T11, T15: TR_TC1-1-13M+; TC1-1-13M+; Manufacturer Part Number TC1-1-13M+
U1: LMS8001

Notes on the sheet:
Unbalanced
Balanced
Only one transformer is fitted
