myriadrf/LMS8001-Companion/hardware/2v1/KiCAD/USBcontr.sch

## KiCad design hardware/2v1/KiCAD/USBcontr.sch (2017-10-17, an earlier design)

Schematic: USBcontr.sch

Parts:
C28, C31, C33, C34, C36, C38, C39, C40, C41: 100NF_0402; SMD0402; Manufacturer Part Number CC0402ZRY5V7BB104
C29, C30: 22PF_0402; SMD0402; Manufacturer Part Number CC0402JRNPO9BN220
C32: 3.9NF_0402; SMD0402; Manufacturer Part Number CL05B392JB5NNNC
C35, C42: 10UF_0603; SMD0603; Manufacturer Part Number CC0603MRX5R5BB106
C37: 1UF_0402; SMD0402; Manufacturer Part Number CC0402ZRY5V5BB105
FB16: FB_600R_2A_0805; SMD0805; Manufacturer Part Number MPZ2012S601AT000
FB17: FB_60R_0805; SMD0805; Manufacturer Part Number MMZ2012Y600B
J1: MINI-USB-UX60A-MB-5ST; SMD_UX60A-MB-5ST; Manufacturer Part Number UX60A-MB-5ST
LD1, LD2, LD3, LD4: LED; LED_0603; Manufacturer Part Number LG Q971-KN-1
P1, P12, P13, P14, P15, P16: CONN_1
P2, P3: MCU_SWD; HDRGPIO; Manufacturer Part Number M50-3600542
R3, R10, R11, R12, R14, R15: 10K_0402; SMD0402; Manufacturer Part Number RC0402JR-0710KL
R4, R5: 22R_0402; SMD0402; Manufacturer Part Number RC0402JR-0722RL
R6, R7, R8, R16: 470R_0402; SMD0402; Manufacturer Part Number ERA-2AED471X
R9, R17, R21, R22, R23, R24, R25, R26, R27, R28: 330R_0402; SMD0402; Manufacturer Part Number RC0402JR-07330RL
R13: 1M_0402; SMD0402; Manufacturer Part Number RC0402FR-071ML
R18, R19, R20: 10K_0402; SMD0402; Manufacturer Part Number RMCF0402FT10K0
SW1: MCU_RESET; B3U-1000P; Manufacturer Part Number B3U-1000P
SW2: SW; Switch 2way; Manufacturer Part Number GDH02S04
U1: LMS8001
U2: USBULC6-2P6; SOT-666; Manufacturer Part Number USBULC6-2P6
U3: STM32F105RBT6; LQFP64
U4: LP5900SD-3.3; LLP-6; Manufacturer Part Number LP5900SD-3.3/NOPB
X1: 8MHZ_4PIN; ABM3B; Manufacturer Part Number ABM3B-8.000MHZ-10-1-U-T
