myriadrf/LMS8001-Companion/hardware/3v2/KiCAD/Clocks.sch

## KiCad design hardware/3v2/KiCAD/Clocks.sch (2026-04-09)

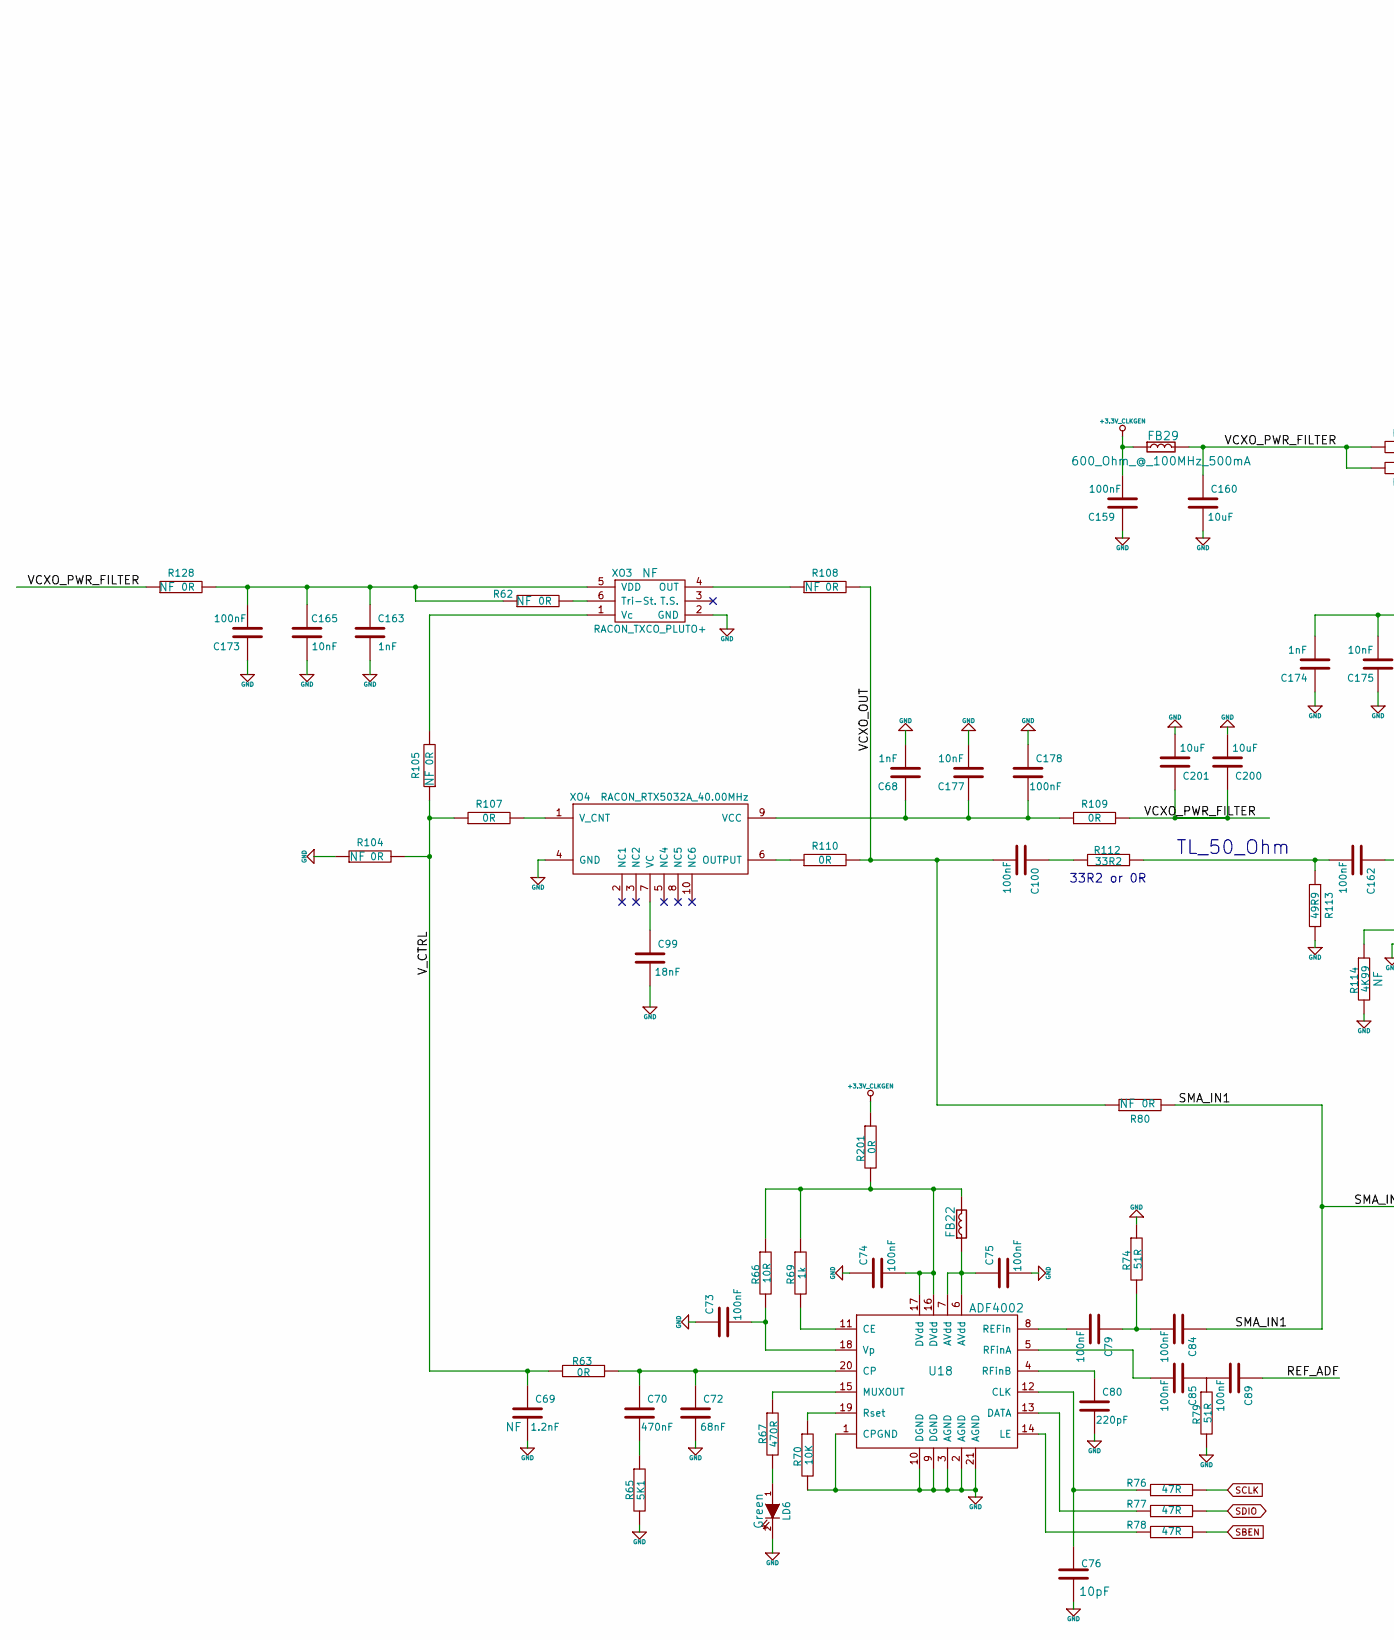
[picture p126: schematic Clocks.sch, part in row 1, column 1]

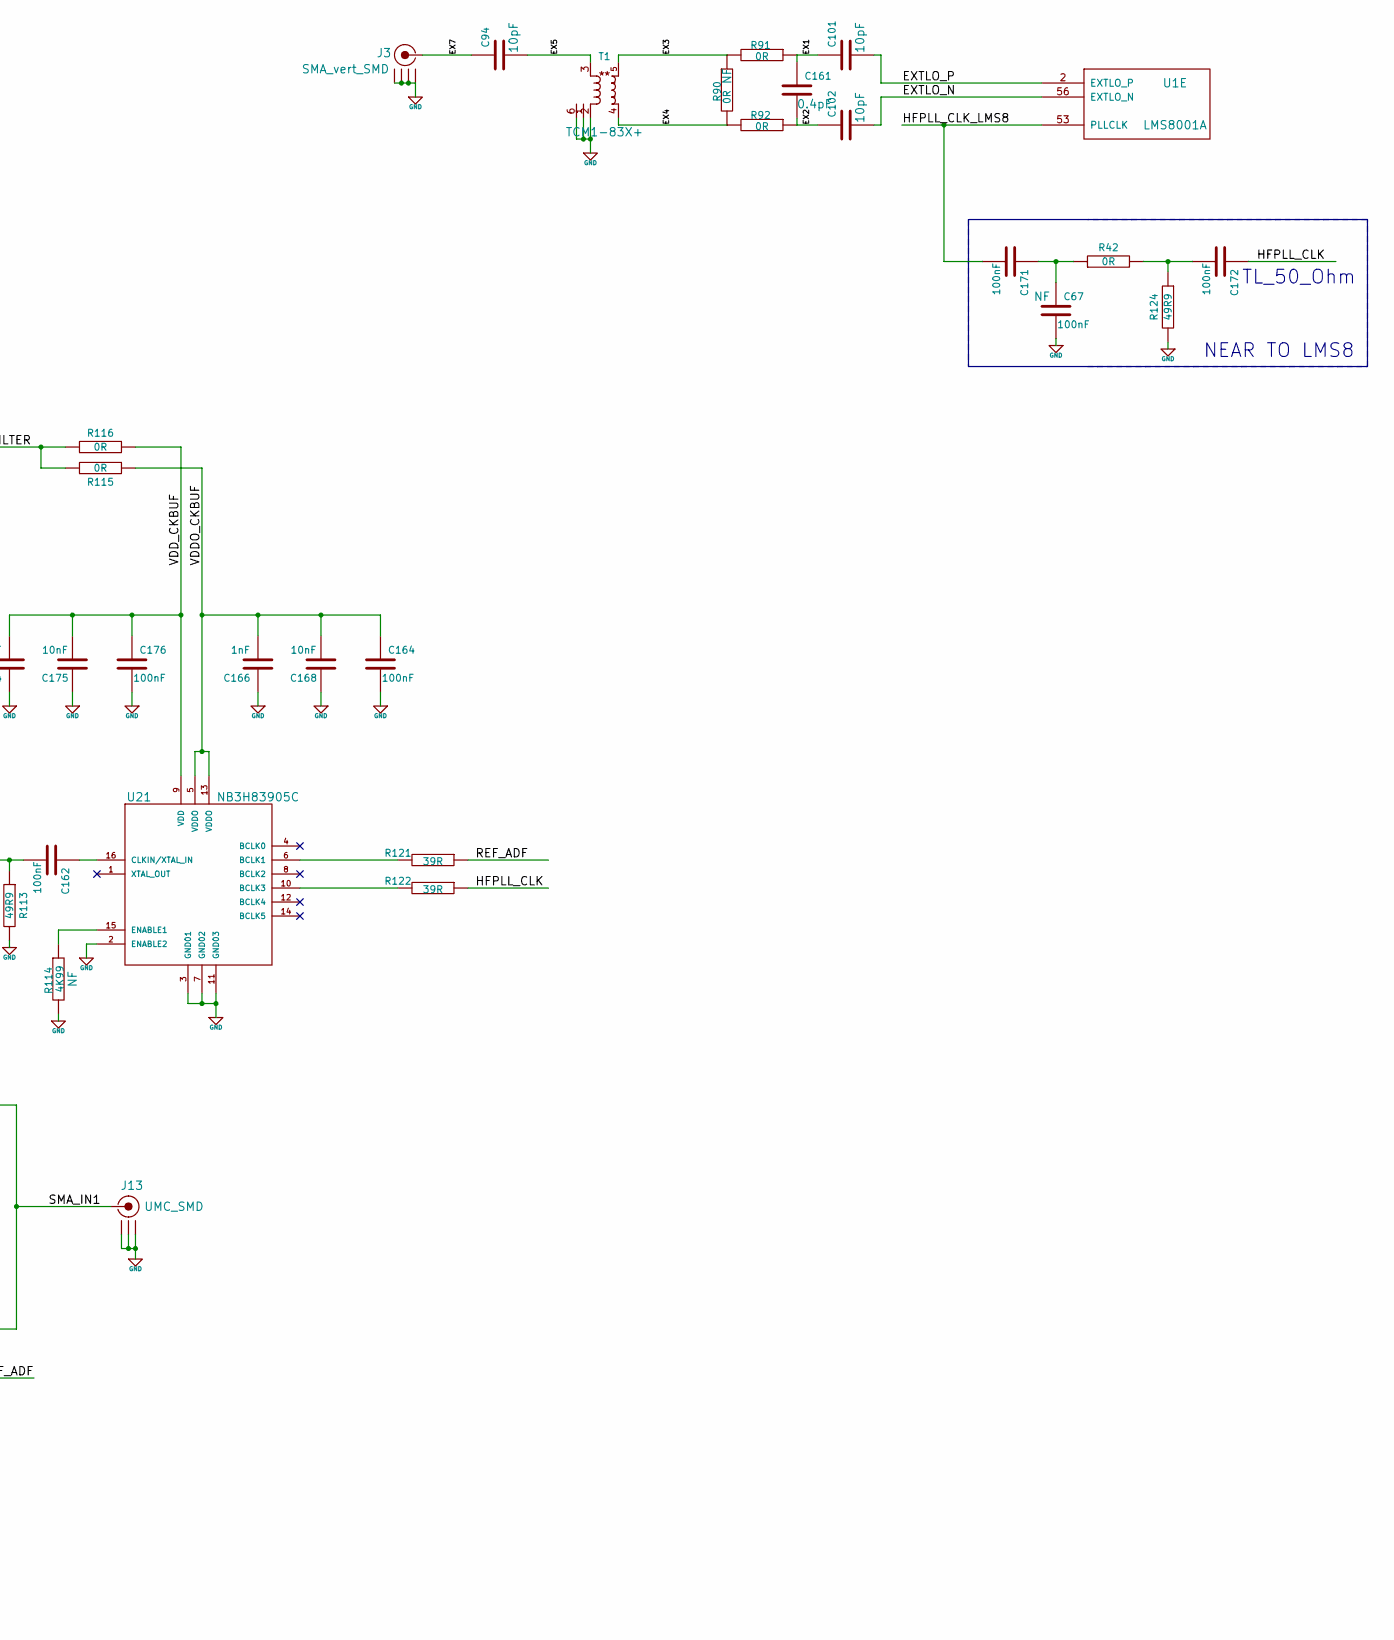
[picture p127: schematic Clocks.sch, part in row 1, column 2]

Parts:
C67: 100nF_0402_NF; SMD0402; Manufacturer Part Number CC0402ZRY5V7BB104
C68, C163, C166, C174: 1NF_0402; SMD0402; Manufacturer Part Number GCM155R71H102KA37D
C69: 1.2nF_0402_NF; SMD0402; Manufacturer Part Number GRM155R71H122KA01D
C70: 470NF_0402; SMD0402; Manufacturer Part Number GRM155R61A474KE15D
C72: 68NF_0402; SMD0402; Manufacturer Part Number GRM155R71H683ME14D
C73, C74, C75, C79, C84, C85, C89, C100, C159, C162, C164, C171, C172, C173, C176, C178: 100nF_0402; SMD0402; Manufacturer Part Number CC0402ZRY5V7BB104
C76: 10PF_0402; SMD0402; Manufacturer Part Number 04023A100JAT2A
C80: 220PF_0402; SMD0402; Manufacturer Part Number CC0402KRX7R9BB221
C94, C101, C102: 10pF_0201; SMD0201; Manufacturer Part Number C0603C0G1H100D030BA
C99: 18NF_0402; SMD0402; Manufacturer Part Number CC0402KRX7R7BB183
C160, C200, C201: 10UF_0603; SMD0603; Manufacturer Part Number GRM188R61C106MA73D
C161: 0.4PF_0201; SMD0201; Manufacturer Part Number GJM0335C1ER40WB01D
C165, C168, C175, C177: 10NF_0402; SMD0402; Manufacturer Part Number GCM155R71E103KA37D
FB22: FB_600R_0402; SMD0402; Manufacturer Part Number MMZ1005S601C
FB29: BLM18EG601SN1D; SMD0603; Manufacturer Part Number BLM18EG601SN1D
J3: SMA_vert_SMD; Manufacturer Part Number 0732511352
J13: UMC_SMD; Manufacturer Part Number 0734120110
LD6: LED; LED_0603; Manufacturer Part Number HSMG-C190
R42, R63, R107, R109, R110, R115, R116, R201: 0R_0402; SMD0402; Manufacturer Part Number RC0402JR-070RL
R62, R80, R104, R105, R108, R128: 0R_0402_NF; SMD0402; Manufacturer Part Number RC0402JR-070RL
R65: 5K1_0402; SMD0402; Manufacturer Part Number RC0402FR-075K1L
R66: 10R_0402; SMD0402; Manufacturer Part Number RC0402JR-0710RL
R67: 470R_0402; SMD0402; Manufacturer Part Number ERA-2AED471X
R69: 1K_0402; SMD0402; Manufacturer Part Number RMCF0402FT1K00
R70: 10K_0402; SMD0402; Manufacturer Part Number RC0402JR-0710KL
R74, R79: 51R_0402; SMD0402; Manufacturer Part Number CRCW040251R0FKED; Mouser Digi-Key
R76, R77, R78: 47R_0402; SMD0402; Manufacturer Part Number RC0402FR-0747RL
R90: 0R_0201_NF; SMD0201; Manufacturer Part Number MCR006YRTJ000
R91, R92: 0R_0201; SMD0201; Manufacturer Part Number MCR006YRTJ000
R112: 33R2_0402; SMD0402; Manufacturer Part Number RC0402FR-0733R2L
R113, R124: 49R9_0402; SMD0402; Manufacturer Part Number RC0402FR-0749R9L
R114: 4K99_0402_NF; SMD0402; Manufacturer Part Number RC0402FR-074K99L
R121, R122: 39R_0402; SMD0402; Manufacturer Part Number RC0402FR-0739RL
T1: TR_TCM1-83X+; TCM1-63AX+; Manufacturer Part Number TCM1-83X+
U1: LMS8001A; LMS8001; Manufacturer Part Number LMS8001A
U18: ADF4002; LFCSP 20; Manufacturer Part Number ADF4002BCPZ-RL7
U21: NB3H83905C; TSSOP16_NB3H83905C; Manufacturer Part Number NB3H83905CDTG
XO3: RACON_TXCO_Pluto+_NF; SMD_TXCO_Pluto+; Manufacturer Part Number E6245LF
XO4: RTX5032A_40.000_MHZ; SMD_RTX5032A; Manufacturer Part Number RTX5032A

Connections:
+3.3V_CLKGEN: C159.2, FB29.1, R201.1
EX1: C101.1, C161.1, R91.1
EX2: C102.1, C161.2, R92.1
EX3: R90.1, R91.2, T1.5
EX4: R90.2, R92.2, T1.4
EX5: C94.2, T1.3
EX7: C94.1, J3.1 (RF)
EXTLO_N: C102.2, U1.56 (EXTLO_N)
EXTLO_P: C101.2, U1.2 (EXTLO_P)
GND: C67.2, C68.2, C69.2, C72.2, C73.1, C74.1, C75.2, C76.2, C80.2, C99.2, C159.1, C160.2, C163.2, C164.2, C165.1, C166.1, C168.2, C173.1, C174.1, C175.2, C176.2, C177.1, C178.1, C200.2, C201.2, J3.2 (GND1), J3.3 (GND2), J3.4 (GND3), J3.5 (GND4), J13.2 (GND1), J13.3 (GND2), J13.4 (GND3), LD6.2 (K), R65.2, R70.2, R74.1, R79.2, R104.1, R113.2, R114.2, R124.2, T1.1, T1.2, T1.6, U18.1 (CPGND), U18.2 (AGND), U18.3 (AGND), U18.9 (DGND), U18.10 (DGND), U18.21 (AGND), U21.2 (ENABLE2), U21.3 (GND01), U21.7 (GND02), U21.11 (GND03), XO3.2 (GND), XO4.4 (GND)
HFPLL_CLK: C172.1, R122.1
HFPLL_CLK_LMS8: C171.2, U1.53 (PLLCLK)
unnamed: C70.1, C72.1, R63.1, U18.20 (CP)
unnamed: C70.2, R65.1
unnamed: C73.2, R66.2, U18.18 (Vp)
unnamed: C74.2, FB22.2, R66.1, R69.1, R201.2, U18.16 (DVdd), U18.17 (DVdd)
unnamed: C75.1, FB22.1, U18.6 (AVdd), U18.7 (AVdd)
unnamed: C76.1, R76.1, U18.12 (CLK)
unnamed: C79.1, C84.2, R74.2
unnamed: C79.2, U18.8 (REFin)
unnamed: C80.1, U18.4 (RFinB)
unnamed: C85.1, C89.2, R79.1
unnamed: C85.2, U18.5 (RFinA)
unnamed: C99.1, XO4.7 (VC)
unnamed: C100.1, R112.2
unnamed: C162.1, U21.16 (CLKIN/XTAL_IN)
unnamed: C162.2, R112.1, R113.1
unnamed: C163.1, C165.2, C173.2, R62.1, R128.2, XO3.5 (VDD)
unnamed: C67.1, C171.1, R42.1
unnamed: C172.2, R42.2, R124.1
unnamed: C68.1, C177.2, C178.2, R109.1, XO4.9 (VCC)
unnamed: LD6.1 (A), R67.2
unnamed: R62.2, XO3.6 (Tri-St.)
unnamed: R67.1, U18.15 (MUXOUT)
unnamed: R69.2, U18.11 (CE)
unnamed: R70.1, U18.19 (Rset)
unnamed: R77.1, U18.13 (DATA)
unnamed: R78.1, U18.14 (LE)
unnamed: R105.2, XO3.1 (Vc)
unnamed: R107.2, XO4.1 (V_CNT)
unnamed: R108.1, XO3.4 (OUT)
unnamed: R110.1, XO4.6 (OUTPUT)
unnamed: R114.1, U21.15 (ENABLE1)
unnamed: R121.2, U21.6 (BCLK1)
unnamed: R122.2, U21.10 (BCLK3)
REF_ADF: C89.1, R121.1
SBEN: R78.2
SCLK: R76.2
SDIO: R77.2
SMA_IN1: C84.1, J13.1 (RF), R80.2
VCXO_OUT: C100.2, R80.1, R108.2, R110.2
VCXO_PWR_FILTER: C160.1, C200.1, C201.1, FB29.2, R109.2, R115.2, R116.2, R128.1
VDDO_CKBUF: C164.1, C166.2, C168.1, R115.1, U21.5 (VDDO), U21.13 (VDDO)
VDD_CKBUF: C174.2, C175.1, C176.1, R116.1, U21.9 (VDD)
V_CTRL: C69.1, R63.2, R104.2, R105.1, R107.1

Notes on the sheet:
NEAR TO LMS8
TL_50_Ohm
33R2 or 0R
