myriadrf/LMS8001-Companion/hardware/3v2/KiCAD/RF.sch

## KiCad design hardware/3v2/KiCAD/RF.sch (2026-04-09)

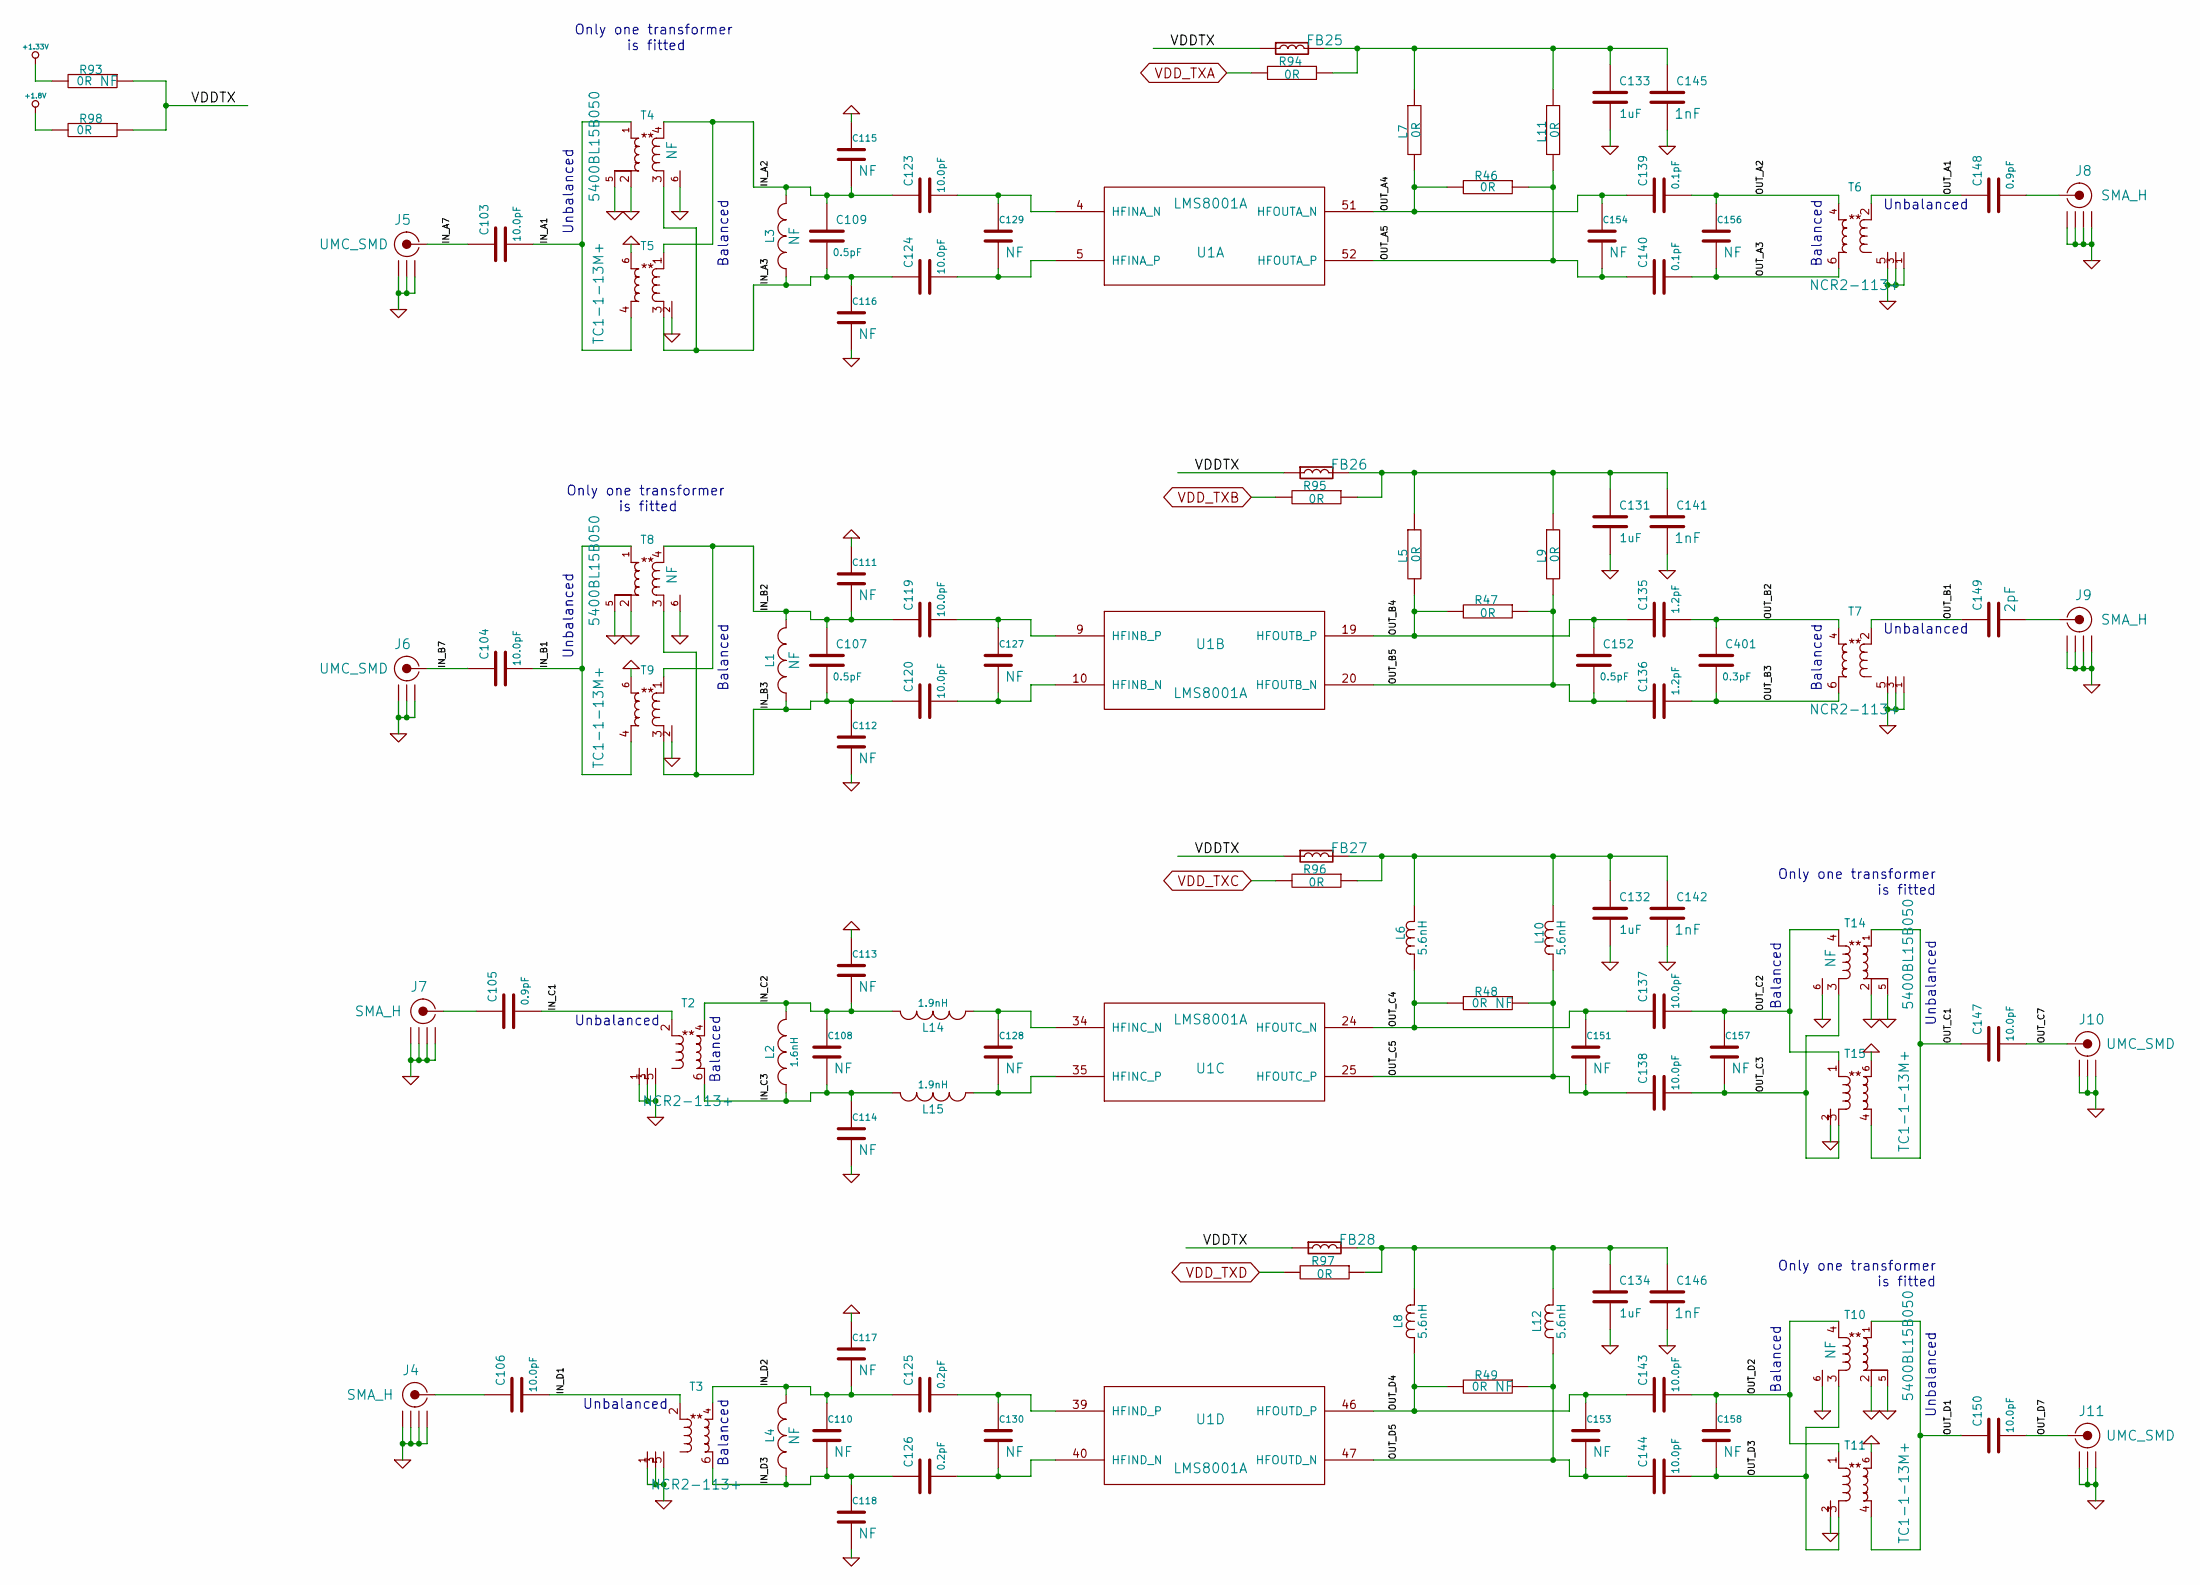
[picture p128: schematic RF.sch]

Parts:
C103, C104, C106, C119, C120, C123, C124, C137, C138, C143, C144, C147, C150: 10.0pF_0201; SMD0201; Manufacturer Part Number GRM0335C1H100JA01J
C105, C148: 0.9pF_0201; SMD0201; Manufacturer Part Number GRM0335C1HR90BA01D
C107, C109, C152: 0.5pF_0201; SMD0201; Manufacturer Part Number GJM0335C1ER50BB01D
C108, C110, C111, C112, C113, C114, C115, C116, C117, C118, C127, C128, C129, C130, C151, C153, C154, C156, C157, C158: cap_0201_NF; SMD0201
C125, C126: 0.2pF_0201; SMD0201; Manufacturer Part Number GRM0335C1HR20BA01D
C131, C132, C133, C134: 1UF_0201_TDK_X5R; SMD0201; Manufacturer Part Number C0603X5R0J105M030BC
C135, C136: 1.2pF_0201; SMD0201; Manufacturer Part Number GRM0335C1H1R2CA01D
C139, C140: 0.1pF_0201; SMD0201; Manufacturer Part Number GRM0335C1ER10WA01D
C141, C142, C145, C146: 1NF_0201; SMD0201; Manufacturer Part Number C0603X7R1E102K030BA
C149: 2pF_0201; SMD0201; Manufacturer Part Number GJM0335C1E2R0CB01D
C401: 0.3pF_0201; SMD0201; Manufacturer Part Number GRM0335C1HR30BA01D
FB25, FB26, FB27, FB28: FB_0201; SMD0201; Manufacturer Part Number BK0603TS601-T
J4, J7, J8, J9: SMA_H; Manufacturer Part Number 142-0701-851
J5, J6, J10, J11: UMC_SMD; Manufacturer Part Number 0734120110
L1, L3, L4: ind_0201_NF; SMD0201
L2: 1.6nH_SMD0201; SMD0201; Manufacturer Part Number LQP03TN1N6B02D
L5, L7, L9, L11: 0R_0402; IND_0402; Manufacturer Part Number RC0402JR-070RL
L6, L8, L10, L12: 5.6nH; IND_0402
L14, L15: 1.9nH_SMD0201; SMD0201; Manufacturer Part Number LQP03TN1N9B02D
R46: 0R; SMD0201; Manufacturer Part Number MCR006YRTJ000
R47, R94, R95, R96, R97: 0R_0201; SMD0201; Manufacturer Part Number MCR006YRTJ000
R48, R49: 0R_0201_NF; SMD0201; Manufacturer Part Number MCR006YRTJ000
R93: 0R_0805_NF; SMD0805; Manufacturer Part Number RC0805JR-070RL
R98: 0R_0805; SMD0805; Manufacturer Part Number RC0805JR-070RL
T2, T3, T6, T7: NCR2-113+; Manufacturer Part Number NCR2-113+
T4, T8, T10, T14: TR_5400BL15B050_NF; 5400BL15B050; Manufacturer Part Number 5400BL15B050
T5, T9, T11, T15: TR_TC1-1-13M+; TC1-1-13M+; Manufacturer Part Number TC1-1-13M+
U1: LMS8001A; LMS8001; Manufacturer Part Number LMS8001A

Connections:
+1.8V: R98.2
+1.33V: R93.2
GND: C111.1, C112.2, C113.1, C114.2, C115.1, C116.2, C117.1, C118.2, C131.2, C132.2, C133.2, C134.2, C141.2, C142.2, C145.2, C146.2, J4.2 (GND1), J4.3 (GND2), J4.4 (GND3), J4.5 (GND4), J5.2 (GND1), J5.3 (GND2), J5.4 (GND3), J6.2 (GND1), J6.3 (GND2), J6.4 (GND3), J7.2 (GND1), J7.3 (GND2), J7.4 (GND3), J7.5 (GND4), J8.2 (GND1), J8.3 (GND2), J8.4 (GND3), J8.5 (GND4), J9.2 (GND1), J9.3 (GND2), J9.4 (GND3), J9.5 (GND4), J10.2 (GND1), J10.3 (GND2), J10.4 (GND3), J11.2 (GND1), J11.3 (GND2), J11.4 (GND3), T2.1 (GND), T2.3 (GND), T2.5 (GND), T3.1 (GND), T3.3 (GND), T3.5 (GND), T4.2, T4.5 (GND), T4.6 (NC), T5.2, T5.6, T6.1 (GND), T6.3 (GND), T6.5 (GND), T7.1 (GND), T7.3 (GND), T7.5 (GND), T8.2, T8.5 (GND), T8.6 (NC), T9.2, T9.6, T10.2, T10.5 (GND), T10.6 (NC), T11.2, T11.6, T14.2, T14.5 (GND), T14.6 (NC), T15.2, T15.6
IN_A1: C103.2, T4.1, T5.4
IN_A2: C109.1, C115.2, C123.1, L3.2, T4.4, T5.1
IN_A3: C109.2, C116.1, C124.1, L3.1, T4.3, T5.3
IN_A7: C103.1, J5.1 (RF)
IN_B1: C104.2, T8.1, T9.4
IN_B2: C107.1, C111.2, C119.1, L1.2, T8.4, T9.1
IN_B3: C107.2, C112.1, C120.1, L1.1, T8.3, T9.3
IN_B7: C104.1, J6.1 (RF)
IN_C1: C105.2, T2.2
IN_C2: C108.1, C113.2, L2.2, L14.2, T2.4
IN_C3: C108.2, C114.1, L2.1, L15.2, T2.6
IN_D1: C106.2, T3.2
IN_D2: C110.1, C117.2, C125.1, L4.2, T3.4
IN_D3: C110.2, C118.1, C126.1, L4.1, T3.6
unnamed: C105.1, J7.1 (RF)
unnamed: C106.1, J4.1 (RF)
unnamed: C119.2, C127.1, U1.9 (HFINB_P)
unnamed: C120.2, C127.2, U1.10 (HFINB_N)
unnamed: C123.2, C129.1, U1.4 (HFINA_N)
unnamed: C124.2, C129.2, U1.5 (HFINA_P)
unnamed: C125.2, C130.1, U1.39 (HFIND_P)
unnamed: C126.2, C130.2, U1.40 (HFIND_N)
unnamed: C128.1, L14.1, U1.34 (HFINC_N)
unnamed: C128.2, L15.1, U1.35 (HFINC_P)
unnamed: C131.1, C141.1, FB26.2, L5.1, L9.1, R95.1
unnamed: C132.1, C142.1, FB27.2, L6.1, L10.1, R96.1
unnamed: C133.1, C145.1, FB25.2, L7.1, L11.1, R94.1
unnamed: C134.1, C146.1, FB28.2, L8.1, L12.1, R97.1
unnamed: C148.2, J8.1 (RF)
unnamed: C149.2, J9.1 (RF)
OUT_A1: C148.1, T6.2
OUT_A2: C139.2, C156.1, T6.4
OUT_A3: C140.2, C156.2, T6.6
OUT_A4: C139.1, C154.1, L7.2, R46.2, U1.51 (HFOUTA_N)
OUT_A5: C140.1, C154.2, L11.2, R46.1, U1.52 (HFOUTA_P)
OUT_B1: C149.1, T7.2
OUT_B2: C135.2, C401.1, T7.4
OUT_B3: C136.2, C401.2, T7.6
OUT_B4: C135.1, C152.1, L5.2, R47.2, U1.19 (HFOUTB_P)
OUT_B5: C136.1, C152.2, L9.2, R47.1, U1.20 (HFOUTB_N)
OUT_C1: C147.1, T14.1, T15.4
OUT_C2: C137.2, C157.1, T14.4, T15.1
OUT_C3: C138.2, C157.2, T14.3, T15.3
OUT_C4: C137.1, C151.1, L6.2, R48.2, U1.24 (HFOUTC_N)
OUT_C5: C138.1, C151.2, L10.2, R48.1, U1.25 (HFOUTC_P)
OUT_C7: C147.2, J10.1 (RF)
OUT_D1: C150.1, T10.1, T11.4
OUT_D2: C143.2, C158.1, T10.4, T11.1
OUT_D3: C144.2, C158.2, T10.3, T11.3
OUT_D4: C143.1, C153.1, L8.2, R49.2, U1.46 (HFOUTD_P)
OUT_D5: C144.1, C153.2, L12.2, R49.1, U1.47 (HFOUTD_N)
OUT_D7: C150.2, J11.1 (RF)
VDDTX: FB25.1, FB26.1, FB27.1, FB28.1, R93.1, R98.1
VDD_TXA: R94.2
VDD_TXB: R95.2
VDD_TXC: R96.2
VDD_TXD: R97.2

Notes on the sheet:
Unbalanced
Balanced
Only one transformer is fitted
