myriadrf/LMS8001-Companion/Python/HW_2v1/Python2/pyLMS8001/pyLMS8001/LMS8001_REGDESC.py

LMS8001_REGDESC="""

REGBANK ChipConfig 0x000X
REGBANK BiasLDOConfig 0x001X
REGBANK Channel_A 0b00010000000XXXXX
REGBANK Channel_B 0b00010000001XXXXX
REGBANK Channel_C 0b00010000010XXXXX
REGBANK Channel_D 0b00010000011XXXXX
REGBANK HLMIXA 0x200X
REGBANK HLMIXB 0x201X
REGBANK HLMIXC 0x202X
REGBANK HLMIXD 0x203X
REGBANK PLL_CONFIGURATION 0b01000000000XXXXX
REGBANK PLL_PROFILE_0 0x410X
REGBANK PLL_PROFILE_1 0x411X
REGBANK PLL_PROFILE_2 0x412X
REGBANK PLL_PROFILE_3 0x413X
REGBANK PLL_PROFILE_4 0x414X
REGBANK PLL_PROFILE_5 0x415X
REGBANK PLL_PROFILE_6 0x416X
REGBANK PLL_PROFILE_7 0x417X
REGISTER    SPIConfig    0x0000
    BITFIELD   SPI_SDIO_DS
        POSITION=6
        DEFAULT=0
        MODE=RW
        #! Driver strength of SPI_SDIO pad.
        #!      0 - Driver strength is 4mA (default)
        #!      1 - Driver strength is 8mA
    ENDBITFIELD
    BITFIELD   SPI_SDO_DS
        POSITION=5
        DEFAULT=0
        MODE=RW
        #! Driver strength of SPI_SDO pad.
        #!      0 - Driver strength is 4mA (default)
        #!      1 - Driver strength is 8mA
    ENDBITFIELD
    BITFIELD   SPI_SDIO_PE
        POSITION=4
        DEFAULT=1
        MODE=RW
        #! Pull up control of SPI_SDIO pad.
        #!      0 - Pull up disengaged
        #!      1 - Pull up engaged (default)
    ENDBITFIELD
    BITFIELD   SPI_SDO_PE
        POSITION=3
        DEFAULT=1
        MODE=RW
        #! Pull up control of SPI_SDO pad.
        #!      0 - Pull up disengaged
        #!      1 - Pull up engaged (default)
    ENDBITFIELD
    BITFIELD   SPI_SCLK_PE
        POSITION=2
        DEFAULT=1
        MODE=RW
        #! Pull up control of SPI_SCLK pad.
        #!      0 - Pull up disengaged
        #!      1 - Pull up engaged (default)
    ENDBITFIELD
    BITFIELD   SPI_SEN_PE
        POSITION=1
        DEFAULT=1
        MODE=RW
        #! Pull up control of SPI_SEN pad.
        #!      0 - Pull up disengaged
        #!      1 - Pull up engaged (default)
    ENDBITFIELD
    BITFIELD   SPIMODE
        POSITION=0
        DEFAULT=1
        MODE=RWI
        #! SPI communication mode.
        #!     0 - 3 wire mode
        #!     1 - 4 wire mode (default)
    ENDBITFIELD
ENDREGISTER

REGISTER    GPIOOutData    0x0004
    BITFIELD   GPIO_OUT_SPI<8:0>
        POSITION=<8:0>
        DEFAULT=000000000
        MODE=RWI
        #! Output data for GPIO pads from SPI
    ENDBITFIELD
ENDREGISTER

REGISTER    GPIOOUT_SEL0    0x0005
    BITFIELD   GPIO4_SEL<2:0>
        POSITION=<14:12>
        DEFAULT=000
        MODE=RWI
        #! GPIO4 source select
        #!     000 - from SPI
        #!     001 - PLL_LOCK
        #!     010 - VTUNE_LOW
        #!     011 - VTUNE_HIGH
        #!     100 - Fast lock active
        #!     others - reserved
    ENDBITFIELD
    BITFIELD   GPIO3_SEL<2:0>
        POSITION=<11:9>
        DEFAULT=000
        MODE=RWI
        #! GPIO3 source select
        #!     000 - from SPI
        #!     001 - PLL_LOCK
        #!     010 - VTUNE_LOW
        #!     011 - VTUNE_HIGH
        #!     100 - Fast lock active
        #!     others - reserved
    ENDBITFIELD
    BITFIELD   GPIO2_SEL<2:0>
        POSITION=<8:6>
        DEFAULT=000
        MODE=RWI
        #! GPIO2 source select
        #!     000 - from SPI
        #!     001 - PLL_LOCK
        #!     010 - VTUNE_LOW
        #!     011 - VTUNE_HIGH
        #!     100 - Fast lock active
        #!     others - reserved
    ENDBITFIELD
    BITFIELD   GPIO1_SEL<2:0>
        POSITION=<5:3>
        DEFAULT=000
        MODE=RWI
        #! GPIO1 source select
        #!     000 - from SPI
        #!     001 - PLL_LOCK
        #!     010 - VTUNE_LOW
        #!     011 - VTUNE_HIGH
        #!     100 - Fast lock active
        #!     others - reserved
    ENDBITFIELD
    BITFIELD   GPIO0_SEL<2:0>
        POSITION=<2:0>
        DEFAULT=000
        MODE=RWI
        #! GPIO0 source select
        #!     000 - from SPI
        #!     001 - PLL_LOCK
        #!     010 - VTUNE_LOW
        #!     011 - VTUNE_HIGH
        #!     100 - Fast lock active
        #!     others - reserved
    ENDBITFIELD
ENDREGISTER

REGISTER    GPIOOUT_SEL1    0x0006
    BITFIELD   GPIO9_SEL<2:0>
        POSITION=<14:12>
        DEFAULT=000
        MODE=RWI
        #! GPIO9 source select
        #!     000 - from SPI
        #!     001 - PLL_LOCK
        #!     010 - VTUNE_LOW
        #!     011 - VTUNE_HIGH
        #!     100 - Fast lock active
        #!     others - reserved
    ENDBITFIELD
    BITFIELD   GPIO8_SEL<2:0>
        POSITION=<11:9>
        DEFAULT=000
        MODE=RWI
        #! GPIO8 source select
        #!     000 - from SPI
        #!     001 - PLL_LOCK
        #!     010 - VTUNE_LOW
        #!     011 - VTUNE_HIGH
        #!     100 - Fast lock active
        #!     others - reserved
    ENDBITFIELD
    BITFIELD   GPIO7_SEL<2:0>
        POSITION=<8:6>
        DEFAULT=000
        MODE=RWI
        #! GPIO7 source select
        #!     000 - from SPI
        #!     001 - PLL_LOCK
        #!     010 - VTUNE_LOW
        #!     011 - VTUNE_HIGH
        #!     100 - Fast lock active
        #!     others - reserved
    ENDBITFIELD
    BITFIELD   GPIO6_SEL<2:0>
        POSITION=<5:3>
        DEFAULT=000
        MODE=RWI
        #! GPIO6 source select
        #!     000 - from SPI
        #!     001 - PLL_LOCK
        #!     010 - VTUNE_LOW
        #!     011 - VTUNE_HIGH
        #!     100 - Fast lock active
        #!     others - reserved
    ENDBITFIELD
    BITFIELD   GPIO5_SEL<2:0>
        POSITION=<2:0>
        DEFAULT=000
        MODE=RWI
        #! GPIO5 source select
        #!     000 - from SPI
        #!     001 - PLL_LOCK
        #!     010 - VTUNE_LOW
        #!     011 - VTUNE_HIGH
        #!     100 - Fast lock active
        #!     others - reserved
    ENDBITFIELD
ENDREGISTER

REGISTER    GPIOInData    0x0008
    BITFIELD   GPIO_IN<8:0>
        POSITION=<8:0>
        DEFAULT=000000000
        MODE=R
        #! Data read from GPIO pads.
    ENDBITFIELD
ENDREGISTER

REGISTER    GPIOConfig_PE    0x0009
    BITFIELD   GPIO_PE<8:0>
        POSITION=<8:0>
        DEFAULT=111111111
        MODE=RW
        #! GPIO pull up control
        #!      0 - Pull up disengaged
        #!      1 - Pull up engaged (default)
    ENDBITFIELD
ENDREGISTER

REGISTER    GPIOConfig_DS    0x000A
    BITFIELD   GPIO_DS<8:0>
        POSITION=<8:0>
        DEFAULT=000000000
        MODE=RW
        #! GPIO drive strength
        #!      0 - Driver strength is 4mA (default)
        #!      1 - Driver strength is 8mA
    ENDBITFIELD
ENDREGISTER

REGISTER    GPIOConfig_IO    0x000B
    BITFIELD   GPIO_InO<8:0>
        POSITION=<8:0>
        DEFAULT=111111111
        MODE=RW
        #! GPIO input/output control
        #!      0 - Pin is output
        #!      1 - Pin is input (default)
    ENDBITFIELD
ENDREGISTER

REGISTER    TEMP_SENS    0x000C
    BITFIELD   TEMP_SENS_EN
        POSITION=10
        DEFAULT=0
        MODE=RW
        #! Enable the temperature sensor biasing.
    ENDBITFIELD
    BITFIELD   TEMP_SENS_CLKEN
        POSITION=9
        DEFAULT=0
        MODE=RW
        #! Temperature sensor clock enable.
    ENDBITFIELD
    BITFIELD   TEMP_START_CONV
        POSITION=8
        DEFAULT=0
        MODE=STICKYBIT
        #! Start the temperature conversion.
        #! Bit is cleared when the conversion is complete.
    ENDBITFIELD
    BITFIELD   TEMP_READ<7:0>
        POSITION=<7:0>
        DEFAULT=00000000
        MODE=R
        #! Readout of temperature sensor
    ENDBITFIELD
ENDREGISTER

REGISTER    ChipInfo    0x000F
    BITFIELD   VER<4:0>
        POSITION=<15:11>
        DEFAULT=01000
        MODE=RI
        #! Chip version.
        #!     01000 - Chip version is 8.
    ENDBITFIELD
    BITFIELD   REV<4:0>
        POSITION=<10:6>
        DEFAULT=00001
        MODE=RI
        #! Chip revision.
        #!     00001 - Chip revision is 1.
    ENDBITFIELD
    BITFIELD   MASK<5:0>
        POSITION=<5:0>
        DEFAULT=000000
        MODE=RI
        #! Chip mask.
        #!     000000 - Chip mask is 0.
    ENDBITFIELD
ENDREGISTER

REGISTER    BiasConfig    0x0010
    BITFIELD   PD_CALIB_COMP
        POSITION=12
        DEFAULT=1
        MODE=RW
        #! Calibration comparator power down.
        #!      0 - Enabled
        #!      1 - Powered down (default)
    ENDBITFIELD
    BITFIELD   RP_CALIB_COMP
        POSITION=11
        DEFAULT=0
        MODE=R
        #! Comparator output. Used in rppolywo calibration algorithm.
    ENDBITFIELD
    BITFIELD   RP_CALIB_BIAS<4:0>
        POSITION=<10:6>
        DEFAULT=10000
        MODE=RW
        #! Calibration code for rppolywo. This code is set by calibration algorithm.
        #! Default value : 10000 (16)
    ENDBITFIELD
    BITFIELD   PD_FRP_BIAS
        POSITION=4
        DEFAULT=0
        MODE=RW
        #! Power down signal for Fix/RP
        #!     0 - Enabled (default)
        #!     1 - Powered down
    ENDBITFIELD
    BITFIELD   PD_F_BIAS
        POSITION=3
        DEFAULT=0
        MODE=RW
        #! Power down signal for Fix
        #!     0 - Enabled (default)
        #!     1 - Powered down
    ENDBITFIELD
    BITFIELD   PD_PTRP_BIAS
        POSITION=2
        DEFAULT=0
        MODE=RW
        #! Power down signal for PTAT/RP block
        #!     0 - Enabled (default)
        #!     1 - Powered down
    ENDBITFIELD
    BITFIELD   PD_PT_BIAS
        POSITION=1
        DEFAULT=0
        MODE=RW
        #! Power down signal for PTAT block
        #!     0 - Enabled (default)
        #!     1 - Powered down
    ENDBITFIELD
    BITFIELD   PD_BIAS
        POSITION=0
        DEFAULT=0
        MODE=RW
        #! Enable signal for central bias block
        #!     0 - Sub blocks may be selectively powered down (default)
        #!     1 - Poweres down all BIAS blocks
    ENDBITFIELD
ENDREGISTER

REGISTER    LOBUFA_LDO_Config    0x0011
    BITFIELD   EN_LOADIMP_LDO_LOBUFA
        POSITION=10
        DEFAULT=0
        MODE=RW
        #! Enables the load dependent bias to optimize the load regulation
        #!     0 - Constant bias (default)
        #!     1 - Load dependant bias
    ENDBITFIELD
    BITFIELD   SPDUP_LDO_LOBUFA
        POSITION=9
        DEFAULT=0
        MODE=RW
        #! Short the noise filter resistor to speed up the settling time
        #!     0 - Noise filter resistor in place (default)
        #!     1 - Noise filter resistor bypassed
    ENDBITFIELD
    BITFIELD   EN_LDO_LOBUFA
        POSITION=8
        DEFAULT=0
        MODE=RW
        #! Enables the LO buffer LDO
        #!     0 - LDO powered down  (default)
        #!     1 - LDO enabled
    ENDBITFIELD
    BITFIELD   RDIV_LOBUFA<7:0>
        POSITION=<7:0>
        DEFAULT=01100101
        MODE=RW
        #! Controls the output voltage of the LO buffer LDO by setting the resistive voltage divider ratio.
        #! Vout = 860 mV + 3.92 mV * RDIV
        #! Default : 01100101 (101) Vout = 1.25 V
    ENDBITFIELD
ENDREGISTER

REGISTER    LOBUFB_LDO_Config    0x0012
    BITFIELD   EN_LOADIMP_LDO_LOBUFB
        POSITION=10
        DEFAULT=0
        MODE=RW
        #! Enables the load dependent bias to optimize the load regulation
        #!     0 - Constant bias (default)
        #!     1 - Load dependant bias
    ENDBITFIELD
    BITFIELD   SPDUP_LDO_LOBUFB
        POSITION=9
        DEFAULT=0
        MODE=RW
        #! Short the noise filter resistor to speed up the settling time
        #!     0 - Noise filter resistor in place (default)
        #!     1 - Noise filter resistor bypassed
    ENDBITFIELD
    BITFIELD   EN_LDO_LOBUFB
        POSITION=8
        DEFAULT=0
        MODE=RW
        #! Enables the LO buffer LDO
        #!     0 - LDO powered down  (default)
        #!     1 - LDO enabled
    ENDBITFIELD
    BITFIELD   RDIV_LOBUFB<7:0>
        POSITION=<7:0>
        DEFAULT=01100101
        MODE=RW
        #! Controls the output voltage of the LO buffer LDO by setting the resistive voltage divider ratio.
        #! Vout = 860 mV + 3.92 mV * RDIV
        #! Default : 01100101 (101) Vout = 1.25 V
    ENDBITFIELD
ENDREGISTER

REGISTER    LOBUFC_LDO_Config    0x0013
    BITFIELD   EN_LOADIMP_LDO_LOBUFC
        POSITION=10
        DEFAULT=0
        MODE=RW
        #! Enables the load dependent bias to optimize the load regulation
        #!     0 - Constant bias (default)
        #!     1 - Load dependant bias
    ENDBITFIELD
    BITFIELD   SPDUP_LDO_LOBUFC
        POSITION=9
        DEFAULT=0
        MODE=RW
        #! Short the noise filter resistor to speed up the settling time
        #!     0 - Noise filter resistor in place (default)
        #!     1 - Noise filter resistor bypassed
    ENDBITFIELD
    BITFIELD   EN_LDO_LOBUFC
        POSITION=8
        DEFAULT=0
        MODE=RW
        #! Enables the LO buffer LDO
        #!     0 - LDO powered down  (default)
        #!     1 - LDO enabled
    ENDBITFIELD
    BITFIELD   RDIV_LOBUFC<7:0>
        POSITION=<7:0>
        DEFAULT=01100101
        MODE=RW
        #! Controls the output voltage of the LO buffer LDO by setting the resistive voltage divider ratio.
        #! Vout = 860 mV + 3.92 mV * RDIV
        #! Default : 01100101 (101) Vout = 1.25 V
    ENDBITFIELD
ENDREGISTER

REGISTER    LOBUFD_LDO_Config    0x0014
    BITFIELD   EN_LOADIMP_LDO_LOBUFD
        POSITION=10
        DEFAULT=0
        MODE=RW
        #! Enables the load dependent bias to optimize the load regulation
        #!     0 - Constant bias (default)
        #!     1 - Load dependant bias
    ENDBITFIELD
    BITFIELD   SPDUP_LDO_LOBUFD
        POSITION=9
        DEFAULT=0
        MODE=RW
        #! Short the noise filter resistor to speed up the settling time
        #!     0 - Noise filter resistor in place (default)
        #!     1 - Noise filter resistor bypassed
    ENDBITFIELD
    BITFIELD   EN_LDO_LOBUFD
        POSITION=8
        DEFAULT=0
        MODE=RW
        #! Enables the LO buffer LDO
        #!     0 - LDO powered down  (default)
        #!     1 - LDO enabled
    ENDBITFIELD
    BITFIELD   RDIV_LOBUFD<7:0>
        POSITION=<7:0>
        DEFAULT=01100101
        MODE=RW
        #! Controls the output voltage of the LO buffer LDO by setting the resistive voltage divider ratio.
        #! Vout = 860 mV + 3.92 mV * RDIV
        #! Default : 01100101 (101) Vout = 1.25 V
    ENDBITFIELD
ENDREGISTER

REGISTER    HFLNAA_LDO_Config    0x0015
    BITFIELD   EN_LOADIMP_LDO_HFLNAA
        POSITION=10
        DEFAULT=0
        MODE=RW
        #! Enables the load dependent bias to optimize the load regulation
        #!     0 - Constant bias (default)
        #!     1 - Load dependant bias
    ENDBITFIELD
    BITFIELD   SPDUP_LDO_HFLNAA
        POSITION=9
        DEFAULT=0
        MODE=RW
        #! Short the noise filter resistor to speed up the settling time
        #!     0 - Noise filter resistor in place (default)
        #!     1 - Noise filter resistor bypassed
    ENDBITFIELD
    BITFIELD   EN_LDO_HFLNAA
        POSITION=8
        DEFAULT=0
        MODE=RW
        #! Enables the LO buffer LDO
        #!     0 - LDO powered down  (default)
        #!     1 - LDO enabled
    ENDBITFIELD
    BITFIELD   RDIV_HFLNAA<7:0>
        POSITION=<7:0>
        DEFAULT=01100101
        MODE=RW
        #! Controls the output voltage of the LO buffer LDO by setting the resistive voltage divider ratio.
        #! Vout = 860 mV + 3.92 mV * RDIV
        #! Default : 01100101 (101) Vout = 1.25 V
    ENDBITFIELD
ENDREGISTER

REGISTER    HFLNAB_LDO_Config    0x0016
    BITFIELD   EN_LOADIMP_LDO_HFLNAB
        POSITION=10
        DEFAULT=0
        MODE=RW
        #! Enables the load dependent bias to optimize the load regulation
        #!     0 - Constant bias (default)
        #!     1 - Load dependant bias
    ENDBITFIELD
    BITFIELD   SPDUP_LDO_HFLNAB
        POSITION=9
        DEFAULT=0
        MODE=RW
        #! Short the noise filter resistor to speed up the settling time
        #!     0 - Noise filter resistor in place (default)
        #!     1 - Noise filter resistor bypassed
    ENDBITFIELD
    BITFIELD   EN_LDO_HFLNAB
        POSITION=8
        DEFAULT=0
        MODE=RW
        #! Enables the LO buffer LDO
        #!     0 - LDO powered down  (default)
        #!     1 - LDO enabled
    ENDBITFIELD
    BITFIELD   RDIV_HFLNAB<7:0>
        POSITION=<7:0>
        DEFAULT=01100101
        MODE=RW
        #! Controls the output voltage of the LO buffer LDO by setting the resistive voltage divider ratio.
        #! Vout = 860 mV + 3.92 mV * RDIV
        #! Default : 01100101 (101) Vout = 1.25 V
    ENDBITFIELD
ENDREGISTER

REGISTER    HFLNAC_LDO_Config    0x0017
    BITFIELD   EN_LOADIMP_LDO_HFLNAC
        POSITION=10
        DEFAULT=0
        MODE=RW
        #! Enables the load dependent bias to optimize the load regulation
        #!     0 - Constant bias (default)
        #!     1 - Load dependant bias
    ENDBITFIELD
    BITFIELD   SPDUP_LDO_HFLNAC
        POSITION=9
        DEFAULT=0
        MODE=RW
        #! Short the noise filter resistor to speed up the settling time
        #!     0 - Noise filter resistor in place (default)
        #!     1 - Noise filter resistor bypassed
    ENDBITFIELD
    BITFIELD   EN_LDO_HFLNAC
        POSITION=8
        DEFAULT=0
        MODE=RW
        #! Enables the LO buffer LDO
        #!     0 - LDO powered down  (default)
        #!     1 - LDO enabled
    ENDBITFIELD
    BITFIELD   RDIV_HFLNAC<7:0>
        POSITION=<7:0>
        DEFAULT=01100101
        MODE=RW
        #! Controls the output voltage of the LO buffer LDO by setting the resistive voltage divider ratio.
        #! Vout = 860 mV + 3.92 mV * RDIV
        #! Default : 01100101 (101) Vout = 1.25 V
    ENDBITFIELD
ENDREGISTER

REGISTER    HFLNAD_LDO_Config    0x0018
    BITFIELD   EN_LOADIMP_LDO_HFLNAD
        POSITION=10
        DEFAULT=0
        MODE=RW
        #! Enables the load dependent bias to optimize the load regulation
        #!     0 - Constant bias (default)
        #!     1 - Load dependant bias
    ENDBITFIELD
    BITFIELD   SPDUP_LDO_HFLNAD
        POSITION=9
        DEFAULT=0
        MODE=RW
        #! Short the noise filter resistor to speed up the settling time
        #!     0 - Noise filter resistor in place (default)
        #!     1 - Noise filter resistor bypassed
    ENDBITFIELD
    BITFIELD   EN_LDO_HFLNAD
        POSITION=8
        DEFAULT=0
        MODE=RW
        #! Enables the LO buffer LDO
        #!     0 - LDO powered down  (default)
        #!     1 - LDO enabled
    ENDBITFIELD
    BITFIELD   RDIV_HFLNAD<7:0>
        POSITION=<7:0>
        DEFAULT=01100101
        MODE=RW
        #! Controls the output voltage of the LO buffer LDO by setting the resistive voltage divider ratio.
        #! Vout = 860 mV + 3.92 mV * RDIV
        #! Default : 01100101 (101) Vout = 1.25 V
    ENDBITFIELD
ENDREGISTER

REGISTER    CLK_BUF_LDO_Config    0x001A
    BITFIELD   EN_LOADIMP_LDO_CLK_BUF
        POSITION=10
        DEFAULT=0
        MODE=RW
        #! Enables the load dependent bias to optimize the load regulation
        #!     0 - Constant bias (default)
        #!     1 - Load dependant bias
    ENDBITFIELD
    BITFIELD   SPDUP_LDO_CLK_BUF
        POSITION=9
        DEFAULT=0
        MODE=RW
        #! Short the noise filter resistor to speed up the settling time
        #!     0 - Noise filter resistor in place (default)
        #!     1 - Noise filter resistor bypassed
    ENDBITFIELD
    BITFIELD   EN_LDO_CLK_BUF
        POSITION=8
        DEFAULT=0
        MODE=RW
        #! Enables the LO buffer LDO
        #!     0 - LDO powered down  (default)
        #!     1 - LDO enabled
    ENDBITFIELD
    BITFIELD   RDIV_CLK_BUF<7:0>
        POSITION=<7:0>
        DEFAULT=01100101
        MODE=RW
        #! Controls the output voltage of the LO buffer LDO by setting the resistive voltage divider ratio.
        #! Vout = 860 mV + 3.92 mV * RDIV
        #! Default : 01100101 (101) Vout = 1.25 V
    ENDBITFIELD
ENDREGISTER

REGISTER    PLL_DIV_LDO_Config    0x001B
    BITFIELD   EN_LOADIMP_LDO_PLL_DIV
        POSITION=10
        DEFAULT=0
        MODE=RW
        #! Enables the load dependent bias to optimize the load regulation
        #!     0 - Constant bias (default)
        #!     1 - Load dependant bias
    ENDBITFIELD
    BITFIELD   SPDUP_LDO_PLL_DIV
        POSITION=9
        DEFAULT=0
        MODE=RW
        #! Short the noise filter resistor to speed up the settling time
        #!     0 - Noise filter resistor in place (default)
        #!     1 - Noise filter resistor bypassed
    ENDBITFIELD
    BITFIELD   EN_LDO_PLL_DIV
        POSITION=8
        DEFAULT=0
        MODE=RW
        #! Enables the PLL divider LDO
        #!     0 - LDO powered down  (default)
        #!     1 - LDO enabled
    ENDBITFIELD
    BITFIELD   RDIV_PLL_DIV<7:0>
        POSITION=<7:0>
        DEFAULT=01100101
        MODE=RW
        #! Controls the output voltage of the PLL divider LDO by setting the resistive voltage divider ratio.
        #! Vout = 860 mV + 3.92 mV * RDIV
        #! Default : 01100101 (101) Vout = 1.25 V
    ENDBITFIELD
ENDREGISTER

REGISTER    PLL_CP_LDO_Config    0x001C
    BITFIELD   EN_LOADIMP_LDO_PLL_CP
        POSITION=10
        DEFAULT=0
        MODE=RW
        #! Enables the load dependent bias to optimize the load regulation
        #!     0 - Constant bias (default)
        #!     1 - Load dependant bias
    ENDBITFIELD
    BITFIELD   SPDUP_LDO_PLL_CP
        POSITION=9
        DEFAULT=0
        MODE=RW
        #! Short the noise filter resistor to speed up the settling time
        #!     0 - Noise filter resistor in place (default)
        #!     1 - Noise filter resistor bypassed
    ENDBITFIELD
    BITFIELD   EN_LDO_PLL_CP
        POSITION=8
        DEFAULT=0
        MODE=RW
        #! Enables the PLL CP LDO
        #!     0 - LDO powered down  (default)
        #!     1 - LDO enabled
    ENDBITFIELD
    BITFIELD   RDIV_PLL_CP<7:0>
        POSITION=<7:0>
        DEFAULT=01100101
        MODE=RW
        #! Controls the output voltage of the PLL CP LDO by setting the resistive voltage divider ratio.
        #! Vout = 860 mV + 3.92 mV * RDIV
        #! Default : 01100101 (101) Vout = 1.25 V
    ENDBITFIELD
ENDREGISTER

REGISTER    DIG_CORE_LDO_Config    0x001F
    BITFIELD   EN_LOADIMP_LDO_DIG_CORE
        POSITION=10
        DEFAULT=0
        MODE=RW
        #! Enables the load dependent bias to optimize the load regulation
        #!     0 - Constant bias (default)
        #!     1 - Load dependant bias
    ENDBITFIELD
    BITFIELD   SPDUP_LDO_DIG_CORE
        POSITION=9
        DEFAULT=0
        MODE=RW
        #! Short the noise filter resistor to speed up the settling time
        #!     0 - Noise filter resistor in place (default)
        #!     1 - Noise filter resistor bypassed
    ENDBITFIELD
    BITFIELD   PD_LDO_DIG_CORE
        POSITION=8
        DEFAULT=0
        MODE=RW
        #! Power down the digital core and IO ring pre-drivers LDO
        #!     0 - LDO on  (default)
        #!     1 - LDO powered down
    ENDBITFIELD
    BITFIELD   RDIV_DIG_CORE<7:0>
        POSITION=<7:0>
        DEFAULT=01100101
        MODE=RW
        #! Controls the output voltage of the digital core and IO ring pre-drivers LDO by setting the resistive voltage divider ratio.
        #! Vout = 860 mV + 3.92 mV * RDIV
        #! Default : 01100101 (101) Vout = 1.25 V
    ENDBITFIELD
ENDREGISTER

REGISTER    CHA_MIX_ICT    0x1000
    BITFIELD   CHA_MIXB_ICT<4:0>
        POSITION=<9:5>
        DEFAULT=10000
        MODE=RW
        #! Controls the bias current of polarization circuit
        #!     I = Inom * CHA_MIXB_ICT/16
        #!     Default : 16
    ENDBITFIELD
    BITFIELD   CHA_MIXA_ICT<4:0>
        POSITION=<4:0>
        DEFAULT=10000
        MODE=RW
        #! Controls the bias current of polarization circuit
        #!     I = Inom * CHA_MIXA_ICT/16
        #!     Default : 16
    ENDBITFIELD
ENDREGISTER

REGISTER    CHA_HFPAD_ICT    0x1001
    BITFIELD   CHA_PA_ILIN2X
        POSITION=10
        DEFAULT=0
        MODE=RW
        #! Double the linearization bias current
        #!     0 - Ilin * 1
        #!     1 - Ilin * 2
        #!     Default : 0
    ENDBITFIELD
    BITFIELD   CHA_PA_ICT_LIN<4:0>
        POSITION=<9:5>
        DEFAULT=10000
        MODE=RW
        #! Controls the bias current of linearization section of HFPAD
        #!     I = Inom * CHA_PA_ICT_LIN/16
        #!     Default : 16
    ENDBITFIELD
    BITFIELD   CHA_PA_ICT_MAIN<4:0>
        POSITION=<4:0>
        DEFAULT=10000
        MODE=RW
        #! Controls the bias current of main gm section of HFPAD
        #!     I = Inom * CHA_MIXA_ICT/16
        #!     Default : 16
    ENDBITFIELD
ENDREGISTER

REGISTER    CHA_PD0    0x1004
    BITFIELD   CHA_PA_R50_EN0
        POSITION=7
        DEFAULT=1
        MODE=RWI
        #! Controls the switch in series with 50 Ohm resistor to ground at HFPAD input.
        #!     0 - Switch is open
        #!     1 - Switch is closed
    ENDBITFIELD
    BITFIELD   CHA_PA_BYPASS0
        POSITION=6
        DEFAULT=0
        MODE=RWI
        #! Controls the HFPAD bypass switches.
        #!     0 - HFPAD in not bypassed
        #!     1 - HFPAD is bypassed
        #! Note : HFPAD must be manually disabled when bypassed.
    ENDBITFIELD
    BITFIELD   CHA_PA_PD0
        POSITION=5
        DEFAULT=1
        MODE=RWI
        #! Power down for HFPAD
        #!     0 - Enabled
        #!     1 - Powered down
    ENDBITFIELD
    BITFIELD   CHA_MIXB_LOBUFF_PD0
        POSITION=4
        DEFAULT=1
        MODE=RWI
        #! Power down for MIXB LO buffer
        #!     0 - Enabled
        #!     1 - Powered down
    ENDBITFIELD
    BITFIELD   CHA_MIXB_BIAS_PD0
        POSITION=3
        DEFAULT=1
        MODE=RWI
        #! Power down for MIXB bias
        #!     0 - Enabled
        #!     1 - Powered down
    ENDBITFIELD
    BITFIELD   CHA_MIXA_LOBUFF_PD0
        POSITION=2
        DEFAULT=1
        MODE=RWI
        #! Power down for MIXA LO buffer
        #!     0 - Enabled
        #!     1 - Powered down
    ENDBITFIELD
    BITFIELD   CHA_MIXA_BIAS_PD0
        POSITION=1
        DEFAULT=1
        MODE=RWI
        #! Power down for MIXA bias
        #!     0 - Enabled
        #!     1 - Powered down
    ENDBITFIELD
    BITFIELD   CHA_LNA_PD0
        POSITION=0
        DEFAULT=1
        MODE=RWI
        #! Power down for LNA
        #!     0 - Enabled
        #!     1 - Powered down
    ENDBITFIELD
ENDREGISTER

REGISTER    CHA_PD1    0x1005
    BITFIELD   CHA_PA_R50_EN1
        POSITION=7
        DEFAULT=1
        MODE=RWI
        #! Controls the switch in series with 50 Ohm resistor to ground at HFPAD input.
        #!     0 - Switch is open
        #!     1 - Switch is closed
    ENDBITFIELD
    BITFIELD   CHA_PA_BYPASS1
        POSITION=6
        DEFAULT=0
        MODE=RWI
        #! Controls the HFPAD bypass switches.
        #!     0 - HFPAD in not bypassed
        #!     1 - HFPAD is bypassed
        #! Note : HFPAD must be manually disabled when bypassed.
    ENDBITFIELD
    BITFIELD   CHA_PA_PD1
        POSITION=5
        DEFAULT=1
        MODE=RWI
        #! Power down for HFPAD
        #!     0 - Enabled
        #!     1 - Powered down
    ENDBITFIELD
    BITFIELD   CHA_MIXB_LOBUFF_PD1
        POSITION=4
        DEFAULT=1
        MODE=RWI
        #! Power down for MIXB LO buffer
        #!     0 - Enabled
        #!     1 - Powered down
    ENDBITFIELD
    BITFIELD   CHA_MIXB_BIAS_PD1
        POSITION=3
        DEFAULT=1
        MODE=RWI
        #! Power down for MIXB bias
        #!     0 - Enabled
        #!     1 - Powered down
    ENDBITFIELD
    BITFIELD   CHA_MIXA_LOBUFF_PD1
        POSITION=2
        DEFAULT=1
        MODE=RWI
        #! Power down for MIXA LO buffer
        #!     0 - Enabled
        #!     1 - Powered down
    ENDBITFIELD
    BITFIELD   CHA_MIXA_BIAS_PD1
        POSITION=1
        DEFAULT=1
        MODE=RWI
        #! Power down for MIXA bias
        #!     0 - Enabled
        #!     1 - Powered down
    ENDBITFIELD
    BITFIELD   CHA_LNA_PD1
        POSITION=0
        DEFAULT=1
        MODE=RWI
        #! Power down for LNA
        #!     0 - Enabled
        #!     1 - Powered down
    ENDBITFIELD
ENDREGISTER

REGISTER    CHA_PD2    0x1006
    BITFIELD   CHA_PA_R50_EN2
        POSITION=7
        DEFAULT=1
        MODE=RWI
        #! Controls the switch in series with 50 Ohm resistor to ground at HFPAD input.
        #!     0 - Switch is open
        #!     1 - Switch is closed
    ENDBITFIELD
    BITFIELD   CHA_PA_BYPASS2
        POSITION=6
        DEFAULT=0
        MODE=RWI
        #! Controls the HFPAD bypass switches.
        #!     0 - HFPAD in not bypassed
        #!     1 - HFPAD is bypassed
        #! Note : HFPAD must be manually disabled when bypassed.
    ENDBITFIELD
    BITFIELD   CHA_PA_PD2
        POSITION=5
        DEFAULT=1
        MODE=RWI
        #! Power down for HFPAD
        #!     0 - Enabled
        #!     1 - Powered down
    ENDBITFIELD
    BITFIELD   CHA_MIXB_LOBUFF_PD2
        POSITION=4
        DEFAULT=1
        MODE=RWI
        #! Power down for MIXB LO buffer
        #!     0 - Enabled
        #!     1 - Powered down
    ENDBITFIELD
    BITFIELD   CHA_MIXB_BIAS_PD2
        POSITION=3
        DEFAULT=1
        MODE=RWI
        #! Power down for MIXB bias
        #!     0 - Enabled
        #!     1 - Powered down
    ENDBITFIELD
    BITFIELD   CHA_MIXA_LOBUFF_PD2
        POSITION=2
        DEFAULT=1
        MODE=RWI
        #! Power down for MIXA LO buffer
        #!     0 - Enabled
        #!     1 - Powered down
    ENDBITFIELD
    BITFIELD   CHA_MIXA_BIAS_PD2
        POSITION=1
        DEFAULT=1
        MODE=RWI
        #! Power down for MIXA bias
        #!     0 - Enabled
        #!     1 - Powered down
    ENDBITFIELD
    BITFIELD   CHA_LNA_PD2
        POSITION=0
        DEFAULT=1
        MODE=RWI
        #! Power down for LNA
        #!     0 - Enabled
        #!     1 - Powered down
    ENDBITFIELD
ENDREGISTER

REGISTER    CHA_PD3    0x1007
    BITFIELD   CHA_PA_R50_EN3
        POSITION=7
        DEFAULT=1
        MODE=RWI
        #! Controls the switch in series with 50 Ohm resistor to ground at HFPAD input.
        #!     0 - Switch is open
        #!     1 - Switch is closed
    ENDBITFIELD
    BITFIELD   CHA_PA_BYPASS3
        POSITION=6
        DEFAULT=0
        MODE=RWI
        #! Controls the HFPAD bypass switches.
        #!     0 - HFPAD in not bypassed
        #!     1 - HFPAD is bypassed
        #! Note : HFPAD must be manually disabled when bypassed.
    ENDBITFIELD
    BITFIELD   CHA_PA_PD3
        POSITION=5
        DEFAULT=1
        MODE=RWI
        #! Power down for HFPAD
        #!     0 - Enabled
        #!     1 - Powered down
    ENDBITFIELD
    BITFIELD   CHA_MIXB_LOBUFF_PD3
        POSITION=4
        DEFAULT=1
        MODE=RWI
        #! Power down for MIXB LO buffer
        #!     0 - Enabled
        #!     1 - Powered down
    ENDBITFIELD
    BITFIELD   CHA_MIXB_BIAS_PD3
        POSITION=3
        DEFAULT=1
        MODE=RWI
        #! Power down for MIXB bias
        #!     0 - Enabled
        #!     1 - Powered down
    ENDBITFIELD
    BITFIELD   CHA_MIXA_LOBUFF_PD3
        POSITION=2
        DEFAULT=1
        MODE=RWI
        #! Power down for MIXA LO buffer
        #!     0 - Enabled
        #!     1 - Powered down
    ENDBITFIELD
    BITFIELD   CHA_MIXA_BIAS_PD3
        POSITION=1
        DEFAULT=1
        MODE=RWI
        #! Power down for MIXA bias
        #!     0 - Enabled
        #!     1 - Powered down
    ENDBITFIELD
    BITFIELD   CHA_LNA_PD3
        POSITION=0
        DEFAULT=1
        MODE=RWI
        #! Power down for LNA
        #!     0 - Enabled
        #!     1 - Powered down
    ENDBITFIELD
ENDREGISTER

REGISTER    CHA_LNA_CTRL0    0x1008
    BITFIELD   CHA_LNA_ICT_LIN0<4:0>
        POSITION=<15:11>
        DEFAULT=10000
        MODE=RWI
        #! Controls the bias current of linearization section of LNA
        #!     I = Inom * CHA_LNA_ICT_LIN/16
        #!     Default : 16
    ENDBITFIELD
    BITFIELD   CHA_LNA_ICT_MAIN0<4:0>
        POSITION=<10:6>
        DEFAULT=10000
        MODE=RWI
        #! Controls the bias current of main gm section of LNA
        #!     I = Inom * CHA_LNA_ICT_MAIN/16
        #!     Default : 16
    ENDBITFIELD
    BITFIELD   CHA_LNA_CGSCTRL0<1:0>
        POSITION=<5:4>
        DEFAULT=10
        MODE=RWI
    ENDBITFIELD
    BITFIELD   CHA_LNA_GCTRL0<3:0>
        POSITION=<3:0>
        DEFAULT=1000
        MODE=RWI
    ENDBITFIELD
ENDREGISTER

REGISTER    CHA_LNA_CTRL1    0x1009
    BITFIELD   CHA_LNA_ICT_LIN1<4:0>
        POSITION=<15:11>
        DEFAULT=10000
        MODE=RWI
        #! Controls the bias current of linearization section of LNA
        #!     I = Inom * CHA_LNA_ICT_LIN/16
        #!     Default : 16
    ENDBITFIELD
    BITFIELD   CHA_LNA_ICT_MAIN1<4:0>
        POSITION=<10:6>
        DEFAULT=10000
        MODE=RWI
        #! Controls the bias current of main gm section of LNA
        #!     I = Inom * CHA_LNA_ICT_MAIN/16
        #!     Default : 16
    ENDBITFIELD
    BITFIELD   CHA_LNA_CGSCTRL1<1:0>
        POSITION=<5:4>
        DEFAULT=10
        MODE=RWI
    ENDBITFIELD
    BITFIELD   CHA_LNA_GCTRL1<3:0>
        POSITION=<3:0>
        DEFAULT=1000
        MODE=RWI
    ENDBITFIELD
ENDREGISTER

REGISTER    CHA_LNA_CTRL2    0x100A
    BITFIELD   CHA_LNA_ICT_LIN2<4:0>
        POSITION=<15:11>
        DEFAULT=10000
        MODE=RWI
        #! Controls the bias current of linearization section of LNA
        #!     I = Inom * CHA_LNA_ICT_LIN/16
        #!     Default : 16
    ENDBITFIELD
    BITFIELD   CHA_LNA_ICT_MAIN2<4:0>
        POSITION=<10:6>
        DEFAULT=10000
        MODE=RWI
        #! Controls the bias current of main gm section of LNA
        #!     I = Inom * CHA_LNA_ICT_MAIN/16
        #!     Default : 16
    ENDBITFIELD
    BITFIELD   CHA_LNA_CGSCTRL2<1:0>
        POSITION=<5:4>
        DEFAULT=10
        MODE=RWI
    ENDBITFIELD
    BITFIELD   CHA_LNA_GCTRL2<3:0>
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
        DEFAULT=1
        MODE=RWI
    ENDBITFIELD
    BITFIELD   CHA_LNA_SEL1_INVERT
        POSITION=10
        DEFAULT=0
        MODE=RWI
    ENDBITFIELD
    BITFIELD   CHA_LNA_SEL1_MASK<8:0>
        POSITION=<8:0>
        DEFAULT=000000000
        MODE=RWI
    ENDBITFIELD
ENDREGISTER

REGISTER    CHA_PA_SEL0    0x1014
    BITFIELD   CHA_PA_SEL0_INTERNAL
        POSITION=11
        DEFAULT=1
        MODE=RWI
    ENDBITFIELD
    BITFIELD   CHA_PA_SEL0_INVERT
        POSITION=10
        DEFAULT=0
        MODE=RWI
    ENDBITFIELD
    BITFIELD   CHA_PA_SEL0_MASK<8:0>
        POSITION=<8:0>
        DEFAULT=000000000
        MODE=RWI
    ENDBITFIELD
ENDREGISTER

REGISTER    CHA_PA_SEL1    0x1015
    BITFIELD   CHA_PA_SEL1_INTERNAL
        POSITION=11
        DEFAULT=1
        MODE=RWI
    ENDBITFIELD
    BITFIELD   CHA_PA_SEL1_INVERT
        POSITION=10
        DEFAULT=0
        MODE=RWI
    ENDBITFIELD
    BITFIELD   CHA_PA_SEL1_MASK<8:0>
        POSITION=<8:0>
        DEFAULT=000000000
        MODE=RWI
    ENDBITFIELD
ENDREGISTER

REGISTER    CHA_INT_SEL    0x1016
    BITFIELD   CHA_PA_INT_SEL<1:0>
        POSITION=<5:4>
        DEFAULT=00
        MODE=RWI
    ENDBITFIELD
    BITFIELD   CHA_LNA_INT_SEL<1:0>
        POSITION=<3:2>
        DEFAULT=00
        MODE=RWI
    ENDBITFIELD
    BITFIELD   CHA_PD_INT_SEL<1:0>
        POSITION=<1:0>
        DEFAULT=00
        MODE=RWI
    ENDBITFIELD
ENDREGISTER

REGISTER    CHA_PD_RB    0x101D
    BITFIELD   CHA_PA_R50_EN_RB
        POSITION=7
        DEFAULT=CHA_PA_R50_EN0
        MODE=RB
        #! Readback the actual controlling value
    ENDBITFIELD
    BITFIELD   CHA_PA_BYPASS_RB
        POSITION=6
        DEFAULT=CHA_PA_BYPASS
        MODE=RB
        #! Readback the actual controlling value
    ENDBITFIELD
    BITFIELD   CHA_PA_PD_RB
        POSITION=5
        DEFAULT=CHA_PA_PD
        MODE=RB
        #! Readback the actual controlling value
    ENDBITFIELD
    BITFIELD   CHA_MIXB_LOBUFF_PD_RB
        POSITION=4
        DEFAULT=CHA_MIXB_LOBUFF_PD
        MODE=RB
        #! Readback the actual controlling value
    ENDBITFIELD
    BITFIELD   CHA_MIXB_BIAS_PD_RB
        POSITION=3
        DEFAULT=CHA_MIXB_BIAS_PD
        MODE=RB
        #! Readback the actual controlling value
    ENDBITFIELD
    BITFIELD   CHA_MIXA_LOBUFF_PD_RB
        POSITION=2
        DEFAULT=CHA_MIXA_LOBUFF_PD
        MODE=RB
        #! Readback the actual controlling value
    ENDBITFIELD
    BITFIELD   CHA_MIXA_BIAS_PD_RB
        POSITION=1
        DEFAULT=CHA_MIXA_BIAS_PD
        MODE=RB
        #! Readback the actual controlling value
    ENDBITFIELD
    BITFIELD   CHA_LNA_PD_RB
        POSITION=0
        DEFAULT=CHA_LNA_PD
        MODE=RB
        #! Readback the actual controlling value
    ENDBITFIELD
ENDREGISTER

REGISTER    CHA_LNA_CTRL_RB    0x101E
    BITFIELD   CHA_LNA_ICT_LIN_RB<4:0>
        POSITION=<15:11>
        DEFAULT=CHA_LNA_ICT_LIN<4:0>
        MODE=RB
        #! Readback the actual controlling value
    ENDBITFIELD
    BITFIELD   CHA_LNA_ICT_MAIN_RB<4:0>
        POSITION=<10:6>
        DEFAULT=CHA_LNA_ICT_MAIN<4:0>
        MODE=RB
        #! Readback the actual controlling value
    ENDBITFIELD
    BITFIELD   CHA_LNA_CGSCTRL_RB<1:0>
        POSITION=<5:4>
        DEFAULT=CHA_LNA_CGSCTRL<1:0>
        MODE=RB
        #! Readback the actual controlling value
    ENDBITFIELD
    BITFIELD   CHA_LNA_GCTRL_RB<3:0>
        POSITION=<3:0>
        DEFAULT=CHA_LNA_GCTRL<3:0>
        MODE=RB
        #! Readback the actual controlling value
    ENDBITFIELD
ENDREGISTER

REGISTER    CHA_PA_CTRL_RB    0x101F
    BITFIELD   CHA_PA_LIN_LOSS_RB<3:0>
        POSITION=<7:4>
        DEFAULT=CHA_PA_LIN_LOSS<3:0>
        MODE=RB
        #! Readback the actual controlling value
    ENDBITFIELD
    BITFIELD   CHA_PA_MAIN_LOSS_RB<3:0>
        POSITION=<3:0>
        DEFAULT=CHA_PA_MAIN_LOSS<3:0>
        MODE=RB
        #! Readback the actual controlling value
    ENDBITFIELD
ENDREGISTER

REGISTER    CHB_MIX_ICT    0x1020
    BITFIELD   CHB_MIXB_ICT<4:0>
        POSITION=<9:5>
        DEFAULT=10000
        MODE=RW
        #! Controls the bias current of polarization circuit
        #!     I = Inom * CHB_MIXB_ICT/16
        #!     Default : 16
    ENDBITFIELD
    BITFIELD   CHB_MIXA_ICT<4:0>
        POSITION=<4:0>
        DEFAULT=10000
        MODE=RW
        #! Controls the bias current of polarization circuit
        #!     I = Inom * CHB_MIXA_ICT/16
        #!     Default : 16
    ENDBITFIELD
ENDREGISTER

REGISTER    CHB_HFPAD_ICT    0x1021
    BITFIELD   CHB_PA_ILIN2X
        POSITION=10
        DEFAULT=0
        MODE=RW
        #! Double the linearization bias current
        #!     0 - Ilin * 1
        #!     1 - Ilin * 2
        #!     Default : 0
    ENDBITFIELD
    BITFIELD   CHB_PA_ICT_LIN<4:0>
        POSITION=<9:5>
        DEFAULT=10000
        MODE=RW
        #! Controls the bias current of linearization section of HFPAD
        #!     I = Inom * CHB_PA_ICT_LIN/16
        #!     Default : 16
    ENDBITFIELD
    BITFIELD   CHB_PA_ICT_MAIN<4:0>
        POSITION=<4:0>
        DEFAULT=10000
        MODE=RW
        #! Controls the bias current of main gm section of HFPAD
        #!     I = Inom * CHB_MIXA_ICT/16
        #!     Default : 16
    ENDBITFIELD
ENDREGISTER

REGISTER    CHB_PD0    0x1024
    BITFIELD   CHB_PA_R50_EN0
        POSITION=7
        DEFAULT=1
        MODE=RWI
        #! Controls the switch in series with 50 Ohm resistor to ground at HFPAD input.
        #!     0 - Switch is open
        #!     1 - Switch is closed
    ENDBITFIELD
    BITFIELD   CHB_PA_BYPASS0
        POSITION=6
        DEFAULT=0
        MODE=RWI
        #! Controls the HFPAD bypass switches.
        #!     0 - HFPAD in not bypassed
        #!     1 - HFPAD is bypassed
        #! Note : HFPAD must be manually disabled when bypassed.
    ENDBITFIELD
    BITFIELD   CHB_PA_PD0
        POSITION=5
        DEFAULT=1
        MODE=RWI
        #! Power down for HFPAD
        #!     0 - Enabled
        #!     1 - Powered down
    ENDBITFIELD
    BITFIELD   CHB_MIXB_LOBUFF_PD0
        POSITION=4
        DEFAULT=1
        MODE=RWI
        #! Power down for MIXB LO buffer
        #!     0 - Enabled
        #!     1 - Powered down
    ENDBITFIELD
    BITFIELD   CHB_MIXB_BIAS_PD0
        POSITION=3
        DEFAULT=1
        MODE=RWI
        #! Power down for MIXB bias
        #!     0 - Enabled
        #!     1 - Powered down
    ENDBITFIELD
    BITFIELD   CHB_MIXA_LOBUFF_PD0
        POSITION=2
        DEFAULT=1
        MODE=RWI
        #! Power down for MIXA LO buffer
        #!     0 - Enabled
        #!     1 - Powered down
    ENDBITFIELD
    BITFIELD   CHB_MIXA_BIAS_PD0
        POSITION=1
        DEFAULT=1
        MODE=RWI
        #! Power down for MIXA bias
        #!     0 - Enabled
        #!     1 - Powered down
    ENDBITFIELD
    BITFIELD   CHB_LNA_PD0
        POSITION=0
        DEFAULT=1
        MODE=RWI
        #! Power down for LNA
        #!     0 - Enabled
        #!     1 - Powered down
    ENDBITFIELD
ENDREGISTER

REGISTER    CHB_PD1    0x1025
    BITFIELD   CHB_PA_R50_EN1
        POSITION=7
        DEFAULT=1
        MODE=RWI
        #! Controls the switch in series with 50 Ohm resistor to ground at HFPAD input.
        #!     0 - Switch is open
        #!     1 - Switch is closed
    ENDBITFIELD
    BITFIELD   CHB_PA_BYPASS1
        POSITION=6
        DEFAULT=0
        MODE=RWI
        #! Controls the HFPAD bypass switches.
        #!     0 - HFPAD in not bypassed
        #!     1 - HFPAD is bypassed
        #! Note : HFPAD must be manually disabled when bypassed.
    ENDBITFIELD
    BITFIELD   CHB_PA_PD1
        POSITION=5
        DEFAULT=1
        MODE=RWI
        #! Power down for HFPAD
        #!     0 - Enabled
        #!     1 - Powered down
    ENDBITFIELD
    BITFIELD   CHB_MIXB_LOBUFF_PD1
        POSITION=4
        DEFAULT=1
        MODE=RWI
        #! Power down for MIXB LO buffer
        #!     0 - Enabled
        #!     1 - Powered down
    ENDBITFIELD
    BITFIELD   CHB_MIXB_BIAS_PD1
        POSITION=3
        DEFAULT=1
        MODE=RWI
        #! Power down for MIXB bias
        #!     0 - Enabled
        #!     1 - Powered down
    ENDBITFIELD
    BITFIELD   CHB_MIXA_LOBUFF_PD1
        POSITION=2
        DEFAULT=1
        MODE=RWI
        #! Power down for MIXA LO buffer
        #!     0 - Enabled
        #!     1 - Powered down
    ENDBITFIELD
    BITFIELD   CHB_MIXA_BIAS_PD1
        POSITION=1
        DEFAULT=1
        MODE=RWI
        #! Power down for MIXA bias
        #!     0 - Enabled
        #!     1 - Powered down
    ENDBITFIELD
    BITFIELD   CHB_LNA_PD1
        POSITION=0
        DEFAULT=1
        MODE=RWI
        #! Power down for LNA
        #!     0 - Enabled
        #!     1 - Powered down
    ENDBITFIELD
ENDREGISTER

REGISTER    CHB_PD2    0x1026
    BITFIELD   CHB_PA_R50_EN2
        POSITION=7
        DEFAULT=1
        MODE=RWI
        #! Controls the switch in series with 50 Ohm resistor to ground at HFPAD input.
        #!     0 - Switch is open
        #!     1 - Switch is closed
    ENDBITFIELD
    BITFIELD   CHB_PA_BYPASS2
        POSITION=6
        DEFAULT=0
        MODE=RWI
        #! Controls the HFPAD bypass switches.
        #!     0 - HFPAD in not bypassed
        #!     1 - HFPAD is bypassed
        #! Note : HFPAD must be manually disabled when bypassed.
    ENDBITFIELD
    BITFIELD   CHB_PA_PD2
        POSITION=5
        DEFAULT=1
        MODE=RWI
        #! Power down for HFPAD
        #!     0 - Enabled
        #!     1 - Powered down
    ENDBITFIELD
    BITFIELD   CHB_MIXB_LOBUFF_PD2
        POSITION=4
        DEFAULT=1
        MODE=RWI
        #! Power down for MIXB LO buffer
        #!     0 - Enabled
        #!     1 - Powered down
    ENDBITFIELD
    BITFIELD   CHB_MIXB_BIAS_PD2
        POSITION=3
        DEFAULT=1
        MODE=RWI
        #! Power down for MIXB bias
        #!     0 - Enabled
        #!     1 - Powered down
    ENDBITFIELD
    BITFIELD   CHB_MIXA_LOBUFF_PD2
        POSITION=2
        DEFAULT=1
        MODE=RWI
        #! Power down for MIXA LO buffer
        #!     0 - Enabled
        #!     1 - Powered down
    ENDBITFIELD
    BITFIELD   CHB_MIXA_BIAS_PD2
        POSITION=1
        DEFAULT=1
        MODE=RWI
        #! Power down for MIXA bias
        #!     0 - Enabled
        #!     1 - Powered down
    ENDBITFIELD
    BITFIELD   CHB_LNA_PD2
        POSITION=0
        DEFAULT=1
        MODE=RWI
        #! Power down for LNA
        #!     0 - Enabled
        #!     1 - Powered down
    ENDBITFIELD
ENDREGISTER

REGISTER    CHB_PD3    0x1027
    BITFIELD   CHB_PA_R50_EN3
        POSITION=7
        DEFAULT=1
        MODE=RWI
        #! Controls the switch in series with 50 Ohm resistor to ground at HFPAD input.
        #!     0 - Switch is open
        #!     1 - Switch is closed
    ENDBITFIELD
    BITFIELD   CHB_PA_BYPASS3
        POSITION=6
        DEFAULT=0
        MODE=RWI
        #! Controls the HFPAD bypass switches.
        #!     0 - HFPAD in not bypassed
        #!     1 - HFPAD is bypassed
        #! Note : HFPAD must be manually disabled when bypassed.
    ENDBITFIELD
    BITFIELD   CHB_PA_PD3
        POSITION=5
        DEFAULT=1
        MODE=RWI
        #! Power down for HFPAD
        #!     0 - Enabled
        #!     1 - Powered down
    ENDBITFIELD
    BITFIELD   CHB_MIXB_LOBUFF_PD3
        POSITION=4
        DEFAULT=1
        MODE=RWI
        #! Power down for MIXB LO buffer
        #!     0 - Enabled
        #!     1 - Powered down
    ENDBITFIELD
    BITFIELD   CHB_MIXB_BIAS_PD3
        POSITION=3
        DEFAULT=1
        MODE=RWI
        #! Power down for MIXB bias
        #!     0 - Enabled
        #!     1 - Powered down
    ENDBITFIELD
    BITFIELD   CHB_MIXA_LOBUFF_PD3
        POSITION=2
        DEFAULT=1
        MODE=RWI
        #! Power down for MIXA LO buffer
        #!     0 - Enabled
        #!     1 - Powered down
    ENDBITFIELD
    BITFIELD   CHB_MIXA_BIAS_PD3
        POSITION=1
        DEFAULT=1
        MODE=RWI
        #! Power down for MIXA bias
        #!     0 - Enabled
        #!     1 - Powered down
    ENDBITFIELD
    BITFIELD   CHB_LNA_PD3
        POSITION=0
        DEFAULT=1
        MODE=RWI
        #! Power down for LNA
        #!     0 - Enabled
        #!     1 - Powered down
    ENDBITFIELD
ENDREGISTER

REGISTER    CHB_LNA_CTRL0    0x1028
    BITFIELD   CHB_LNA_ICT_LIN0<4:0>
        POSITION=<15:11>
        DEFAULT=10000
        MODE=RWI
        #! Controls the bias current of linearization section of LNA
        #!     I = Inom * CHB_LNA_ICT_LIN/16
        #!     Default : 16
    ENDBITFIELD
    BITFIELD   CHB_LNA_ICT_MAIN0<4:0>
        POSITION=<10:6>
        DEFAULT=10000
        MODE=RWI
        #! Controls the bias current of main gm section of LNA
        #!     I = Inom * CHB_LNA_ICT_MAIN/16
        #!     Default : 16
    ENDBITFIELD
    BITFIELD   CHB_LNA_CGSCTRL0<1:0>
        POSITION=<5:4>
        DEFAULT=10
        MODE=RWI
    ENDBITFIELD
    BITFIELD   CHB_LNA_GCTRL0<3:0>
        POSITION=<3:0>
        DEFAULT=1000
        MODE=RWI
    ENDBITFIELD
ENDREGISTER

REGISTER    CHB_LNA_CTRL1    0x1029
    BITFIELD   CHB_LNA_ICT_LIN1<4:0>
        POSITION=<15:11>
        DEFAULT=10000
        MODE=RWI
        #! Controls the bias current of linearization section of LNA
        #!     I = Inom * CHB_LNA_ICT_LIN/16
        #!     Default : 16
    ENDBITFIELD
    BITFIELD   CHB_LNA_ICT_MAIN1<4:0>
        POSITION=<10:6>
        DEFAULT=10000
        MODE=RWI
        #! Controls the bias current of main gm section of LNA
        #!     I = Inom * CHB_LNA_ICT_MAIN/16
        #!     Default : 16
    ENDBITFIELD
    BITFIELD   CHB_LNA_CGSCTRL1<1:0>
        POSITION=<5:4>
        DEFAULT=10
        MODE=RWI
    ENDBITFIELD
    BITFIELD   CHB_LNA_GCTRL1<3:0>
        POSITION=<3:0>
        DEFAULT=1000
        MODE=RWI
    ENDBITFIELD
ENDREGISTER

REGISTER    CHB_LNA_CTRL2    0x102A
    BITFIELD   CHB_LNA_ICT_LIN2<4:0>
        POSITION=<15:11>
        DEFAULT=10000
        MODE=RWI
        #! Controls the bias current of linearization section of LNA
        #!     I = Inom * CHB_LNA_ICT_LIN/16
        #!     Default : 16
    ENDBITFIELD
    BITFIELD   CHB_LNA_ICT_MAIN2<4:0>
        POSITION=<10:6>
        DEFAULT=10000
        MODE=RWI
        #! Controls the bias current of main gm section of LNA
        #!     I = Inom * CHB_LNA_ICT_MAIN/16
        #!     Default : 16
    ENDBITFIELD
    BITFIELD   CHB_LNA_CGSCTRL2<1:0>
        POSITION=<5:4>
        DEFAULT=10
        MODE=RWI
    ENDBITFIELD
    BITFIELD   CHB_LNA_GCTRL2<3:0>
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
        DEFAULT=1
        MODE=RWI
    ENDBITFIELD
    BITFIELD   CHB_LNA_SEL1_INVERT
        POSITION=10
        DEFAULT=0
        MODE=RWI
    ENDBITFIELD
    BITFIELD   CHB_LNA_SEL1_MASK<8:0>
        POSITION=<8:0>
        DEFAULT=000000000
        MODE=RWI
    ENDBITFIELD
ENDREGISTER

REGISTER    CHB_PA_SEL0    0x1034
    BITFIELD   CHB_PA_SEL0_INTERNAL
        POSITION=11
        DEFAULT=1
        MODE=RWI
    ENDBITFIELD
    BITFIELD   CHB_PA_SEL0_INVERT
        POSITION=10
        DEFAULT=0
        MODE=RWI
    ENDBITFIELD
    BITFIELD   CHB_PA_SEL0_MASK<8:0>
        POSITION=<8:0>
        DEFAULT=000000000
        MODE=RWI
    ENDBITFIELD
ENDREGISTER

REGISTER    CHB_PA_SEL1    0x1035
    BITFIELD   CHB_PA_SEL1_INTERNAL
        POSITION=11
        DEFAULT=1
        MODE=RWI
    ENDBITFIELD
    BITFIELD   CHB_PA_SEL1_INVERT
        POSITION=10
        DEFAULT=0
        MODE=RWI
    ENDBITFIELD
    BITFIELD   CHB_PA_SEL1_MASK<8:0>
        POSITION=<8:0>
        DEFAULT=000000000
        MODE=RWI
    ENDBITFIELD
ENDREGISTER

REGISTER    CHB_INT_SEL    0x1036
    BITFIELD   CHB_PA_INT_SEL<1:0>
        POSITION=<5:4>
        DEFAULT=00
        MODE=RWI
    ENDBITFIELD
    BITFIELD   CHB_LNA_INT_SEL<1:0>
        POSITION=<3:2>
        DEFAULT=00
        MODE=RWI
    ENDBITFIELD
    BITFIELD   CHB_PD_INT_SEL<1:0>
        POSITION=<1:0>
        DEFAULT=00
        MODE=RWI
    ENDBITFIELD
ENDREGISTER

REGISTER    CHB_PD_RB    0x103D
    BITFIELD   CHB_PA_R50_EN_RB
        POSITION=7
        DEFAULT=CHB_PA_R50_EN0
        MODE=RB
        #! Readback the actual controlling value
    ENDBITFIELD
    BITFIELD   CHB_PA_BYPASS_RB
        POSITION=6
        DEFAULT=CHB_PA_BYPASS
        MODE=RB
        #! Readback the actual controlling value
    ENDBITFIELD
    BITFIELD   CHB_PA_PD_RB
        POSITION=5
        DEFAULT=CHB_PA_PD
        MODE=RB
        #! Readback the actual controlling value
    ENDBITFIELD
    BITFIELD   CHB_MIXB_LOBUFF_PD_RB
        POSITION=4
        DEFAULT=CHB_MIXB_LOBUFF_PD
        MODE=RB
        #! Readback the actual controlling value
    ENDBITFIELD
    BITFIELD   CHB_MIXB_BIAS_PD_RB
        POSITION=3
        DEFAULT=CHB_MIXB_BIAS_PD
        MODE=RB
        #! Readback the actual controlling value
    ENDBITFIELD
    BITFIELD   CHB_MIXA_LOBUFF_PD_RB
        POSITION=2
        DEFAULT=CHB_MIXA_LOBUFF_PD
        MODE=RB
        #! Readback the actual controlling value
    ENDBITFIELD
    BITFIELD   CHB_MIXA_BIAS_PD_RB
        POSITION=1
        DEFAULT=CHB_MIXA_BIAS_PD
        MODE=RB
        #! Readback the actual controlling value
    ENDBITFIELD
    BITFIELD   CHB_LNA_PD_RB
        POSITION=0
        DEFAULT=CHB_LNA_PD
        MODE=RB
        #! Readback the actual controlling value
    ENDBITFIELD
ENDREGISTER

REGISTER    CHB_LNA_CTRL_RB    0x103E
    BITFIELD   CHB_LNA_ICT_LIN_RB<4:0>
        POSITION=<15:11>
        DEFAULT=CHB_LNA_ICT_LIN<4:0>
        MODE=RB
        #! Readback the actual controlling value
    ENDBITFIELD
    BITFIELD   CHB_LNA_ICT_MAIN_RB<4:0>
        POSITION=<10:6>
        DEFAULT=CHB_LNA_ICT_MAIN<4:0>
        MODE=RB
        #! Readback the actual controlling value
    ENDBITFIELD
    BITFIELD   CHB_LNA_CGSCTRL_RB<1:0>
        POSITION=<5:4>
        DEFAULT=CHB_LNA_CGSCTRL<1:0>
        MODE=RB
        #! Readback the actual controlling value
    ENDBITFIELD
    BITFIELD   CHB_LNA_GCTRL_RB<3:0>
        POSITION=<3:0>
        DEFAULT=CHB_LNA_GCTRL<3:0>
        MODE=RB
        #! Readback the actual controlling value
    ENDBITFIELD
ENDREGISTER

REGISTER    CHB_PA_CTRL_RB    0x103F
    BITFIELD   CHB_PA_LIN_LOSS_RB<3:0>
        POSITION=<7:4>
        DEFAULT=CHB_PA_LIN_LOSS<3:0>
        MODE=RB
        #! Readback the actual controlling value
    ENDBITFIELD
    BITFIELD   CHB_PA_MAIN_LOSS_RB<3:0>
        POSITION=<3:0>
        DEFAULT=CHB_PA_MAIN_LOSS<3:0>
        MODE=RB
        #! Readback the actual controlling value
    ENDBITFIELD
ENDREGISTER

REGISTER    CHC_MIX_ICT    0x1040
    BITFIELD   CHC_MIXB_ICT<4:0>
        POSITION=<9:5>
        DEFAULT=10000
        MODE=RW
        #! Controls the bias current of polarization circuit
        #!     I = Inom * CHC_MIXB_ICT/16
        #!     Default : 16
    ENDBITFIELD
    BITFIELD   CHC_MIXA_ICT<4:0>
        POSITION=<4:0>
        DEFAULT=10000
        MODE=RW
        #! Controls the bias current of polarization circuit
        #!     I = Inom * CHC_MIXA_ICT/16
        #!     Default : 16
    ENDBITFIELD
ENDREGISTER

REGISTER    CHC_HFPAD_ICT    0x1041
    BITFIELD   CHC_PA_ILIN2X
        POSITION=10
        DEFAULT=0
        MODE=RW
        #! Double the linearization bias current
        #!     0 - Ilin * 1
        #!     1 - Ilin * 2
        #!     Default : 0
    ENDBITFIELD
    BITFIELD   CHC_PA_ICT_LIN<4:0>
        POSITION=<9:5>
        DEFAULT=10000
        MODE=RW
        #! Controls the bias current of linearization section of HFPAD
        #!     I = Inom * CHC_PA_ICT_LIN/16
        #!     Default : 16
    ENDBITFIELD
    BITFIELD   CHC_PA_ICT_MAIN<4:0>
        POSITION=<4:0>
        DEFAULT=10000
        MODE=RW
        #! Controls the bias current of main gm section of HFPAD
        #!     I = Inom * CHC_MIXA_ICT/16
        #!     Default : 16
    ENDBITFIELD
ENDREGISTER

REGISTER    CHC_PD0    0x1044
    BITFIELD   CHC_PA_R50_EN0
        POSITION=7
        DEFAULT=1
        MODE=RWI
        #! Controls the switch in series with 50 Ohm resistor to ground at HFPAD input.
        #!     0 - Switch is open
        #!     1 - Switch is closed
    ENDBITFIELD
    BITFIELD   CHC_PA_BYPASS0
        POSITION=6
        DEFAULT=0
        MODE=RWI
        #! Controls the HFPAD bypass switches.
        #!     0 - HFPAD in not bypassed
        #!     1 - HFPAD is bypassed
        #! Note : HFPAD must be manually disabled when bypassed.
    ENDBITFIELD
    BITFIELD   CHC_PA_PD0
        POSITION=5
        DEFAULT=1
        MODE=RWI
        #! Power down for HFPAD
        #!     0 - Enabled
        #!     1 - Powered down
    ENDBITFIELD
    BITFIELD   CHC_MIXB_LOBUFF_PD0
        POSITION=4
        DEFAULT=1
        MODE=RWI
        #! Power down for MIXB LO buffer
        #!     0 - Enabled
        #!     1 - Powered down
    ENDBITFIELD
    BITFIELD   CHC_MIXB_BIAS_PD0
        POSITION=3
        DEFAULT=1
        MODE=RWI
        #! Power down for MIXB bias
        #!     0 - Enabled
        #!     1 - Powered down
    ENDBITFIELD
    BITFIELD   CHC_MIXA_LOBUFF_PD0
        POSITION=2
        DEFAULT=1
        MODE=RWI
        #! Power down for MIXA LO buffer
        #!     0 - Enabled
        #!     1 - Powered down
    ENDBITFIELD
    BITFIELD   CHC_MIXA_BIAS_PD0
        POSITION=1
        DEFAULT=1
        MODE=RWI
        #! Power down for MIXA bias
        #!     0 - Enabled
        #!     1 - Powered down
    ENDBITFIELD
    BITFIELD   CHC_LNA_PD0
        POSITION=0
        DEFAULT=1
        MODE=RWI
        #! Power down for LNA
        #!     0 - Enabled
        #!     1 - Powered down
    ENDBITFIELD
ENDREGISTER

REGISTER    CHC_PD1    0x1045
    BITFIELD   CHC_PA_R50_EN1
        POSITION=7
        DEFAULT=1
        MODE=RWI
        #! Controls the switch in series with 50 Ohm resistor to ground at HFPAD input.
        #!     0 - Switch is open
        #!     1 - Switch is closed
    ENDBITFIELD
    BITFIELD   CHC_PA_BYPASS1
        POSITION=6
        DEFAULT=0
        MODE=RWI
        #! Controls the HFPAD bypass switches.
        #!     0 - HFPAD in not bypassed
        #!     1 - HFPAD is bypassed
        #! Note : HFPAD must be manually disabled when bypassed.
    ENDBITFIELD
    BITFIELD   CHC_PA_PD1
        POSITION=5
        DEFAULT=1
        MODE=RWI
        #! Power down for HFPAD
        #!     0 - Enabled
        #!     1 - Powered down
    ENDBITFIELD
    BITFIELD   CHC_MIXB_LOBUFF_PD1
        POSITION=4
        DEFAULT=1
        MODE=RWI
        #! Power down for MIXB LO buffer
        #!     0 - Enabled
        #!     1 - Powered down
    ENDBITFIELD
    BITFIELD   CHC_MIXB_BIAS_PD1
        POSITION=3
        DEFAULT=1
        MODE=RWI
        #! Power down for MIXB bias
        #!     0 - Enabled
        #!     1 - Powered down
    ENDBITFIELD
    BITFIELD   CHC_MIXA_LOBUFF_PD1
        POSITION=2
        DEFAULT=1
        MODE=RWI
        #! Power down for MIXA LO buffer
        #!     0 - Enabled
        #!     1 - Powered down
    ENDBITFIELD
    BITFIELD   CHC_MIXA_BIAS_PD1
        POSITION=1
        DEFAULT=1
        MODE=RWI
        #! Power down for MIXA bias
        #!     0 - Enabled
        #!     1 - Powered down
    ENDBITFIELD
    BITFIELD   CHC_LNA_PD1
        POSITION=0
        DEFAULT=1
        MODE=RWI
        #! Power down for LNA
        #!     0 - Enabled
        #!     1 - Powered down
    ENDBITFIELD
ENDREGISTER

REGISTER    CHC_PD2    0x1046
    BITFIELD   CHC_PA_R50_EN2
        POSITION=7
        DEFAULT=1
        MODE=RWI
        #! Controls the switch in series with 50 Ohm resistor to ground at HFPAD input.
        #!     0 - Switch is open
        #!     1 - Switch is closed
    ENDBITFIELD
    BITFIELD   CHC_PA_BYPASS2
        POSITION=6
        DEFAULT=0
        MODE=RWI
        #! Controls the HFPAD bypass switches.
        #!     0 - HFPAD in not bypassed
        #!     1 - HFPAD is bypassed
        #! Note : HFPAD must be manually disabled when bypassed.
    ENDBITFIELD
    BITFIELD   CHC_PA_PD2
        POSITION=5
        DEFAULT=1
        MODE=RWI
        #! Power down for HFPAD
        #!     0 - Enabled
        #!     1 - Powered down
    ENDBITFIELD
    BITFIELD   CHC_MIXB_LOBUFF_PD2
        POSITION=4
        DEFAULT=1
        MODE=RWI
        #! Power down for MIXB LO buffer
        #!     0 - Enabled
        #!     1 - Powered down
    ENDBITFIELD
    BITFIELD   CHC_MIXB_BIAS_PD2
        POSITION=3
        DEFAULT=1
        MODE=RWI
        #! Power down for MIXB bias
        #!     0 - Enabled
        #!     1 - Powered down
    ENDBITFIELD
    BITFIELD   CHC_MIXA_LOBUFF_PD2
        POSITION=2
        DEFAULT=1
        MODE=RWI
        #! Power down for MIXA LO buffer
        #!     0 - Enabled
        #!     1 - Powered down
    ENDBITFIELD
    BITFIELD   CHC_MIXA_BIAS_PD2
        POSITION=1
        DEFAULT=1
        MODE=RWI
        #! Power down for MIXA bias
        #!     0 - Enabled
        #!     1 - Powered down
    ENDBITFIELD
    BITFIELD   CHC_LNA_PD2
        POSITION=0
        DEFAULT=1
        MODE=RWI
        #! Power down for LNA
        #!     0 - Enabled
        #!     1 - Powered down
    ENDBITFIELD
ENDREGISTER

REGISTER    CHC_PD3    0x1047
    BITFIELD   CHC_PA_R50_EN3
        POSITION=7
        DEFAULT=1
        MODE=RWI
        #! Controls the switch in series with 50 Ohm resistor to ground at HFPAD input.
        #!     0 - Switch is open
        #!     1 - Switch is closed
    ENDBITFIELD
    BITFIELD   CHC_PA_BYPASS3
        POSITION=6
        DEFAULT=0
        MODE=RWI
        #! Controls the HFPAD bypass switches.
        #!     0 - HFPAD in not bypassed
        #!     1 - HFPAD is bypassed
        #! Note : HFPAD must be manually disabled when bypassed.
    ENDBITFIELD
    BITFIELD   CHC_PA_PD3
        POSITION=5
        DEFAULT=1
        MODE=RWI
        #! Power down for HFPAD
        #!     0 - Enabled
        #!     1 - Powered down
    ENDBITFIELD
    BITFIELD   CHC_MIXB_LOBUFF_PD3
        POSITION=4
        DEFAULT=1
        MODE=RWI
        #! Power down for MIXB LO buffer
        #!     0 - Enabled
        #!     1 - Powered down
    ENDBITFIELD
    BITFIELD   CHC_MIXB_BIAS_PD3
        POSITION=3
        DEFAULT=1
        MODE=RWI
        #! Power down for MIXB bias
        #!     0 - Enabled
        #!     1 - Powered down
    ENDBITFIELD
    BITFIELD   CHC_MIXA_LOBUFF_PD3
        POSITION=2
        DEFAULT=1
        MODE=RWI
        #! Power down for MIXA LO buffer
        #!     0 - Enabled
        #!     1 - Powered down
    ENDBITFIELD
    BITFIELD   CHC_MIXA_BIAS_PD3
        POSITION=1
        DEFAULT=1
        MODE=RWI
        #! Power down for MIXA bias
        #!     0 - Enabled
        #!     1 - Powered down
    ENDBITFIELD
    BITFIELD   CHC_LNA_PD3
        POSITION=0
        DEFAULT=1
        MODE=RWI
        #! Power down for LNA
        #!     0 - Enabled
        #!     1 - Powered down
    ENDBITFIELD
ENDREGISTER

REGISTER    CHC_LNA_CTRL0    0x1048
    BITFIELD   CHC_LNA_ICT_LIN0<4:0>
        POSITION=<15:11>
        DEFAULT=10000
        MODE=RWI
        #! Controls the bias current of linearization section of LNA
        #!     I = Inom * CHC_LNA_ICT_LIN/16
        #!     Default : 16
    ENDBITFIELD
    BITFIELD   CHC_LNA_ICT_MAIN0<4:0>
        POSITION=<10:6>
        DEFAULT=10000
        MODE=RWI
        #! Controls the bias current of main gm section of LNA
        #!     I = Inom * CHC_LNA_ICT_MAIN/16
        #!     Default : 16
    ENDBITFIELD
    BITFIELD   CHC_LNA_CGSCTRL0<1:0>
        POSITION=<5:4>
        DEFAULT=10
        MODE=RWI
    ENDBITFIELD
    BITFIELD   CHC_LNA_GCTRL0<3:0>
        POSITION=<3:0>
        DEFAULT=1000
        MODE=RWI
    ENDBITFIELD
ENDREGISTER

REGISTER    CHC_LNA_CTRL1    0x1049
    BITFIELD   CHC_LNA_ICT_LIN1<4:0>
        POSITION=<15:11>
        DEFAULT=10000
        MODE=RWI
        #! Controls the bias current of linearization section of LNA
        #!     I = Inom * CHC_LNA_ICT_LIN/16
        #!     Default : 16
    ENDBITFIELD
    BITFIELD   CHC_LNA_ICT_MAIN1<4:0>
        POSITION=<10:6>
        DEFAULT=10000
        MODE=RWI
        #! Controls the bias current of main gm section of LNA
        #!     I = Inom * CHC_LNA_ICT_MAIN/16
        #!     Default : 16
    ENDBITFIELD
    BITFIELD   CHC_LNA_CGSCTRL1<1:0>
        POSITION=<5:4>
        DEFAULT=10
        MODE=RWI
    ENDBITFIELD
    BITFIELD   CHC_LNA_GCTRL1<3:0>
        POSITION=<3:0>
        DEFAULT=1000
        MODE=RWI
    ENDBITFIELD
ENDREGISTER

REGISTER    CHC_LNA_CTRL2    0x104A
    BITFIELD   CHC_LNA_ICT_LIN2<4:0>
        POSITION=<15:11>
        DEFAULT=10000
        MODE=RWI
        #! Controls the bias current of linearization section of LNA
        #!     I = Inom * CHC_LNA_ICT_LIN/16
        #!     Default : 16
    ENDBITFIELD
    BITFIELD   CHC_LNA_ICT_MAIN2<4:0>
        POSITION=<10:6>
        DEFAULT=10000
        MODE=RWI
        #! Controls the bias current of main gm section of LNA
        #!     I = Inom * CHC_LNA_ICT_MAIN/16
        #!     Default : 16
    ENDBITFIELD
    BITFIELD   CHC_LNA_CGSCTRL2<1:0>
        POSITION=<5:4>
        DEFAULT=10
        MODE=RWI
    ENDBITFIELD
    BITFIELD   CHC_LNA_GCTRL2<3:0>
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
        DEFAULT=1
        MODE=RWI
    ENDBITFIELD
    BITFIELD   CHC_LNA_SEL1_INVERT
        POSITION=10
        DEFAULT=0
        MODE=RWI
    ENDBITFIELD
    BITFIELD   CHC_LNA_SEL1_MASK<8:0>
        POSITION=<8:0>
        DEFAULT=000000000
        MODE=RWI
    ENDBITFIELD
ENDREGISTER

REGISTER    CHC_PA_SEL0    0x1054
    BITFIELD   CHC_PA_SEL0_INTERNAL
        POSITION=11
        DEFAULT=1
        MODE=RWI
    ENDBITFIELD
    BITFIELD   CHC_PA_SEL0_INVERT
        POSITION=10
        DEFAULT=0
        MODE=RWI
    ENDBITFIELD
    BITFIELD   CHC_PA_SEL0_MASK<8:0>
        POSITION=<8:0>
        DEFAULT=000000000
        MODE=RWI
    ENDBITFIELD
ENDREGISTER

REGISTER    CHC_PA_SEL1    0x1055
    BITFIELD   CHC_PA_SEL1_INTERNAL
        POSITION=11
        DEFAULT=1
        MODE=RWI
    ENDBITFIELD
    BITFIELD   CHC_PA_SEL1_INVERT
        POSITION=10
        DEFAULT=0
        MODE=RWI
    ENDBITFIELD
    BITFIELD   CHC_PA_SEL1_MASK<8:0>
        POSITION=<8:0>
        DEFAULT=000000000
        MODE=RWI
    ENDBITFIELD
ENDREGISTER

REGISTER    CHC_INT_SEL    0x1056
    BITFIELD   CHC_PA_INT_SEL<1:0>
        POSITION=<5:4>
        DEFAULT=00
        MODE=RWI
    ENDBITFIELD
    BITFIELD   CHC_LNA_INT_SEL<1:0>
        POSITION=<3:2>
        DEFAULT=00
        MODE=RWI
    ENDBITFIELD
    BITFIELD   CHC_PD_INT_SEL<1:0>
        POSITION=<1:0>
        DEFAULT=00
        MODE=RWI
    ENDBITFIELD
ENDREGISTER

REGISTER    CHC_PD_RB    0x105D
    BITFIELD   CHC_PA_R50_EN_RB
        POSITION=7
        DEFAULT=CHC_PA_R50_EN0
        MODE=RB
        #! Readback the actual controlling value
    ENDBITFIELD
    BITFIELD   CHC_PA_BYPASS_RB
        POSITION=6
        DEFAULT=CHC_PA_BYPASS
        MODE=RB
        #! Readback the actual controlling value
    ENDBITFIELD
    BITFIELD   CHC_PA_PD_RB
        POSITION=5
        DEFAULT=CHC_PA_PD
        MODE=RB
        #! Readback the actual controlling value
    ENDBITFIELD
    BITFIELD   CHC_MIXB_LOBUFF_PD_RB
        POSITION=4
        DEFAULT=CHC_MIXB_LOBUFF_PD
        MODE=RB
        #! Readback the actual controlling value
    ENDBITFIELD
    BITFIELD   CHC_MIXB_BIAS_PD_RB
        POSITION=3
        DEFAULT=CHC_MIXB_BIAS_PD
        MODE=RB
        #! Readback the actual controlling value
    ENDBITFIELD
    BITFIELD   CHC_MIXA_LOBUFF_PD_RB
        POSITION=2
        DEFAULT=CHC_MIXA_LOBUFF_PD
        MODE=RB
        #! Readback the actual controlling value
    ENDBITFIELD
    BITFIELD   CHC_MIXA_BIAS_PD_RB
        POSITION=1
        DEFAULT=CHC_MIXA_BIAS_PD
        MODE=RB
        #! Readback the actual controlling value
    ENDBITFIELD
    BITFIELD   CHC_LNA_PD_RB
        POSITION=0
        DEFAULT=CHC_LNA_PD
        MODE=RB
        #! Readback the actual controlling value
    ENDBITFIELD
ENDREGISTER

REGISTER    CHC_LNA_CTRL_RB    0x105E
    BITFIELD   CHC_LNA_ICT_LIN_RB<4:0>
        POSITION=<15:11>
        DEFAULT=CHC_LNA_ICT_LIN<4:0>
        MODE=RB
        #! Readback the actual controlling value
    ENDBITFIELD
    BITFIELD   CHC_LNA_ICT_MAIN_RB<4:0>
        POSITION=<10:6>
        DEFAULT=CHC_LNA_ICT_MAIN<4:0>
        MODE=RB
        #! Readback the actual controlling value
    ENDBITFIELD
    BITFIELD   CHC_LNA_CGSCTRL_RB<1:0>
        POSITION=<5:4>
        DEFAULT=CHC_LNA_CGSCTRL<1:0>
        MODE=RB
        #! Readback the actual controlling value
    ENDBITFIELD
    BITFIELD   CHC_LNA_GCTRL_RB<3:0>
        POSITION=<3:0>
        DEFAULT=CHC_LNA_GCTRL<3:0>
        MODE=RB
        #! Readback the actual controlling value
    ENDBITFIELD
ENDREGISTER

REGISTER    CHC_PA_CTRL_RB    0x105F
    BITFIELD   CHC_PA_LIN_LOSS_RB<3:0>
        POSITION=<7:4>
        DEFAULT=CHC_PA_LIN_LOSS<3:0>
        MODE=RB
        #! Readback the actual controlling value
    ENDBITFIELD
    BITFIELD   CHC_PA_MAIN_LOSS_RB<3:0>
        POSITION=<3:0>
        DEFAULT=CHC_PA_MAIN_LOSS<3:0>
        MODE=RB
        #! Readback the actual controlling value
    ENDBITFIELD
ENDREGISTER

REGISTER    CHD_MIX_ICT    0x1060
    BITFIELD   CHD_MIXB_ICT<4:0>
        POSITION=<9:5>
        DEFAULT=10000
        MODE=RW
        #! Controls the bias current of polarization circuit
        #!     I = Inom * CHD_MIXB_ICT/16
        #!     Default : 16
    ENDBITFIELD
    BITFIELD   CHD_MIXA_ICT<4:0>
        POSITION=<4:0>
        DEFAULT=10000
        MODE=RW
        #! Controls the bias current of polarization circuit
        #!     I = Inom * CHD_MIXA_ICT/16
        #!     Default : 16
    ENDBITFIELD
ENDREGISTER

REGISTER    CHD_HFPAD_ICT    0x1061
    BITFIELD   CHD_PA_ILIN2X
        POSITION=10
        DEFAULT=0
        MODE=RW
        #! Double the linearization bias current
        #!     0 - Ilin * 1
        #!     1 - Ilin * 2
        #!     Default : 0
    ENDBITFIELD
    BITFIELD   CHD_PA_ICT_LIN<4:0>
        POSITION=<9:5>
        DEFAULT=10000
        MODE=RW
        #! Controls the bias current of linearization section of HFPAD
        #!     I = Inom * CHD_PA_ICT_LIN/16
        #!     Default : 16
    ENDBITFIELD
    BITFIELD   CHD_PA_ICT_MAIN<4:0>
        POSITION=<4:0>
        DEFAULT=10000
        MODE=RW
        #! Controls the bias current of main gm section of HFPAD
        #!     I = Inom * CHD_MIXA_ICT/16
        #!     Default : 16
    ENDBITFIELD
ENDREGISTER

REGISTER    CHD_PD0    0x1064
    BITFIELD   CHD_PA_R50_EN0
        POSITION=7
        DEFAULT=1
        MODE=RWI
        #! Controls the switch in series with 50 Ohm resistor to ground at HFPAD input.
        #!     0 - Switch is open
        #!     1 - Switch is closed
    ENDBITFIELD
    BITFIELD   CHD_PA_BYPASS0
        POSITION=6
        DEFAULT=0
        MODE=RWI
        #! Controls the HFPAD bypass switches.
        #!     0 - HFPAD in not bypassed
        #!     1 - HFPAD is bypassed
        #! Note : HFPAD must be manually disabled when bypassed.
    ENDBITFIELD
    BITFIELD   CHD_PA_PD0
        POSITION=5
        DEFAULT=1
        MODE=RWI
        #! Power down for HFPAD
        #!     0 - Enabled
        #!     1 - Powered down
    ENDBITFIELD
    BITFIELD   CHD_MIXB_LOBUFF_PD0
        POSITION=4
        DEFAULT=1
        MODE=RWI
        #! Power down for MIXB LO buffer
        #!     0 - Enabled
        #!     1 - Powered down
    ENDBITFIELD
    BITFIELD   CHD_MIXB_BIAS_PD0
        POSITION=3
        DEFAULT=1
        MODE=RWI
        #! Power down for MIXB bias
        #!     0 - Enabled
        #!     1 - Powered down
    ENDBITFIELD
    BITFIELD   CHD_MIXA_LOBUFF_PD0
        POSITION=2
        DEFAULT=1
        MODE=RWI
        #! Power down for MIXA LO buffer
        #!     0 - Enabled
        #!     1 - Powered down
    ENDBITFIELD
    BITFIELD   CHD_MIXA_BIAS_PD0
        POSITION=1
        DEFAULT=1
        MODE=RWI
        #! Power down for MIXA bias
        #!     0 - Enabled
        #!     1 - Powered down
    ENDBITFIELD
    BITFIELD   CHD_LNA_PD0
        POSITION=0
        DEFAULT=1
        MODE=RWI
        #! Power down for LNA
        #!     0 - Enabled
        #!     1 - Powered down
    ENDBITFIELD
ENDREGISTER

REGISTER    CHD_PD1    0x1065
    BITFIELD   CHD_PA_R50_EN1
        POSITION=7
        DEFAULT=1
        MODE=RWI
        #! Controls the switch in series with 50 Ohm resistor to ground at HFPAD input.
        #!     0 - Switch is open
        #!     1 - Switch is closed
    ENDBITFIELD
    BITFIELD   CHD_PA_BYPASS1
        POSITION=6
        DEFAULT=0
        MODE=RWI
        #! Controls the HFPAD bypass switches.
        #!     0 - HFPAD in not bypassed
        #!     1 - HFPAD is bypassed
        #! Note : HFPAD must be manually disabled when bypassed.
    ENDBITFIELD
    BITFIELD   CHD_PA_PD1
        POSITION=5
        DEFAULT=1
        MODE=RWI
        #! Power down for HFPAD
        #!     0 - Enabled
        #!     1 - Powered down
    ENDBITFIELD
    BITFIELD   CHD_MIXB_LOBUFF_PD1
        POSITION=4
        DEFAULT=1
        MODE=RWI
        #! Power down for MIXB LO buffer
        #!     0 - Enabled
        #!     1 - Powered down
    ENDBITFIELD
    BITFIELD   CHD_MIXB_BIAS_PD1
        POSITION=3
        DEFAULT=1
        MODE=RWI
        #! Power down for MIXB bias
        #!     0 - Enabled
        #!     1 - Powered down
    ENDBITFIELD
    BITFIELD   CHD_MIXA_LOBUFF_PD1
        POSITION=2
        DEFAULT=1
        MODE=RWI
        #! Power down for MIXA LO buffer
        #!     0 - Enabled
        #!     1 - Powered down
    ENDBITFIELD
    BITFIELD   CHD_MIXA_BIAS_PD1
        POSITION=1
        DEFAULT=1
        MODE=RWI
        #! Power down for MIXA bias
        #!     0 - Enabled
        #!     1 - Powered down
    ENDBITFIELD
    BITFIELD   CHD_LNA_PD1
        POSITION=0
        DEFAULT=1
        MODE=RWI
        #! Power down for LNA
        #!     0 - Enabled
        #!     1 - Powered down
    ENDBITFIELD
ENDREGISTER

REGISTER    CHD_PD2    0x1066
    BITFIELD   CHD_PA_R50_EN2
        POSITION=7
        DEFAULT=1
        MODE=RWI
        #! Controls the switch in series with 50 Ohm resistor to ground at HFPAD input.
        #!     0 - Switch is open
        #!     1 - Switch is closed
    ENDBITFIELD
    BITFIELD   CHD_PA_BYPASS2
        POSITION=6
        DEFAULT=0
        MODE=RWI
        #! Controls the HFPAD bypass switches.
        #!     0 - HFPAD in not bypassed
        #!     1 - HFPAD is bypassed
        #! Note : HFPAD must be manually disabled when bypassed.
    ENDBITFIELD
    BITFIELD   CHD_PA_PD2
        POSITION=5
        DEFAULT=1
        MODE=RWI
        #! Power down for HFPAD
        #!     0 - Enabled
        #!     1 - Powered down
    ENDBITFIELD
    BITFIELD   CHD_MIXB_LOBUFF_PD2
        POSITION=4
        DEFAULT=1
        MODE=RWI
        #! Power down for MIXB LO buffer
        #!     0 - Enabled
        #!     1 - Powered down
    ENDBITFIELD
    BITFIELD   CHD_MIXB_BIAS_PD2
        POSITION=3
        DEFAULT=1
        MODE=RWI
        #! Power down for MIXB bias
        #!     0 - Enabled
        #!     1 - Powered down
    ENDBITFIELD
    BITFIELD   CHD_MIXA_LOBUFF_PD2
        POSITION=2
        DEFAULT=1
        MODE=RWI
        #! Power down for MIXA LO buffer
        #!     0 - Enabled
        #!     1 - Powered down
    ENDBITFIELD
    BITFIELD   CHD_MIXA_BIAS_PD2
        POSITION=1
        DEFAULT=1
        MODE=RWI
        #! Power down for MIXA bias
        #!     0 - Enabled
        #!     1 - Powered down
    ENDBITFIELD
    BITFIELD   CHD_LNA_PD2
        POSITION=0
        DEFAULT=1
        MODE=RWI
        #! Power down for LNA
        #!     0 - Enabled
        #!     1 - Powered down
    ENDBITFIELD
ENDREGISTER

REGISTER    CHD_PD3    0x1067
    BITFIELD   CHD_PA_R50_EN3
        POSITION=7
        DEFAULT=1
        MODE=RWI
        #! Controls the switch in series with 50 Ohm resistor to ground at HFPAD input.
        #!     0 - Switch is open
        #!     1 - Switch is closed
    ENDBITFIELD
    BITFIELD   CHD_PA_BYPASS3
        POSITION=6
        DEFAULT=0
        MODE=RWI
        #! Controls the HFPAD bypass switches.
        #!     0 - HFPAD in not bypassed
        #!     1 - HFPAD is bypassed
        #! Note : HFPAD must be manually disabled when bypassed.
    ENDBITFIELD
    BITFIELD   CHD_PA_PD3
        POSITION=5
        DEFAULT=1
        MODE=RWI
        #! Power down for HFPAD
        #!     0 - Enabled
        #!     1 - Powered down
    ENDBITFIELD
    BITFIELD   CHD_MIXB_LOBUFF_PD3
        POSITION=4
        DEFAULT=1
        MODE=RWI
        #! Power down for MIXB LO buffer
        #!     0 - Enabled
        #!     1 - Powered down
    ENDBITFIELD
    BITFIELD   CHD_MIXB_BIAS_PD3
        POSITION=3
        DEFAULT=1
        MODE=RWI
        #! Power down for MIXB bias
        #!     0 - Enabled
        #!     1 - Powered down
    ENDBITFIELD
    BITFIELD   CHD_MIXA_LOBUFF_PD3
        POSITION=2
        DEFAULT=1
        MODE=RWI
        #! Power down for MIXA LO buffer
        #!     0 - Enabled
        #!     1 - Powered down
    ENDBITFIELD
    BITFIELD   CHD_MIXA_BIAS_PD3
        POSITION=1
        DEFAULT=1
        MODE=RWI
        #! Power down for MIXA bias
        #!     0 - Enabled
        #!     1 - Powered down
    ENDBITFIELD
    BITFIELD   CHD_LNA_PD3
        POSITION=0
        DEFAULT=1
        MODE=RWI
        #! Power down for LNA
        #!     0 - Enabled
        #!     1 - Powered down
    ENDBITFIELD
ENDREGISTER

REGISTER    CHD_LNA_CTRL0    0x1068
    BITFIELD   CHD_LNA_ICT_LIN0<4:0>
        POSITION=<15:11>
        DEFAULT=10000
        MODE=RWI
        #! Controls the bias current of linearization section of LNA
        #!     I = Inom * CHD_LNA_ICT_LIN/16
        #!     Default : 16
    ENDBITFIELD
    BITFIELD   CHD_LNA_ICT_MAIN0<4:0>
        POSITION=<10:6>
        DEFAULT=10000
        MODE=RWI
        #! Controls the bias current of main gm section of LNA
        #!     I = Inom * CHD_LNA_ICT_MAIN/16
        #!     Default : 16
    ENDBITFIELD
    BITFIELD   CHD_LNA_CGSCTRL0<1:0>
        POSITION=<5:4>
        DEFAULT=10
        MODE=RWI
    ENDBITFIELD
    BITFIELD   CHD_LNA_GCTRL0<3:0>
        POSITION=<3:0>
        DEFAULT=1000
        MODE=RWI
    ENDBITFIELD
ENDREGISTER

REGISTER    CHD_LNA_CTRL1    0x1069
    BITFIELD   CHD_LNA_ICT_LIN1<4:0>
        POSITION=<15:11>
        DEFAULT=10000
        MODE=RWI
        #! Controls the bias current of linearization section of LNA
        #!     I = Inom * CHD_LNA_ICT_LIN/16
        #!     Default : 16
    ENDBITFIELD
    BITFIELD   CHD_LNA_ICT_MAIN1<4:0>
        POSITION=<10:6>
        DEFAULT=10000
        MODE=RWI
        #! Controls the bias current of main gm section of LNA
        #!     I = Inom * CHD_LNA_ICT_MAIN/16
        #!     Default : 16
    ENDBITFIELD
    BITFIELD   CHD_LNA_CGSCTRL1<1:0>
        POSITION=<5:4>
        DEFAULT=10
        MODE=RWI
    ENDBITFIELD
    BITFIELD   CHD_LNA_GCTRL1<3:0>
        POSITION=<3:0>
        DEFAULT=1000
        MODE=RWI
    ENDBITFIELD
ENDREGISTER

REGISTER    CHD_LNA_CTRL2    0x106A
    BITFIELD   CHD_LNA_ICT_LIN2<4:0>
        POSITION=<15:11>
        DEFAULT=10000
        MODE=RWI
        #! Controls the bias current of linearization section of LNA
        #!     I = Inom * CHD_LNA_ICT_LIN/16
        #!     Default : 16
    ENDBITFIELD
    BITFIELD   CHD_LNA_ICT_MAIN2<4:0>
        POSITION=<10:6>
        DEFAULT=10000
        MODE=RWI
        #! Controls the bias current of main gm section of LNA
        #!     I = Inom * CHD_LNA_ICT_MAIN/16
        #!     Default : 16
    ENDBITFIELD
    BITFIELD   CHD_LNA_CGSCTRL2<1:0>
        POSITION=<5:4>
        DEFAULT=10
        MODE=RWI
    ENDBITFIELD
    BITFIELD   CHD_LNA_GCTRL2<3:0>
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
        DEFAULT=1
        MODE=RWI
    ENDBITFIELD
    BITFIELD   CHD_LNA_SEL1_INVERT
        POSITION=10
        DEFAULT=0
        MODE=RWI
    ENDBITFIELD
    BITFIELD   CHD_LNA_SEL1_MASK<8:0>
        POSITION=<8:0>
        DEFAULT=000000000
        MODE=RWI
    ENDBITFIELD
ENDREGISTER

REGISTER    CHD_PA_SEL0    0x1074
    BITFIELD   CHD_PA_SEL0_INTERNAL
        POSITION=11
        DEFAULT=1
        MODE=RWI
    ENDBITFIELD
    BITFIELD   CHD_PA_SEL0_INVERT
        POSITION=10
        DEFAULT=0
        MODE=RWI
    ENDBITFIELD
    BITFIELD   CHD_PA_SEL0_MASK<8:0>
        POSITION=<8:0>
        DEFAULT=000000000
        MODE=RWI
    ENDBITFIELD
ENDREGISTER

REGISTER    CHD_PA_SEL1    0x1075
    BITFIELD   CHD_PA_SEL1_INTERNAL
        POSITION=11
        DEFAULT=1
        MODE=RWI
    ENDBITFIELD
    BITFIELD   CHD_PA_SEL1_INVERT
        POSITION=10
        DEFAULT=0
        MODE=RWI
    ENDBITFIELD
    BITFIELD   CHD_PA_SEL1_MASK<8:0>
        POSITION=<8:0>
        DEFAULT=000000000
        MODE=RWI
    ENDBITFIELD
ENDREGISTER

REGISTER    CHD_INT_SEL    0x1076
    BITFIELD   CHD_PA_INT_SEL<1:0>
        POSITION=<5:4>
        DEFAULT=00
        MODE=RWI
    ENDBITFIELD
    BITFIELD   CHD_LNA_INT_SEL<1:0>
        POSITION=<3:2>
        DEFAULT=00
        MODE=RWI
    ENDBITFIELD
    BITFIELD   CHD_PD_INT_SEL<1:0>
        POSITION=<1:0>
        DEFAULT=00
        MODE=RWI
    ENDBITFIELD
ENDREGISTER

REGISTER    CHD_PD_RB    0x107D
    BITFIELD   CHD_PA_R50_EN_RB
        POSITION=7
        DEFAULT=CHD_PA_R50_EN0
        MODE=RB
        #! Readback the actual controlling value
    ENDBITFIELD
    BITFIELD   CHD_PA_BYPASS_RB
        POSITION=6
        DEFAULT=CHD_PA_BYPASS
        MODE=RB
        #! Readback the actual controlling value
    ENDBITFIELD
    BITFIELD   CHD_PA_PD_RB
        POSITION=5
        DEFAULT=CHD_PA_PD
        MODE=RB
        #! Readback the actual controlling value
    ENDBITFIELD
    BITFIELD   CHD_MIXB_LOBUFF_PD_RB
        POSITION=4
        DEFAULT=CHD_MIXB_LOBUFF_PD
        MODE=RB
        #! Readback the actual controlling value
    ENDBITFIELD
    BITFIELD   CHD_MIXB_BIAS_PD_RB
        POSITION=3
        DEFAULT=CHD_MIXB_BIAS_PD
        MODE=RB
        #! Readback the actual controlling value
    ENDBITFIELD
    BITFIELD   CHD_MIXA_LOBUFF_PD_RB
        POSITION=2
        DEFAULT=CHD_MIXA_LOBUFF_PD
        MODE=RB
        #! Readback the actual controlling value
    ENDBITFIELD
    BITFIELD   CHD_MIXA_BIAS_PD_RB
        POSITION=1
        DEFAULT=CHD_MIXA_BIAS_PD
        MODE=RB
        #! Readback the actual controlling value
    ENDBITFIELD
    BITFIELD   CHD_LNA_PD_RB
        POSITION=0
        DEFAULT=CHD_LNA_PD
        MODE=RB
        #! Readback the actual controlling value
    ENDBITFIELD
ENDREGISTER

REGISTER    CHD_LNA_CTRL_RB    0x107E
    BITFIELD   CHD_LNA_ICT_LIN_RB<4:0>
        POSITION=<15:11>
        DEFAULT=CHD_LNA_ICT_LIN<4:0>
        MODE=RB
        #! Readback the actual controlling value
    ENDBITFIELD
    BITFIELD   CHD_LNA_ICT_MAIN_RB<4:0>
        POSITION=<10:6>
        DEFAULT=CHD_LNA_ICT_MAIN<4:0>
        MODE=RB
        #! Readback the actual controlling value
    ENDBITFIELD
    BITFIELD   CHD_LNA_CGSCTRL_RB<1:0>
        POSITION=<5:4>
        DEFAULT=CHD_LNA_CGSCTRL<1:0>
        MODE=RB
        #! Readback the actual controlling value
    ENDBITFIELD
    BITFIELD   CHD_LNA_GCTRL_RB<3:0>
        POSITION=<3:0>
        DEFAULT=CHD_LNA_GCTRL<3:0>
        MODE=RB
        #! Readback the actual controlling value
    ENDBITFIELD
ENDREGISTER

REGISTER    CHD_PA_CTRL_RB    0x107F
    BITFIELD   CHD_PA_LIN_LOSS_RB<3:0>
        POSITION=<7:4>
        DEFAULT=CHD_PA_LIN_LOSS<3:0>
        MODE=RB
        #! Readback the actual controlling value
    ENDBITFIELD
    BITFIELD   CHD_PA_MAIN_LOSS_RB<3:0>
        POSITION=<3:0>
        DEFAULT=CHD_PA_MAIN_LOSS<3:0>
        MODE=RB
        #! Readback the actual controlling value
    ENDBITFIELD
ENDREGISTER

REGISTER    HLMIXA_CONFIG0    0x2000
    BITFIELD   HLMIXA_VGCAS0<6:0>
        POSITION=<13:7>
        DEFAULT=1000000
        MODE=RWI
    ENDBITFIELD
    BITFIELD   HLMIXA_ICT_BIAS0<4:0>
        POSITION=<6:2>
        DEFAULT=10000
        MODE=RWI
    ENDBITFIELD
    BITFIELD   HLMIXA_BIAS_PD0
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
        DEFAULT=1
        MODE=RWI
    ENDBITFIELD
    BITFIELD   HLMIXD_LOSS_SEL0_INVERT
        POSITION=10
        DEFAULT=0
        MODE=RWI
    ENDBITFIELD
    BITFIELD   HLMIXD_LOSS_SEL0_MASK<8:0>
        POSITION=<8:0>
        DEFAULT=000000000
        MODE=RWI
    ENDBITFIELD
ENDREGISTER

REGISTER    HLMIXD_LOSS_SEL1    0x203B
    BITFIELD   HLMIXD_LOSS_SEL1_INTERNAL
        POSITION=11
        DEFAULT=1
        MODE=RWI
    ENDBITFIELD
    BITFIELD   HLMIXD_LOSS_SEL1_INVERT
        POSITION=10
        DEFAULT=0
        MODE=RWI
    ENDBITFIELD
    BITFIELD   HLMIXD_LOSS_SEL1_MASK<8:0>
        POSITION=<8:0>
        DEFAULT=000000000
        MODE=RWI
    ENDBITFIELD
ENDREGISTER

REGISTER    HLMIXD_INT_SEL    0x203C
    BITFIELD   HLMIXD_LOSS_INT_SEL<1:0>
        POSITION=<3:2>
        DEFAULT=00
        MODE=RWI
    ENDBITFIELD
    BITFIELD   HLMIXD_CONF_INT_SEL<1:0>
        POSITION=<1:0>
        DEFAULT=00
        MODE=RWI
    ENDBITFIELD
ENDREGISTER
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
