myriadrf/LMS8001-Companion/(commit log)

2017-10-18 Corrected links
    Just corrected couple of links in a document.
2025-08-01 Add 3v1 hardware design.
    [12402143E512A.step, Clocks.sch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]
2025-08-06 Moved firmware to dedicated repo and updated licences.
    [st_nucleo_f4_lms8001.cfg]
2026-10-27 Moved Windows drivers to downloads host.
2026-10-27 Update docs to note where Windows drivers are.
